zhangguotao05-zgt/iwatch/README.md

# iwatch

基于 SF32LB58、RT-Thread 和 LVGL 9.4 的智能手表项目。当前硬件验证平台为 SF32LB58-DevKit-LCD A128R32N1，显示模组为 390×450 QSPI AMOLED（CO5300 + FT6146）；自研原理图选型为 SF32LB586VDD36。

工程说明统一采用 HTML：

- [文档首页](index.html)
- [架构复审与开发基线 v1.1](docs/ui/架构复审与开发基线_v1.1.html)
- [功能逻辑与页面契约](docs/ui/功能逻辑与页面契约_v1.html)
- [模块接口、开发任务与测试矩阵](docs/ui/模块接口与开发任务_v1.html)
- [系统架构 v1.1](docs/ui/系统架构_v1.1.html)
- [视觉与交互规范 v1](docs/ui/视觉与交互规范_v1.html)
- [Apple Watch 设计指南研究与项目适配](docs/ui/Apple_Watch设计指南研究与项目适配_v1.html)
- [Apple Watch 界面复刻定稿 v2（首批七页施工入口）](docs/ui/Apple_Watch界面复刻定稿_v2.html)
- [Apple Watch 功能差距与复刻验收矩阵（当前差距、视觉问题与 D14–D18 清单）](docs/ui/Apple_Watch功能差距与复刻验收矩阵_v1.html)
- [实施与验收记录](docs/ui/实施与验收_v1.html)
- [D01–D03 板上验收记录](docs/ui/D01-D03_实施记录.html)
- [D04–D05 时间与最小服务实施记录](docs/ui/D04-D05_实施记录.html)
- [D06 显示目标与会话亮度实施记录](docs/ui/D06_显示目标与会话亮度实施记录.html)
- [D07 资源预算与共享组件设计方案 v2](docs/ui/D07_资源预算与共享组件设计方案_v2.html)
- [D07-A0 工具与安全链实施记录](docs/ui/D07-A0_工具与安全链实施记录.html)
- [D07-A1 字体替换与渲染修复记录](docs/ui/D07-A1_字体替换与渲染修复记录.html)
- [D07-B 字体服务与主题实施记录](docs/ui/D07-B_字体服务与主题实施记录.html)
- [D07-C 共享组件与页面回收实施记录](docs/ui/D07-C_共享组件与页面回收实施记录.html)
- [D07-D 组件展示与综合验收记录](docs/ui/D07-D_组件展示与综合验收记录.html)
- [D08 页面作用域与路由实施记录](docs/ui/D08_页面作用域与路由实施记录.html)
- [D09 双键语义与输入仲裁实施记录](docs/ui/D09_双键语义与输入仲裁实施记录.html)
- [D10 首批七页实施记录](docs/ui/D10_首批七页实施记录.html)
- [D11 计时器与秒表实施记录](docs/ui/D11_计时器与秒表实施记录.html)
- [D12 闹钟与全局提醒实施记录](docs/ui/D12_闹钟与全局提醒实施记录.html)
- [D13 系统覆盖层与表盘管理设计 v2](docs/ui/D13_系统覆盖层与表盘管理设计_v2.html) · [390×450 页面视觉目标](docs/ui/D13_系统页面视觉目标_v1.html) · [D13-C 锁与输入仲裁实施记录](docs/ui/D13-C_锁与输入仲裁实施记录.html) · [D13-D 表盘会话与总体收口实施记录](docs/ui/D13-D_表盘会话与总体收口实施记录.html)
- [Series 11 界面覆盖计划](docs/UI复刻计划_watchOS26.html)
- [固件构建与调试](firmware/README.html)
- [硬件原理图 v0.3](hardware/原理图_v0.3_封装与接口完善/阅读说明.html)

开发任务使用 [GitHub Issues](https://github.com/zhangguotao05-zgt/iwatch/issues) 跟踪。任务实际开始时才创建对应的 Dxx Issue；完成后补齐提交、主机测试、双工具链和开发板证据，再以 `completed` 关闭。D01–D05 已按此规则补录为 [#1–#5](https://github.com/zhangguotao05-zgt/iwatch/issues?q=is%3Aissue+is%3Aclosed+label%3Atask)；[D06 · #6](https://github.com/zhangguotao05-zgt/iwatch/issues/6) 已完成；[D07 · #7](https://github.com/zhangguotao05-zgt/iwatch/issues/7) 已通过并关闭。性能遗留项由 [#8](https://github.com/zhangguotao05-zgt/iwatch/issues/8) 独立跟踪，[D08 · #9](https://github.com/zhangguotao05-zgt/iwatch/issues/9) 已按“接受已知风险”批准收口；[显示异常 #10](https://github.com/zhangguotao05-zgt/iwatch/issues/10) 保持打开，允许接续 D09。

D08 按“接受已知风险”收口，验收基线 `5c51f54`、固件源码 `82ab706`：基础实现及已验证功能通过，负责人同意将显示异常独立跟踪并继续 D09。首轮半黑半白转入 [#10](https://github.com/zhangguotao05-zgt/iwatch/issues/10)，仍未定位、后续未复现；性能遗留继续跟踪 [#8](https://github.com/zhangguotao05-zgt/iwatch/issues/8)。首次异常、采集缺口和原始证据保持封存，此决定不代表显示异常已修复或产品发布验收通过。

D01–D03 已完成页面生命周期、BSP/分区/双工具链来源、GUI 等待/唤醒和输入取消实现，并在开发板上完成备份、三件套写入校验、冷启动、输入压力、显示超时恢复和黑屏触摸唤醒验收。D04/D05 已完成时间、启动协调、32 B 命令、48 B 结果、固定账本与快照，并通过主机、双工具链及开发板校时、软件复位和断电冷启动验收；断电后 RTC 正确失效，服务使用 TRNG 生成非零 31 位随机 session，该值只降低碰撞概率，不作为唯一性或安全保证。DEV_A128_NAND 的 main 位于 `0x69000000`，必须与同一归档的 Bootloader、FTab 成套烧录。

D06 已实现 `SET_BRIGHTNESS`、目标/实际/持久状态、最新目标 mailbox 和 GUI owner 驱动确认；只有 LCD 状态、busy、写入后状态及亮度回读全部通过才返回 `OK_APPLIED`。首次显示、触摸 reassert 与故障恢复均读取当前目标，亮度 revision 饱和时失败无副作用。持久值仍明确为会话状态，真实 NAND 保存留 D15。最终 GCC main 为 5,745,568 B，双工具链身份、三件套写后校验、20%/80% 实屏变化、故障结果、软件复位和输入压力均已通过开发板复验。

D07 v2 已以 `967483d` 为批准基线。D07-A1 已获架构审批通过，收口提交为 e064686。D07-B 已获架构阶段验收通过（审批基线 7dfd90d）。D07-C 已获架构阶段验收通过（审批基线 c8392a9）。D07 已获最终审批（基线 9088f52，固件源码 5d66e58），Issue #7 已关闭。触摸溢出取消整改通过；长文延迟与溢出频率转入独立性能待办 #8，历史最大 215 ms 保留，不宣称全面性能达标。D08 已按“接受已知风险”批准收口（验收基线 5c51f54，固件源码 82ab706）；显示异常转入 Issue #10，未定位、后续未复现，性能遗留继续跟踪 Issue #8，允许开始 D09 输入，随后推进 D10 正式界面。 D07 验收时字体为 336 字符、56,804 B；D10 已扩展为 389 字符、65,752 B，并完成首轮上板和首次校时整改复验。A1 最终整改镜像在 20%/80% 下文字与操作正常，8 次进出后的主堆和字形池均回到启动值；这条是 A1 历史证据。详见 [安全整改记录](docs/ui/D07-A1_安全整改与复验记录.html)。`flash1` 的 FAL 持久化、低功耗和长期测试仍未关闭。

D09 已获架构审批通过（审批基线 `042ba6f`、固件源码 `05fb667`），[Issue #11](https://github.com/zhangguotao05-zgt/iwatch/issues/11) 按 completed 收口。已修复 Home 动画停住与水锁触摸穿透，主机、双工具链、当前镜像实体双键及 20%/80% 通知回归通过。详见 [D09 实施记录](docs/ui/D09_双键语义与输入仲裁实施记录.html)。主堆小幅波动、最大 133 ms 队列延迟、六次触摸溢出及 #8/#10 边界保留，允许进入 D10；本次收口不重新烧录。

D10 的七页、校时和亮度服务已接入。源码 `7cc8bcf` 补齐选择器拖动吸附、大字号重排、真实字体换行、绘制批次采样及本轮外观反馈；主机、GCC／Keil 和 COM9/COM10 板测均已完成。已补三轮表盘／应用列表／设置五页往返与 V08 首绘、停顿、诊断开销对照，结果提交架构复核；跨页转场降级、#8 性能、#10 显示异常及 `flash1` 持久化继续保持跟踪；D10 当前范围已获架构审批通过，Issue #12 已收口，详见 [界面完善与复核交接](docs/ui/D10_界面完善与复核交接.html)。

D11 已按审批基线 `d2a0691`、固件源码 `e6fc348` 收口，Issue #13 按 completed 关闭，允许进入 D12。容量释放后按钮恢复、原版与补丁 SDK 隔离、主机回归、双工具链身份及 COM9／COM10 实机复验均通过；精确竞态由主机测试覆盖，实机验证的是满额→取消→再次新增。正式字体仍为 406 字符、69,004 B。#8 性能、#10 显示异常与持久化继续独立跟踪；闹钟及提醒输出归 D12。详见 [D11 实施记录](docs/ui/D11_计时器与秒表实施记录.html)。

D12 已按审批基线 `62f0686`、固件源码 `9fa21c8` 在“会话内闹钟＋全局视觉提醒”范围收口，Issue #14 按 completed 关闭。[实施与验收记录](docs/ui/D12_闹钟与全局提醒实施记录.html)分别归档初版、三项状态整改及独立审批。#8 性能、#10 显示异常和 D15 持久化继续跟踪；声音、振动、断电保存及长期稳定性不属于本次验收。允许进入 D13。

D13-A 以 `c7617c2` 获架构批准，D13-B 增量已完成控制中心、通知、叠放和切换器实现。D13-C 锁与输入仲裁增量以源码 `49d461f` 完成架构复核和开发板验收：实体 KEY2 可打开控制中心，普通锁／水锁均支持 KEY1 长按约 2 秒并真实松手解锁，锁页和控制中心正确销毁并返回根页；水锁下的触摸与 KEY2 屏蔽已通过板上诊断注入验证。实体触摸面板本轮未单独确认，不能把诊断注入写成实体触摸通过。详细边界见 [D13-C 记录](docs/ui/D13-C_锁与输入仲裁实施记录.html)。

D13-D 的代码修正提交为 `a2e61fd`：长按进入选择器，支持 DIGITAL/MODULAR_LOCAL 两个稳定表盘 ID、颜色/中心/左右快捷入口草稿、取消、revision 冲突和能力失败回滚；提交成功后同步根页模型，Home 与 Apply 同周期时撤销 pending，tick 从 0 开始也能触发 3 秒超时回滚。表盘候选只有在根页异步 `ONRESUME` 成功且稳定快照确认后才提交，请求拒绝、异步失败、故障回收和重复返回均回滚。主机产品矩阵、46 项隔离 clean-base Python 门禁已通过；GCC/Keil 已重新构建并生成绑定源码 HEAD、工具链和 SDK 的身份归档，GCC/Keil `main.bin` 分别为 1,952,020 B/1,877,184 B。与 `e324f14` 归档绑定的 GCC 三件套已经由 COM9 写入并校验，COM10 原始日志 `work/d13d-board-e324/serial.raw` 为 28,798 字节，SHA-256 为 `d9d2854aa2c0c0c49d02c86ec2c536194fb0019b8b0038cd65306e40db8303de`；正确的 `iwface/root` 表盘编辑、根页异步提交确认、取消和重复进出均已实机记录。`2892732` 是实机证据基线，`8587d13` 是文档内容基线，`b7d51aa` 是状态提交；D13-D 已获架构复核通过，`main` 已推送；Issue #15 暂不关闭。#8 性能、#10 显示异常和 D15 持久化继续保持打开。详见 [D13-D 记录](docs/ui/D13-D_表盘会话与总体收口实施记录.html)。

Apple Watch 功能范围与复刻差距已单独整理为 [功能差距与复刻验收矩阵](docs/ui/Apple_Watch功能差距与复刻验收矩阵_v1.html)。工程师按矩阵中的 A/B/C/D/E 状态、D14–D18 顺序和“主机／目标构建／实机”三层证据推进；知乎文章仅作功能索引，不把规划清单或示意图当作已实现页面。联网、支付、健康传感器算法、触感／音频和量产硬件能力仍不属于当前离线 UI 交付。
