zhangguotao05-zgt/iwatch/hardware/自研智能手表_离线阶段方案_v0.4.html

iwatch 自研智能手表：离线第一阶段 v0.4

# 自研智能手表：离线第一阶段 v0.4

更新日期：2026-09-22。本阶段以本版为准，v0.3 的联网/官方应用整机路线保留为后续参考。当前 UI 复刻和 D13-D 实机验证基线见功能差距与复刻验收矩阵。

推荐：SF32LB58 + 配套 AMOLED + RT-Thread/LVGL + 真实心率血氧模块。先开发板验证，再做自研主板和新外壳。

阶段边界：表盘、系统壳层和离线工具可先做界面与空态；健康、运动、联网、支付、触感和音频必须等对应硬件/Provider 验证后再写成真实能力。当前实机固件验证使用 A128R32N1，文中 N16 仍是采购规划，不能混写。

## 当前做什么

- Apple Watch 风格的表盘、蜂窝图标、列表、控制中心、设置和动画。
- 表冠旋转/按压、触摸、侧键、振动、抬腕和休眠。
- 本地时间、闹钟、计时器、秒表；手动或有线校时。
- 真实心率、静止血氧、计步与活动记录，保存在本机。
- 后段设计自己的主板、健康传感板和外壳。

Wi-Fi、4G/eSIM、云服务、官方微信/支付宝、通话和在线应用不纳入本阶段。蓝牙硬件随 SF58 保留，第一阶段先不开发同步功能，整机按无线关闭条件验收。ECG、腕温、NFC、GNSS 和复杂健康算法后续再集成。

## 主控与第一批采购

采购规划选择 SF32LB58-DevKit-LCD，N16R32N1，配套 AMOLED 套餐。这块板适合本阶段的显示、触摸和传感器开发；官方提供资料与 USB 转 UART 烧录/调试方式。当前 D13-D 实机证据使用的是 A128R32N1 / A1 变体，构建、分区和资源结论必须绑定实际板卡。SF58 开发板官方指南 (https://wiki.sifli.com/board/sf32lb58x/SF32LB58-DevKit-LCD.html)

N16R32N1 使用 16 MB NOR，A128R32N1 使用 128 MB NAND，PSRAM 配置同为 16+16 MB。本阶段优先 NOR 版本，减少首轮文件系统与存储调试工作。现有 SDK 工程应匹配实际板卡版本和屏幕。SiFli 模组型号指南 (https://wiki.sifli.com/silicon/%E6%A8%A1%E7%BB%84%E5%9E%8B%E5%8F%B7%E6%8C%87%E5%8D%97.html)，SiFli SDK (https://github.com/OpenSiFli/SiFli-SDK)

采购时应选择包含“DevKit+AMOLED屏”的套餐，并确认配套转接板、排线、触摸驱动、可编译示例和烧录文件。页面截图中的价格与选项不能作为该组合的有效报价。首批物料为板屏套件和数据线，先验证原厂触摸/显示例程；健康模块在显示链路稳定后接入。

开发板本身不具备心率/血氧测量能力，需要外接健康硬件。

## 屏幕与流畅度

截图中的小屏为 1.85 英寸、390×450、QSPI 显示、I2C 触摸。开发板支持 MIPI-DSI，但这不代表配套小屏就是 MIPI。先用配套屏把 UI 做起来，目标仍是 60 fps，然后测真实帧率、触摸延迟与功耗。

QSPI 50 MHz、4 bit、SDR 的理论吞吐量为 25 MB/s。390×450 一帧 RGB888 为 526,500 byte，单纯传输约 21.06 ms，已超过 60 fps 的 16.67 ms 周期；RGB565 若能在线上传输 16 bit/pixel，理论传输约 14.04 ms，实际仍需开销与渲染时间。只有屏幕控制器和驱动支持对应总线像素格式，16 位传输预算才成立；内部用 RGB565 渲染不等于线上一定传 16 位。

先测试 DMA、图形加速、局部刷新、帧缓冲布局和动画复杂度。若配套屏无法满足关键全屏动画，再评估 MIPI 面板与驱动。MIPI 升级是换屏/转接/驱动工作，不是把原 QSPI 屏的软件设置改一下。显示接口能力见 SF58 硬件设计指南 (https://wiki.sifli.com/en/hardware/SF32LB58x-HW-Application.html)。

## 健康链路保留

采用上一版已经复核的 MAXM86146 + 外部 LED + LSM6DSO 候选。先评估 MAXM86146EVSYS 的固件/GUI 和实际供货，再连接 SF58。MAXM86146 内含光学 AFE、算法 MCU 和双 PD，仍需要发光器件、运动样本和光学隔离。MAXM86146 产品页 (https://www.analog.com/en/products/maxm86146.html)，MAXM86146EVSYS (https://www.analog.com/en/resources/evaluation-hardware-and-software/evaluation-boards-kits/maxm86146evsys.html)

LSM6DSO 由 SF58 采集，再按算法支持的主机供数协议送入健康模块，必须核对固件版本、采样率、单位、坐标和同步。不要复制已停产的 LIS2DS12；也不要把新 IMU 当成算法内部驱动的直接替代。ADI 加速度兼容性 FAQ (https://ez.analog.com/other-products/a/documents/do21669/what-accelerometers-are-supported-by-the-max32664c-firmware)，ST LSM6DSO (https://www.st.com/en/mems-and-sensors/lsm6dso.html)，ST LIS2DS12 (https://www.st.com/en/mems-and-sensors/lis2ds12.html)

健康输出分清原始波形、算法数值和质量标志。先验证静止测量、佩戴松紧及无效状态，再优化运动心率。参考血氧仪的对照仅作工程一致性检查，不把它当作完整临床精度验证。UI 演示阶段的数据须标为示例，实测界面只显示有效测量。

## 自研板怎么落地

第一块自研板建议采用 SF32LB58-MOD-N16R32N1 模组 + 自研载板，模组为 24×24 mm；载板连接屏幕、健康板、表冠、马达、电池与充电电路。待接口、功耗和体积明确后，再决定紧凑版是否使用 SF32LB586VDD36 裸芯片。模组已经包含的内存和晶体不应重复装配。SiFli 模组型号指南 (https://wiki.sifli.com/silicon/%E6%A8%A1%E7%BB%84%E5%9E%8B%E5%8F%B7%E6%8C%87%E5%8D%97.html)

主系统先按最高 240 MHz 运行验证，后续按负载降频。外部时钟为 48 MHz 与 32.768 kHz；供电按 SF58/模组参考设计处理。SF30147C 为可穿戴电源候选，充电器/电芯参数另外匹配，不直接把电池接到任意 1.8 V/3.3 V 电源脚。SF32LB58X 产品页 (https://www.sifli.com/zh-hans/node/29)，SF58 硬件设计指南 (https://wiki.sifli.com/en/hardware/SF32LB58x-HW-Application.html)

资源初值：两块 RGB565 全屏缓冲约 0.67 MiB；暂为图形资源/缓存留 8 MiB、应用堆 2 MiB，实际按分散的 PSRAM 区域与 SDK map 文件分配。内部 SRAM 保留给栈、DMA/实时工作区，不能把总 PSRAM 当成一块可随意分配的连续堆。16 MB 外部 NOR 暂按固件 6 MiB、界面资源 6 MiB、摘要/配置 2 MiB、余量 2 MiB 规划，最终以链接与文件系统结果调整；原始 PPG 调试数据优先导出 PC，不长期堆积在 NOR。

续航以实测为准。400 mAh、3.85 V、85% 可用系数仅作为预算假设；24 h 目标对应约 54.5 mW 平均电池侧功耗。没有联网仍需优化显示、PPG、唤醒和漏电；开发板电流不能直接当作最终手表电流。

## 顺序与完成标准

阶段 | 工作 | 完成标准
1 | 板屏例程、烧录与日志 | 可从源码编译，屏幕/触摸稳定，有恢复下载路径
2 | 自研 UI、表冠、LRA | 蜂窝/列表/表盘可操作，记录帧时延，验证休眠唤醒
3 | IMU 与健康评估板 | 有真实数据及质量标志，供数同步稳定，保存本地摘要
4 | 载板、健康板、外壳样件 | 完成电压域检查、3D 堆叠、封壳功耗和佩戴测试

调试时用 UART 日志、逻辑分析仪检查 I2C/QSPI/中断，结合 DMA/FIFO 计数检查丢样和撕裂。中断只通知任务；UI、传感器采集和存储分任务处理。测试栈/堆高水位、掉电记录恢复、闹钟与看门狗，保留 BOOT/RESET/UART/SWD 调试点。

后续如只增加天气/健康同步，可继续评估 SF58 的通信扩展；如重新要求官方微信和支付宝应用，需再次核实系统与平台接入，不能承诺只加网络硬件就能实现。

本版完成范围与选型更新，尚未采购或进行硬件测试。未核实的价格保持空缺；配套 Excel 为选型 BOM，原理图完成后再展开生产位号和无源器件。

iwatch 工程文档 · SF32LB58 / RT-Thread / LVGL
