zhangguotao05-zgt/iwatch/hardware/4mm磁吸母头封装/使用说明.html

iwatch 4mm 磁吸母头 PCB 封装草稿 R01

# 4mm 磁吸母头 PCB 封装草稿 R01

已按项目存档的机械 PDF 制作嘉立创 EDA 专业版封装草稿。所有表格和设计参数的单位为 mm。 本文为可编辑的工程草稿：侧脚厚度和底座外径包含按图形比例得到的估算值，槽孔中心距属于初始设计取值，投板前必须按实物复核。

## 导入与使用

1. 在嘉立创 EDA 专业版选择 文件 → 导入 → 嘉立创EDA（专业版）。
2. 首选导入 4mm磁吸母头_嘉立创专业版_封装草稿.epro。它含一个放置了该封装的 PCB 预览页，未画生产板框。
3. 导入时可提取封装库；也可打开工程后，在工程库中找到 CON-MAGNETIC-F-4MM-TH_DRAFT_R01 并另存到自己的封装库。
4. 同目录的 .efoo 是独立封装源码；支持独立封装文件的导入界面可直接选择它。
5. 后续在器件编辑器绑定封装，按实际电气连接映射焊盘编号。

导入流程依据：嘉立创 EDA 专业版官方导入说明 (https://prodocs.lceda.cn/cn/import-export/import-easyeda-pro/)。 本次完成了本地文件结构与几何校核，未声称已在 EDA 编辑器里导入成功或通过原生 DRC。

## 焊盘定义

PCB 顶视图，原点为中心针，X 向右，Y 向上。尺寸均为旋转后的实际 X/Y 尺寸。

编号 | 位置 | 中心 X | 中心 Y | 铜尺寸 X × Y | 孔尺寸 X × Y | 孔型
1 | 中心针 | 0 | 0 | Ø1.40 | Ø0.80 | 镀铜圆孔
2 | 左侧脚 | -1.70 | 0 | 1.50 × 2.50 | 0.90 × 1.90 | 镀铜长圆槽孔
3 | 右侧脚 | +1.70 | 0 | 1.50 × 2.50 | 0.90 × 1.90 | 镀铜长圆槽孔

槽孔尺寸为两端外缘之间的完整尺寸，不是铣刀移动行程。原生源码用 SLOT + OVAL 并旋转 90° 表示竖向槽；三个焊盘均为 Multi-Layer，孔壁镀铜。 所列孔径是封装中的设计孔径，实际成品孔及公差需和板厂确认。 本图没有电气定义：1/2/3 是本草稿的物理编号，未指定正负极，也未把两侧脚强制设成同一个编号或网络。确认两侧共通后，可在原理图接至同一网络并核对符号映射。

## 图纸标注与推算依据

图纸直接标注：上台阶 Ø4.00、接触端孔 Ø1.10、本体高 3.50、台阶高 1.30、出脚长 2.00、中心针 Ø0.50、侧脚宽 1.25、侧脚外圆弧 R2。

图形比例推算：以已标注的 Ø4.00、Ø0.50 及 1.25 为比例交叉参照，底座直径约 Ø5.00，侧脚内圆弧半径约 1.50，径向壁厚约 0.50。R2 标注的箭头尖落在侧脚外弧，不是最外侧底座圆。

侧脚是圆弧截面，不能简单把 0.50 × 1.25 矩形当作完整脚形。按推算的内 R1.50 / 外 R2.00、Y=±0.625 截取，右侧脚 X 包络约为 1.364～2.000。因此槽孔中心暂取 X=±1.70，孔宽/长取 0.90 × 1.90，给圆弧脚形留出插入空间。 3.40 mm 是所设计两槽孔的中心距，不是厂家图纸直接标注的侧脚中心距。

按这一推算截面采样，脚形到槽孔边界的名义最小余量约 0.091 mm；该结果不含器件、孔径、位置或装配公差，不能替代实物试装。

## 图层与校核

- 多层：三个镀铜通孔焊盘。顶/底阻焊各外扩 0.05；未添加自定义钢网图形。专业版中通孔焊盘的助焊扩展设置不生效，见官方 API 说明 (https://prodocs.lceda.cn/cn/api/reference/pro-api.ipcb_primitivesoldermaskandpastemaskexpansion.html)。
- 顶层丝印：Ø5.60，线宽 0.15，位号 J?。
- 顶层装配层：本体约 Ø5.00 / 上台阶 Ø4.00 的参考轮廓。
- 文档层：中心针、推算侧脚截面、脚号及 DRAFT - VERIFY FIT 标记。
- 自定义 Courtyard_REF 层：6.20 × 6.20 参考占位框。它是参考线框，不是电气禁布区，也不保证自动参加 DRC。

计算检查：最小焊环 0.30，异焊盘铜间距 0.25，阻焊桥 0.15，丝印到阻焊开窗最小间距约 0.153。 已核对三焊盘唯一编号、镀铜属性、槽孔旋转、mil/mm 换算、压缩工程完整性及工程内封装一致性。未完成 EDA 原生导入/DRC 或实物试装。

## 下一步复核

制作正式 PCB 前，测量底座外径、两侧脚截面/位置，试装孔位，并测通确认中心针和两侧脚之间的电气关系。 如参数改变，可编辑 封装参数.json；生成脚本使用工作目录 tools/magnetic-4mm-footprint/config.json，同步相应值后运行 build_footprint.py、render_review.py 重新生成。 详细数值见 焊盘尺寸_mm.csv 与 校核记录.json。预览 PDF/PNG 由同一个原生封装文件独立渲染，不是 EDA 截图。

iwatch 工程文档 · SF32LB58 / RT-Thread / LVGL
