zhangguotao05-zgt/iwatch/hardware/CWS05屏幕与佩戴版修订评估/评估与修订方向.html

iwatch 评估与修订方向

CWS05 屏幕与佩戴版修订评估 · 2026-09-11

这份文件记录新的设计输入与选型方向，不是已修改完成的 EDA 原理图。当前在线电路仍是 v0.3，原有屏幕接口不能直接用于 CWS05。

屏幕：适合作为接下来的选型候选，不能按现有接线直接替换。

依据项目采用的 CWS05 v1.0、2024-06-13 规格书，已核查 P4~P12 及 P15 的相关尺寸、供电、针表、时序、光学参数和寿命说明；P5 的原始机械图也单独提取放大核查。

项目 | 文件内容 | 对设计的影响
面板 | 1.85英寸、390×450、QSPI | 保留 SF32LB58；RGB565 单帧351000字节，双帧702000字节，不含UI资源及其它内存
外形 | 含盖板总体约35.22×42.50×2.46mm，P5 CG标注与P4表对应 | FPC弯折、接头与其上器件仍需额外空间；不能把屏幕外形当可用板框
显示/触摸 | CO5300AF + CST820 | 触摸不能沿用 FT6146 选项
接口 | 24针，P5有QSPI四根数据线 | 取消表内2×20调试排针；须锁定实际配对连接器，不能只按针数选FPC座
IO | P5注明1.8V；P6数字电源正常1.7~1.9V | v0.3 LCD/TP所在PA电源域为3.3V，必须验证1.8V引脚映射方案或加入合适的电平转换
PMIC | P5标BV6802；P8的11/12脚VBAT典型3.7V | 要核实外部供电范围；不能把原转接板+5V接到VBAT

官方 SiFli SDK 中已有 CO5300 显示驱动 (https://github.com/OpenSiFli/SiFli-SDK/tree/main/customer/peripherals/display/co5300) 与 CST820 触摸驱动 (https://github.com/OpenSiFli/SiFli-SDK/tree/main/customer/peripherals/touch_panel/cst820)。这是移植起点，不等同于已验证 CWS05 实物。图纸中的60Hz是面板测试帧率，不是我们的UI全屏刷新率保证。

需要补齐的直接设计输入：

- 配对连接器完整料号、朝向、高度及可读机械图。当前图中的局部连接器型号不足以可靠选型。
- VBAT允许范围、15脚VDD与16脚TP_VDD的外部供电要求、24脚VCI_EN究竟是使能还是电源输入。
- P8漏列18脚；P5明确列TP_RST。8脚ID、9/10脚接口模式/NC的处理按最终确认针表执行。
- CWS05专用的初始化序列及QSPI上/下电时序。P9/P10的显示时序图带MIPI标注，不能把它当作完整的该模组QSPI时序资料。

P6的ELVDD/ELVSS、VDD/VEE等包含面板内部工作电源，不能直接推导为主板要各产生一条电源。P12在600nit全白条件下列了200h寿命项；P15以亮度下降到某比例（举例95%）定义寿命，不能解释为200小时后损坏。具体衰减阈值、长期常亮指标和整模组VBAT输入电流仍需供应商确认。

四个直插按键：佩戴版不应保留四个原型号。

位号 | 现有网络/用途 | 佩戴版处理
SW101 | RESET_N，复位主控 | 保留探针可达的复位接点，调试夹具操作
SW102 | BOOT_MODE，配合复位进入下载模式 | 保留启动模式接点和正确上下拉，调试夹具操作
SW401 | SIDE_SW_N / PB52，侧键 | 按表壳选小型侧按器件或侧键软板
SW402 | HOME_N / PB54，Home/唤醒输入 | 计划并入J402的表冠按压；需核对PB51的低功耗唤醒能力或调整GPIO，然后改固件与电路

J402已单独预留CROWN_A、CROWN_B和CROWN_SW_N（PB51）。因此表冠按压加一个侧键可以作为外部交互方案，SW402无需再做一个独立实体键。复位/下载功能保留，但不占四个直插按键的体积。

封装：改为0201优先评估，按电气需求允许较大封装。

本文0402/0201均为英制：0402本体约1.0×0.5mm，0201约0.6×0.3mm。仅比较本体面积为0.50和0.18mm²，后者小64%；焊盘、间距、过孔和走线占用不会按同一比例下降。

- 低功耗上拉/下拉、分压、信号电阻：0201优先，核对功率、电压、精度与可采购料号。
- 100nF等小电容：0201优先，核对实际偏压下有效容量、介质与芯片去耦要求。
- 1µF：在0201与0402之间逐项核算；不能只按标称容量和耐压判断。
- 4.7~22µF储能、电源环路电容：按有效容量、稳定性和纹波选0402/0603/0805。
- 电源0Ω跳线、LED脉冲电流路径、串联电阻：按额定电流、I²R及温升评估，不能自动缩小。

村田说明高介电常数MLCC在直流偏压下有效容量可能下降，应用必须按实际条件验证：官方说明 (https://www.murata.com/en-us/support/faqs/capacitor/ceramiccapacitor/char/0005)。0201的焊盘、钢网、贴装和返修也必须与工厂匹配；本设计已有0.4mm球距BGA，不能再以便于普通手焊作为全板选型的主要标准。

已将现有101个阻容位号按上述规则整理成候选清单，尚未赋予未经验证的新料号。0402并非必然放不下，但最终板框、双面高度、FPC弯折和BGA扇出没有验证，不能承诺仅换0201就能装入表壳。

实施顺序：确认屏幕电源与接头资料 → 更新1.8V显示/触摸接口 → 清理调试实体按键 → 锁定0201及例外料号 → 在真实板框和高度限制下试摆、扇出和验证。

iwatch 工程文档 · SF32LB58 / RT-Thread / LVGL
