zhangguotao05-zgt/iwatch/hardware/SJ056_N极母座封装/使用说明.html

iwatch SJ-056 N极母座2.0 — 嘉立创 EDA 专业版封装草稿

# SJ-056 N极母座2.0 — 嘉立创 EDA 专业版封装草稿

依据项目存档的《N极母座2.0.PDF》制作。型号 SJ-056，本体直径 4.00 mm、高度 2.00 mm；这是同心圆表面贴装母座。所有尺寸单位为 mm。

## 导入

在嘉立创 EDA 专业版选择 文件 → 导入 → 嘉立创EDA（专业版），导入 SJ056_N极母座_嘉立创专业版_封装草稿.epro。 工程中含一个放置了该封装的 PCB 预览页。导入时可提取封装库，也可在工程库找到 CON-MAGNETIC-SJ056-N-D4-H2-SMD_DRAFT_R01，另存至自己的封装库后绑定器件。 同目录 .efoo 为独立封装源码，支持独立封装导入的界面可直接选择它。

流程依据：专业版官方导入说明 (https://prodocs.lceda.cn/cn/import-export/import-easyeda-pro/)。本次未实际启动 EDA 完成导入和原生 DRC，不能把本地几何检查视为导入成功记录。

## 电气与焊盘

图纸的“贴片焊盘正极”箭头指向中心接触面，“贴片焊盘负极”箭头指向外侧圆环。封装原点是同心圆中心。

焊盘号 | 电气定义 | PCB 铜形状 | 铜外径 | 铜内径 | PCB 孔
1 | 正极 | 中心实心圆盘 | 1.40 | 0 | 无
2 | 负极 | 连续同心圆环 | 3.90 | 2.10 | 无

均在顶层。负极圆环用两个微量重叠的半圆环异形焊盘组成，两个图元都编号 2，铜形状合并后为连续圆环；不能把这两个半环独立重编号。两个半环的连接锚点位于各自铜区，避免将负极连接锚点放进中心正极。 “N极”是磁极标识，不是电气负极的依据；电气极性按本图的明确标注映射。

图纸上的 Ø0.50 是器件自身孔，不是 PCB 安装孔。 本封装未放置任何钻孔或过孔；中心 PCB 铜为实心圆盘，Ø0.50 只作为文档层参考轮廓。

## 图纸尺寸与设计取值

项目 | 图纸直接标注 | 本次 PCB 设计
中心正极接触面 | 外 Ø1.30，孔 Ø0.50 | 铜 Ø1.40，无 PCB 孔
外环负极接触面 | 外 Ø3.70，内 Ø2.30 | 铜外 Ø3.90，内 Ø2.10
本体 | 外 Ø4.00，高 2.00 | 装配层 Ø4.00 参考轮廓
正面配合结构 | Ø2.20 / Ø1.00 | 非 PCB 焊盘尺寸

原图 R1.85 / R1.15 分别与 Ø3.70 / Ø2.30 一致。本次没有使用上一款插件母头的脚距、长圆孔或未知极性设置。 铜盘相对中心接触面径向加宽 0.05；负极环内外边缘各向接触面外扩 0.10。它们是为编辑和装配评审提出的设计值，并不是供应商给出的推荐 PCB land pattern。

## 阻焊与钢网

- 顶层阻焊各边外扩 0.05：中心开窗 Ø1.50，负极环开窗约外 Ø4.00 / 内 Ø2.00。
- 正负铜间距 0.35；最小阻焊桥 0.25。
- 取消焊盘自动助焊开窗，使用顶层助焊层的独立填充图形。
- 中心正极分 4 个环形扇区开窗，外 Ø1.30 / 内 Ø0.60，每窗 70°，最窄连接桥约 0.104。
- 外环负极分 4 个环形扇区开窗，外 Ø3.60 / 内 Ø2.40，每窗 82°，最窄连接桥约 0.167。

分段让钢网中央区域保留连接桥，中心开窗避开器件 Ø0.50 孔；钢网孔不是 PCB 钻孔。 钢网厚度和回流工艺未设定，开窗是初始草案，需结合试焊和供应商工艺调整。图纸仅提到 PA46 胶料可过回炉，未提供整件（含磁铁）的回流温度曲线。 异形焊盘、圆环及自定义锡膏层设置参考专业版官方 PCB 说明 (https://prodocs.lceda.cn/cn/faq/pcb/)。

## 布局注意与验证

完整负极环包围中心正极，中心线不能在顶层跨过负极铜环。在 PCB 布局阶段为 1 脚安排换层引出；本封装不预设板层和过孔。若采用盘中孔，需配合填孔/盖帽等具体板厂工艺，避免把普通敞口过孔直接当作稳定的贴片焊接面。 专业版的盘中孔工艺说明见官方扇出布线文档 (https://prodocs.lceda.cn/cn/pcb/route-fanout-routing/index.html)。

顶层丝印 Ø4.50，线宽 0.12，位号 J?；丝印与阻焊开窗的最小间距为 0.19。 Courtyard_REF 自定义层有 5.00 × 5.00 参考占位框，这是图形参考框，不是自动电气禁布区。 文档层保留图纸接触面、器件小孔轮廓、极性和草稿标记，装配层保留本体外形。

已从保存后的原生封装重新解析圆弧和焊盘，完成 5040 个点位检查，覆盖 720 个角度，确认负极连续成环且不占据中心区；另校核钢网位于对应铜面内并避开器件中心孔、两个逻辑引脚、零 PCB 钻孔、文件结构及压缩工程完整性。 未执行 EDA 原生导入/DRC、PCB 完整布线检查、实物尺寸公差确认或回流试焊。 预览 PDF/PNG 由实际 .efoo 图元独立渲染，是审阅图，不是 EDA 截图。

文件中的 封装参数.json 为参数快照。工作脚本位于 tools/magnetic-n-pole-2mm-footprint/，修改该目录 config.json 后，顺序运行 build_footprint.py、render_review.py 可重新生成。详见 焊盘尺寸_mm.csv 和 校核记录.json。

iwatch 工程文档 · SF32LB58 / RT-Thread / LVGL
