zhangguotao05-zgt/iwatch/hardware/佩戴版封装尺寸审查/封装尺寸审查.html

iwatch 封装尺寸审查

佩戴版封装尺寸审查 · 2026-09-11

结论：不能确认 v0.3 能放进目标手表。现有版本完成的是原理图与封装绑定，未完成按表壳约束的布局、布线与高度验证。尺寸审查已覆盖保存版本的 153 个位号；本次没有修改在线 EDA 或现有生产文件。

下表为保存工程中“本体外形图与铜焊盘”的联合外接矩形，单位 mm，不含走线、插拔空间、元件高度和装配间距。本体外形图也可能含按键执行部位。不能把这些矩形简单相加或除以两面，作为可制造 PCB 的面积。

器件 | 当前尺寸/数量 | 处理方向
J401 屏幕排针 | 50.8×5 | 必须移出表内；最终按实物裸屏资料选 FPC 接口
J201 USB-C | 9.64×7.93 | 优先移至充电座，表内充电触点与输入保护另做设计
SW101/102/401/402 | 各 4.5×4.5，4 个直插件 | 调试键改夹具；侧键、表冠按结构重选
U104 外部 NOR Flash | 5×6.5；本体 6×5 | 优先评估同系列 3×3 mm USON，供电、供货和固件兼容性一并核对
U502 触觉驱动 | 5.85×3 | 评估同系列 DSBGA，重新映射管脚和审核焊盘
电容 | 41 个英制 0603，其中 18 个 1 µF | 1 µF 优先评估 0402；其余按实际有效容量决定
电阻/小电容 | 37 个 0402 电阻、21 个 0402 电容 | 已是小封装；局部按需求评估 0201
C702/C703 | 2 个 0805、22 µF/10 V | 先验证 LED 脉冲负载与偏压容量，不能统一缩小
U1 主控 | 8.5×6.5，0.4 mm 球距 | 保留，先做局部去耦与 BGA 扇出验证
L301/L302/L303 | 各 3.03×3 | 缩小前审查饱和电流、DCR、温升和纹波

全部位置的上述矩形简单相加为 830.4 mm²；仅 J401、USB-C 和四个直插按键就占其中 411.4 mm²。这个数只用于指出优化优先级，不是单面/双面板的最小面积结论；穿孔器件还会占用另一侧的空间。DNP 位置保留焊盘时仍占布局空间。

替换依据：TI 官方资料列有 DRV2605L 的 YZF 9 球 DSBGA 与 DGS 10 引脚 VSSOP 两种封装；因此缩小方向可行，但并非原封装直接替换。TI 产品资料 (https://www.ti.com/product/DRV2605L)。普冉官方 PY25Q128HA 产品页列有 USON8 3×3×0.55 mm，可作为 Flash 的优先缩小方向；仍需锁定可采购订货码并重新核对焊盘和供电。普冉产品资料 (https://www.puyasemi.com/en/h_series653/3187.html)。本次没有把候选写成已完成采购验证的替代料。

下一轮落地顺序：

1. 用屏幕总成、FPC 弯折区、电池、表冠、LRA、PPG 后盖组件建立壳内空间与禁布区；46 mm 是整表外形目标，不是 PCB 可用边长。
2. 拿掉表内的大排针和调试按键，确定充电接口，再形成小型化 BOM。电源芯片本身多数已为约 1.5×2 至 3×3 mm 封装，不是所有器件都要换。
3. 在实际可用板框内试摆双面器件，分别核对每一面的可用高度。PPG 必须满足光路和遮光结构，不能只紧密堆放。
4. 局部验证 BGA256 的 0.4 mm 扇出、电源热回路、QSPI 和回流路径，据此与板厂确定层叠、孔型和工艺。不能用“默认两层”或“上六层就一定能放下”作为结论。
5. 完成器件外形/高度模型、结构干涉检查和关键布线可行性后，才确认板尺寸并进入正式布板。

目前可明确排除的是“把现有验证板按原封装直接作为佩戴版”；还不能给出已验证的最小 PCB 长宽。缺少的是空间输入和实际布局验证，不能用面积估算替代。

逐位号细节见同目录 CSV；审查来源与工程 SHA256 见 JSON。当前电路不因本次审查而更改。

iwatch 工程文档 · SF32LB58 / RT-Thread / LVGL
