zhangguotao05-zgt/iwatch/hardware/原理图_v0.2_裸芯片/阅读说明.html

iwatch 自研手表原理图 v0.2：SF32LB58 裸芯片版

# 自研手表原理图 v0.2：SF32LB58 裸芯片版

日期：2026-09-11。状态：可编辑原理图初稿，尚未完成 PCB 和硬件实测。

本版取消 SF32LB58 成品核心模块，主控改为 SF32LB586VDD36 封装芯片直接焊在自研主板上。开发板仅用于 UI 开发，最终产品不依赖核心模块。

立创 EDA 私有工程：在线私人工程未随仓库公开；请导入随附的 .epro 文件。

## 主控方案

项目 | 本版设计
主控 | U1：SF32LB586VDD36，BGA256、0.4 mm 间距、8.5 × 6.5 mm 封装
封装内存储 | 两组 16 MB PSRAM，共 32 MB；另含 1 MB NOR Flash
外部资源存储 | U104：PY25Q128HA-WXH-IR，16 MB QSPI NOR，3.3 V
时钟 | 48 MHz 主晶振、32.768 kHz RTC 晶振；主核最高 240 MHz，首板从保守配置调试
内核供电 | 展开内部两路 BUCK 的外置电感、电容，以及三路 LDO 旁路电容
电压域 | PA12–93 固定 3.3 V；PB/PBR、PA0–11 为 1.8 V；SiP 存储供电为 1.8 V
调试 | 1.8 V SWD 与 UART4；RESET_N 上拉到 1.8 V，BOOT_MODE 属于 3.3 V VIOA 域
当前外设 | QSPI AMOLED 适配接口、触摸 I²C、表冠与按键、IMU、LRA 驱动、心率/血氧光学电路
当前软件范围 | 离线 UI 和本地传感器；未启用网络或蓝牙射频功能

## 图页导航

页码 | 图页 | 内容
1 | BARE CHIP PMU | 裸芯片内部电源的外置电感和去耦
2 | CHIP POWER DOMAINS | I/O、模拟、SiP 电压域及对应 BGA 焊球旁路电容
3 | CLOCK RESET AND DEBUG | 两颗晶振、复位、启动模式、SWD、UART
4 | SIP AND RESOURCE FLASH | 封装内 PSRAM 电源开关、外部 16 MB NOR 与电源开关
5 | BATTERY AND CHARGER | 电池、USB-C 充电输入、BQ24074
6 | POWER RAILS | 1.8 V、3.3 V、可控 5 V 电源
7 | DISPLAY AND CONTROLS | 当前开发套件屏幕转接接口、触摸、表冠、按键
8 | IMU AND HAPTICS | LSM6DSO、DRV2605L、LRA 接口、电池采样
9 | PPG MODULE | MAXM86146 封装传感器 IC 及外围；这里并非购买一块 PPG 成品 PCB
10 | OPTICAL EMITTERS | 红光、红外、绿光 LED 及 MAX14689 切换网络
11 | SPARE GPIO BALLS | 未使用 GPIO 焊球
12 | GROUND AND UNUSED ANALOG | 全部地/参考返回焊球、未使用模拟与总线接口

所有图页中的 U1 是同一颗芯片的不同符号单元，BOM 只计一颗。模块的 138 个焊盘编号已改为实际 BGA 的 256 个焊球编号。

## 电路依据与本版处理

- 引脚清单提取自思澈官方 PADS 原理图，焊球集合另与官方 PCB 封装的 256 个焊盘核对；关键供电与接口对照 DS5801 V1.8.3。
- 两个 BUCK 各有 4.7 µH 电感，旁路及反馈节点分别展开；三个 LDO 输出只接电容，不并接外部电源轨。
- B4/B5（VDD_EXT）按官方内部 PMU 参考电路留空，采用外部内核供电模式时必须重新核对。A3/A4 按数据手册 VSS 定义接地。合计 44 个地与参考返回焊球已表示。
- SiP PSRAM 电源由 PBR0 控制，封装内 NOR 的 VDDIOSC 保持 1.8 V 供电。外部资源 NOR 由 PA74 控制电源，MPI4 使用 PA30/36/37/38/39/40，延用官方 N16R32N1 参考连接。
- PY25Q128HA 是 3.3 V 器件。本版去掉原来 VIOA 任意切换到 1.8 V 的选项。后续若换成仅支持 1.8 V 信号的裸屏，需要增加电平转换，或重新选 Flash 并分配电压域。
- 晶振负载电容位暂不装配，不能按习惯直接装 12 pF 或 22 pF；按所选 CL、芯片设置和板上寄生参数测量校准。
- 旧版显示、充电、传感器等 305 个外围物理引脚的网络对应保持一致。光学网络保留已核对的 LED1_DRV → GREEN1_K 连接。

## 验证状态

本地模型检查已通过：12 页、137 个唯一器件、697 个物理引脚、100 个命名网络。每个引脚均明确接线或留空，没有重复物理引脚，没有单端命名网络。

独立参考核对已通过：BGA 焊球集合、BUCK/LDO 拓扑、复位和启动电压域、Flash 六根信号、存储电源开关、外围连接继承，以及原生 EPRO 内的符号/器件/封装引用完整性。记录见 validation-reference.json。这些是电路模型和文件检查，不等于 DRC 通过，也不等于已验证硬件能够运行。

立创 EDA 已成功导入本版 12 页，2026-09-11 16:11:32 的 DRC 结果为：44 条缺少封装的致命项、1 条主控引脚/焊盘未对应错误、6 组悬空警告（合计 171 个已标明留空的引脚）、2 条信息。44 个未绑定封装的符号实例对应 35 个物理器件，包含 U1 的多单元符号；主控引脚/焊盘对应同样尚待 BGA 封装绑定完成。因此本版 DRC 未通过。结果记录见 validation-eda.json。

PDF 由与 EPRO 相同的本地电路模型渲染，12 页已检查排版；它不是宣称由立创 EDA 导出的 PDF。

## 仍需完成

1. BGA 与其他 IC、晶振、MOS、连接器封装核对及绑定，PCB 叠层与 BGA 扇出。没有生成可生产 PCB/Gerber。
2. 屏幕 FPC 的确切型号、针脚、接口电压和上电顺序；当前仍是开发套件屏幕适配接口，不是已定型的整机屏幕排线。
3. 电池、NTC、LRA 和光学结构的具体料号及尺寸；核心芯片与 Flash 的小批量供货也未作采购承诺。
4. 对未使用引脚添加 EDA 非连接标识并完成 DRC；本版 NC 文字本身不会抑制悬空引脚告警。
5. 按新板配置 BSP：pinmux、SiP/Flash 电源控制、存储映射、启动时序和时钟。开发板 UI 可以继续开发，移到自研板时需要这些底层调整。

首板调试按顺序完成电源和晶振测量、复位/下载、片上与 PSRAM 存储测试、外部 Flash 读写、屏幕触摸、传感器与振动，再测活动及休眠电流。以上硬件测试尚未执行。

UI 内存预算参考：390 × 450、RGB565 的单帧缓冲为 351,000 字节，双缓冲为 702,000 字节，约 686 KiB；这只是帧缓冲，不包含纹理、字体、LVGL 对象、RTOS 栈及算法工作区。两组 PSRAM 不能在未检查 BSP 和 DMA 可访问性前视为任意连续内存。

## 主要原厂资料

- SF32LB58x 硬件设计指南 (https://wiki.sifli.com/en/hardware/SF32LB58x-HW-Application.html)
- 思澈芯片与模块资料入口 (https://wiki.sifli.com/en/silicon/index.html)，DS5801-SF32LB58x V1.8.3；关键引脚表 5-4、订购信息表 5-8。
- 官方模块内部原理图、BOM 与 PCB 源文件 V1.0.1 (https://downloads.sifli.com/hardware/files/documentation/SF32LB58-MOD-V1.0.1.zip)。本版借用其芯片外围电路作为参考，不购买或保留该核心模块。
- SF32LB58-DevKit-LCD 开发板指南 (https://wiki.sifli.com/board/sf32lb58x/SF32LB58-DevKit-LCD.html)
- 普冉 PY25Q128HA 产品资料 (https://www.puyasemi.com/en/h_series653/3187.html)

其余原厂链接保留于 BOM 与各器件 Datasheet 属性。旧版工程保留以供对照；后续裸芯片修改以本 v0.2 工程为基础。

iwatch 工程文档 · SF32LB58 / RT-Thread / LVGL
