zhangguotao05-zgt/iwatch/hardware/原理图_v0.3_封装与接口完善/PCB实施约束.html

iwatch v0.3 PCB 实施约束

# v0.3 PCB 实施约束

当前先准备可以调试的自制主板。最终佩戴版还需裸屏 FPC、表壳、电池、表冠和光学组件的机械数据。不要用 2×20 转接板排针的外形去冻结 46 mm 整表结构。

## PCB 开始前要冻结的输入

输入 | 已知内容 | 尚需锁定
主控 | SF32LB586VDD36，256 球，0.4 mm pitch，8.5×6.5 mm | 板厂可接受的层叠、BGA 扇出、孔型与阻焊能力
显示 | 1.85 英寸 390×450 QSPI 套装；首板使用随附转接板 | 实物转接板版本/朝向；最终裸屏 FPC 图纸、时序和尺寸
电池 | 受保护单节锂电包，4.2 V 充电，真实 10 kΩ NTC | 容量/体积/充放电限值/NTC B 值及接线
触觉 | DRV2605L + 两线 LRA 接口 | LRA 额定电压、频率、尺寸、安装方式
表冠 | A/B 编码 + 按压，1.8 V GPIO | 具体器件、手感、轴向尺寸、防水结构
光学 | MAXM86146、SFH7015、两颗 CT DBLP31.12 | LED/PD 间距、遮光墙、后盖窗口、皮肤接触面

## 放置顺序和回流

1. 先放 U1 和局部电源/时钟，按官方参考原理图与硬件指南安排芯片每个电源球的去耦。原理图上的同名网络允许跨页连接，PCB 上不能把所有电容随意堆在一处。
2. L101/L102、PMU 输入电容和反馈输出电容围绕对应 BGA 球安排。SW 区域短小，反馈从输出电容端取样，不穿过开关热回路。
3. U301/U302/U303 与各电感、输入/输出电容组成局部紧凑回路。5 V LED 脉冲地回流避开 PPG、ADC 和晶体附近。
4. 48 MHz、32.768 kHz 晶体靠近引脚；不要跨地分割，不在晶体下/旁穿高速或开关节点。外部负载电容是否装配以指定晶体和芯片负载设置为准。
5. U104 靠近主控资源 Flash 引脚。QSPI 时钟/数据返回路径连续，依据板层和实际频率决定阻抗/串阻需求；本版没有预设不存在的串阻。
6. PPG 与 LED 的顶/底视方向不能混淆。图库采用顶视坐标，器件翻到底层由 EDA 完成；不要在原始封装中再次镜像。绿光 LED 的 2、3 脚均是阴极。
7. J101、16 个测试点安排在可接近的位置。电池、表冠和 LRA 当前是板上焊线/探针焊盘，不是已选定的插接件。
8. USB-C、按键金属外壳和可触及部分的放电回路结合机壳设计，必要的 TVS/ESD 和限流元件须选型后补入原理图再同步 PCB。

## 封装与工艺注意项

- 主控 BGA 焊盘直径 0.25 mm、相邻球位间距 0.4 mm，局部铜间隙 0.15 mm。此数值只是焊盘之间的距离，不等于已证明能从所有内排扇出。
- 主控、PPG OLGA/WLP 焊盘的坐标已对照官方设计文件；小间隙的阻焊桥、钢网厚度、开口缩减及空洞率尚需制造审查。
- TI 电源/触觉封装按器件手册推荐 land pattern 建立。U104 普冉 WSON 和 U501 ST LGA 为依据官方机械尺寸延伸的工程焊盘，应在下单前复核贴装厂的 land pattern 建议。
- 目前 EP 焊盘没有完成生产钢网分窗/热过孔方案；不能直接把整块 paste 开口视为最终工艺。
- 自建封装中的 assembly 辅助框用于识别外形，并非已经完成的装配间距规则。3D 模型尚未建立；实体碰撞和高度不会由这次原理图 DRC 自动发现。
- C702/C703 已采用 0805，但 22 µF/10 V 的字样不能代替厂家偏压曲线。整板各输出电容均要按实际电压、温度、容差审查有效容量。
- 铜皮、过孔、板框、孔位、回流路径、约束驱动布线和 PCB DRC 仍属下一阶段；没有可下单 Gerber。

## 阶段验收

原理图已通过当前 EDA DRC。本地还检查了 256 个主控球位、所有位号的引脚/焊盘集合和新封装内部铜焊盘重叠。在线工程已新增 PCB1，并从 EDA 的完整 PCB 源码窗口核对：U1 只有一颗，153 个位置、726 个焊盘网络、100 个命名网络、179 个有意悬空焊盘；完整引脚网络指纹与本地原理图模型一致。PCB1 为未布线准备稿，默认双层文档/规则只是编辑器初始设置，并不是已选好的制造层叠。接下来仍需机械约束、布局、扇出、布线、覆铜和 PCB DRC。首板回板后按上电文档逐个功能启用。

iwatch 工程文档 · SF32LB58 / RT-Thread / LVGL
