zhangguotao05-zgt/iwatch/hardware/SJ056_N极母座封装/SJ056_N极母座_封装尺寸预览.pdf

# SJ-056 · N极母座 2.0

嘉立创 EDA 专业版 | R01 | Ø4.00 × H2.00 mm | 同心圆贴片封装

草稿 · 待装配验证

PCB 顶视图 · 顶层铜 | 单位：mm
J?

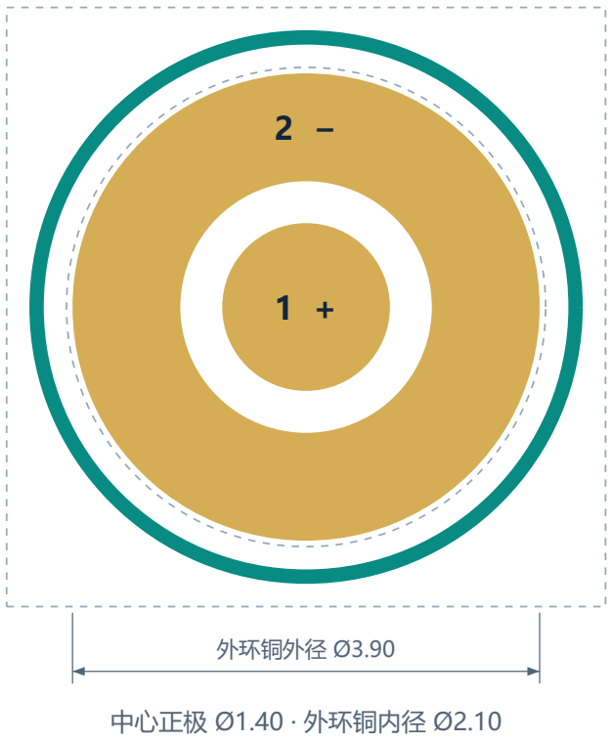
[picture p1: figure]
外环铜外径 Ø3.90; 中心正极 Ø1.40 · 外环铜内径 Ø2.10

铜焊盘 | 丝印 Ø4.50 | 本体 / 占位
| 原点 = 同心圆中心；参考占位框 5.00 × 5.00

## 图纸与 PCB 设计尺寸

项目 | 图纸接触面 | PCB 铜尺寸
中心正极外径 | Ø1.30 | Ø1.40
负极环外径 | Ø3.70 | Ø3.90
负极环内径 | Ø2.30 | Ø2.10

PCB 为表面贴装，无钻孔、无预放过孔。

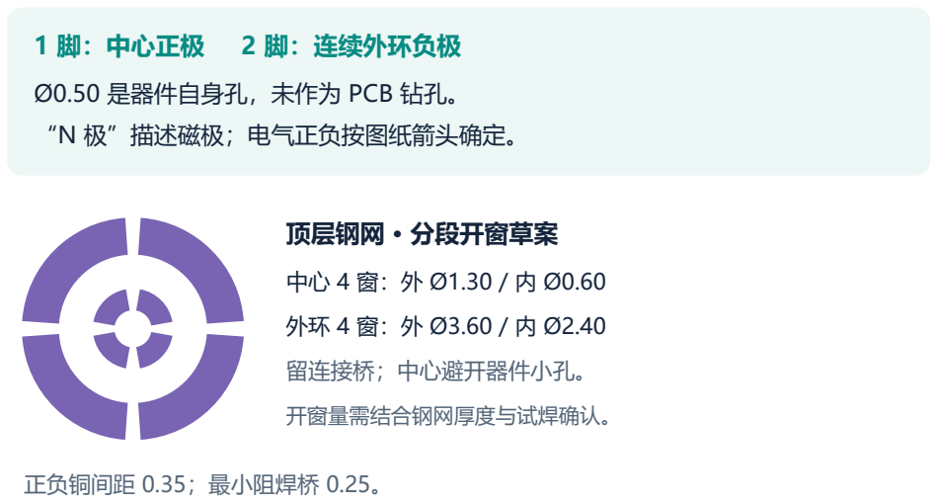
[picture p2: figure]
1 脚：中心正极; 2 脚：连续外环负极; Ø0.50 是器件自身孔，未作为 PCB 钻孔。; “N 极”描述磁极；电气正负按图纸箭头确定。; 顶层钢网 · 分段开窗草案; 留连接桥；中心避开器件小孔。; 开窗量需结合钢网厚度与试焊确认。; 正负铜间距 0.35；最小阻焊桥 0.25。

中心正极需换层引出，布局时安排相应过孔工艺。

已校核圆环连续性、中心隔离、钢网开窗及文件结构。尚未在 EDA 内验证导入或进行实物试焊。

来源：用户提供的《N极母座2.0.PDF》，SJ-056。PCB 铜、阻焊及钢网尺寸为本次设计取值。

2026-09-11 / 1
