zhangguotao05-zgt/iwatch/hardware/原理图_v0.3_封装与接口完善/HealthWatch-SF58-v0.3-裸芯片原理图审阅.pdf

# HealthWatch-SF58-BareChip-v0.3 | 01 BARE CHIP PMU

U1 = SF32LB586VDD36 BGA256 | internal buck/LDO support | never apply battery voltage to the 1.8 V rails
REV 0.3 | 2026-09-11 | SCHEMATIC DRAFT / NOT FOR FABRICATION | Named nets connect across sheets. Cross = EDA no-connect flag.

U1
SF32LB586VDD36

PVDD_PMU1

B2

PVDD_PMU2

B3

PMU_BUCK1_VSW

C1

PMU_BUCK1_VOUT

D1

PMU_BUCK2_VSW

A2

PMU_BUCK2_VOUT

B1

HPSYS_LDO_VOUT

D2

LPMU_VDD07_RET

C4

LPMU_VDD11_RTC

C5

VDD_EXT1

B4

VDD_EXT2

B5

+1V8

+1V8

CORE_BUCK1_SW

CORE_BUCK1_FB

CORE_BUCK2_SW

CORE_BUCK2_FB

CORE_LDO_HP

CORE_LDO_RET

CORE_LDO_RTC

L101
4.7uH DCR<=0.4R Isat>=0.5A
CORE_BUCK1_SW | CORE_BUCK1_FB

C101
4.7uF/10V
CORE_BUCK1_FB | GND

C102
100nF/10V
CORE_BUCK1_FB | GND

L102
4.7uH DCR<=0.4R Isat>=0.5A
CORE_BUCK2_SW | CORE_BUCK2_FB

C103
4.7uF/10V
CORE_BUCK2_FB | GND

C104
100nF/10V
CORE_BUCK2_FB | GND

C105
4.7uF/10V
CORE_LDO_HP | GND

C106
470nF/10V
CORE_LDO_RET | GND

C107
100nF/10V
CORE_LDO_RTC | GND

C108
10uF/10V
+1V8 | GND

C109
100nF/10V
+1V8 | GND

C110
10uF/10V
+1V8 | GND

C111
100nF/10V
+1V8 | GND

L101/C101/C102: BUCK1 VSW -> inductor -> FB. L102/C103/C104: BUCK2 VSW -> inductor -> FB.

The internal LDO nodes only take bypass capacitors. Do not connect them to +1V8 or +3V3.

B4/B5 VDD_EXT remain open as in the official internal-PMU reference. Recheck for any external-core-supply mode.

All 44 ground/reference-return balls are listed on the final sheet; connect to the common ground plane.

Input power comes from the POWER RAILS sheet. Clock/reset and SiP power switching are shown on subsequent sheets.

BGA footprint is bound; stackup, fanout, crystal layout and assembly process still require PCB review.

U1 is a purchased packaged IC soldered directly onto the custom mainboard; there is no core module in this BOM.

# HealthWatch-SF58-BareChip-v0.3 | 02 CHIP POWER DOMAINS

PA12-93 bank fixed at 3.3 V for the selected NOR + kit display adapter | PB / PA0-11 = 1.8 V

U1

C120
1uF/10V
+1V8 | GND

C121
1uF/10V
+3V3 | GND

SF32LB586VDD36; AVDD_BRF; AVDD33_ANA; AVDD33_AUD; AVDD33_USB; AVDD18_DSI; VDDIOA; VDDIOA2; VDDIOB; VDDIOSA; VDDIOSB; VDDIOSC; MIC_BIAS; AUD_VREF; GPADC_VREFP; SDMADC_VREF; VIOA; VDD_SIP; CORE_MIC_BIAS; CORE_AUD_VREF; CORE_ADC_VREF; CORE_SDM_VREF

C122
4.7uF/10V
+3V3 | GND

C123
1uF/10V
+3V3 | GND

C124
4.7uF/10V
+1V8 | GND

C125
1uF/10V
VIOA | GND

C126
1uF/10V
+1V8 | GND

C127
1uF/10V
+1V8 | GND

C128
1uF/10V
VDD_SIP | GND

C129
1uF/10V
VDD_SIP | GND

C130
1uF/10V
+1V8 | GND

C131
1uF/10V
CORE_MIC_BIAS | GND

C132
1uF/10V
CORE_AUD_VREF | GND

C133
4.7uF/10V
CORE_ADC_VREF | GND

C134
4.7uF/10V
CORE_SDM_VREF | GND

R103
0R VIOA=3V3
+3V3 | VIOA

VDDIOSA/B = switched 1.8 V for the two SiP PSRAMs; VDDIOSC = always-on 1.8 V for SiP NOR.

VIOA feeds both the external NOR bus and display/control PA12-93 signals. Do not change to 1.8 V with PY25Q128HA.

A future 1.8 V-only panel requires level translation or a compatible Flash/bank remap; its exact FPC is still pending.

USB/audio/DSI power bypass follows the reference, although those functions are disabled in this offline revision.

Each capacitor has an associated BGA ball in its engineering note; place locally, not as one remote bulk capacitor bank.

GPADC/AUD/SDM reference nodes are capacitor-only; they are not external power inputs.

# HealthWatch-SF58-BareChip-v0.3 | 03 CLOCK RESET AND DEBUG

### 48 MHz + 32.768 kHz crystals | 1.8 V SWD/UART | BOOT_MODE at VIOA = 3.3 V

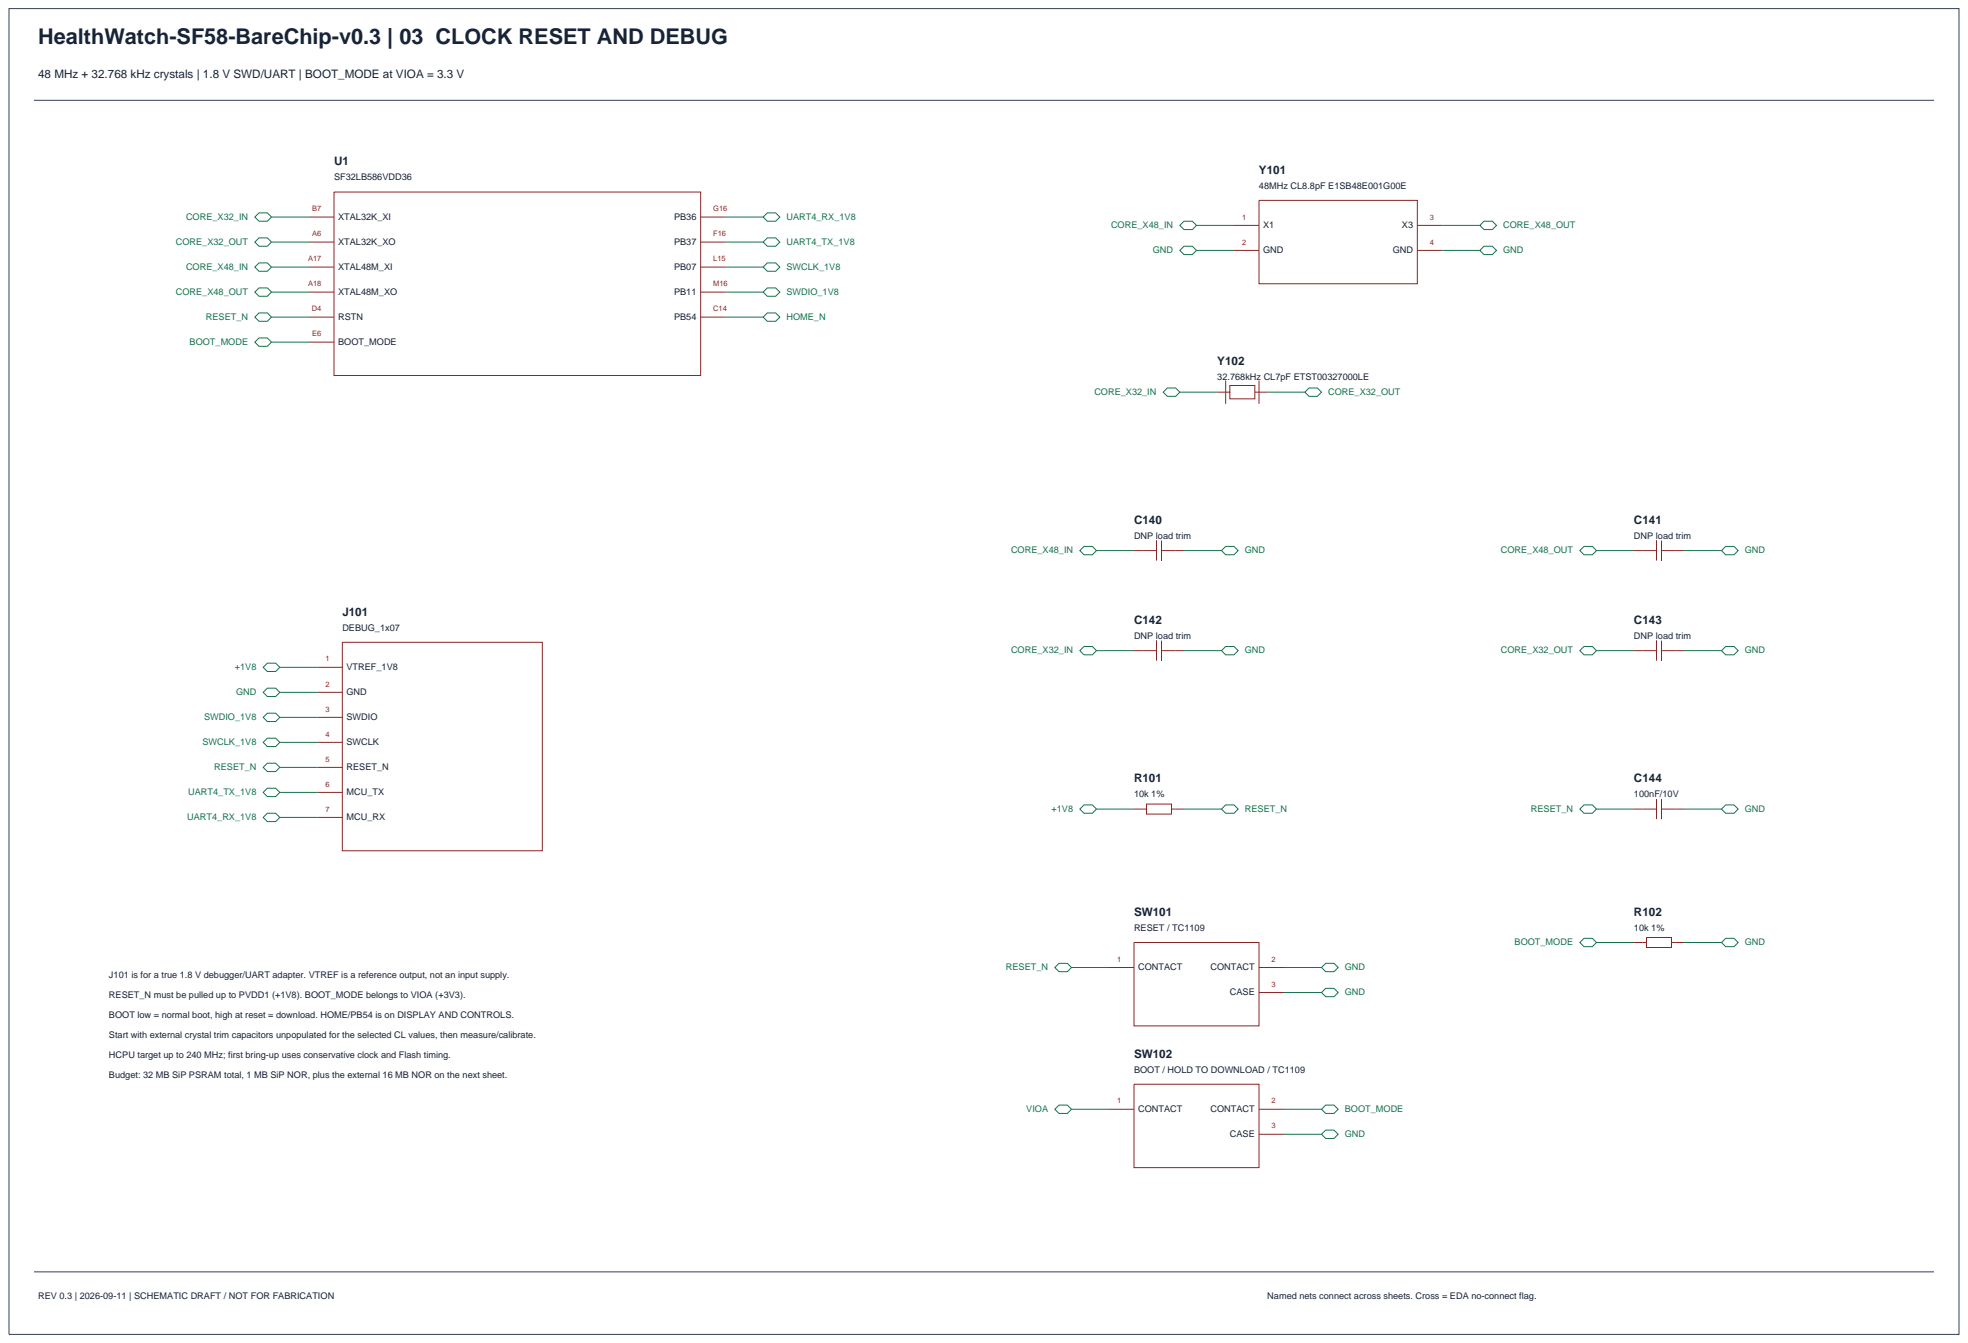
[picture p11: page 3]

J101 is for a true 1.8 V debugger/UART adapter. VTREF is a reference output, not an input supply.
RESET_N must be pulled up to PVDD1 (+1V8). BOOT_MODE belongs to VIOA (+3V3).
BOOT low = normal boot, high at reset = download. HOME/PB54 is on DISPLAY AND CONTROLS.
Start with external crystal trim capacitors unpopulated for the selected CL values, then measure/calibrate.
HCPU target up to 240 MHz; first bring-up uses conservative clock and Flash timing.
Budget: 32 MB SiP PSRAM total, 1 MB SiP NOR, plus the external 16 MB NOR on the next sheet.

BOOT / HOLD TO DOWNLOAD / TC1109

# HealthWatch-SF58-BareChip-v0.3 | 04 SIP AND RESOURCE FLASH

### SF32LB586VDD36 contains 16+16 MB PSRAM + 1 MB NOR | U104 adds 16 MB 3.3 V QSPI NOR

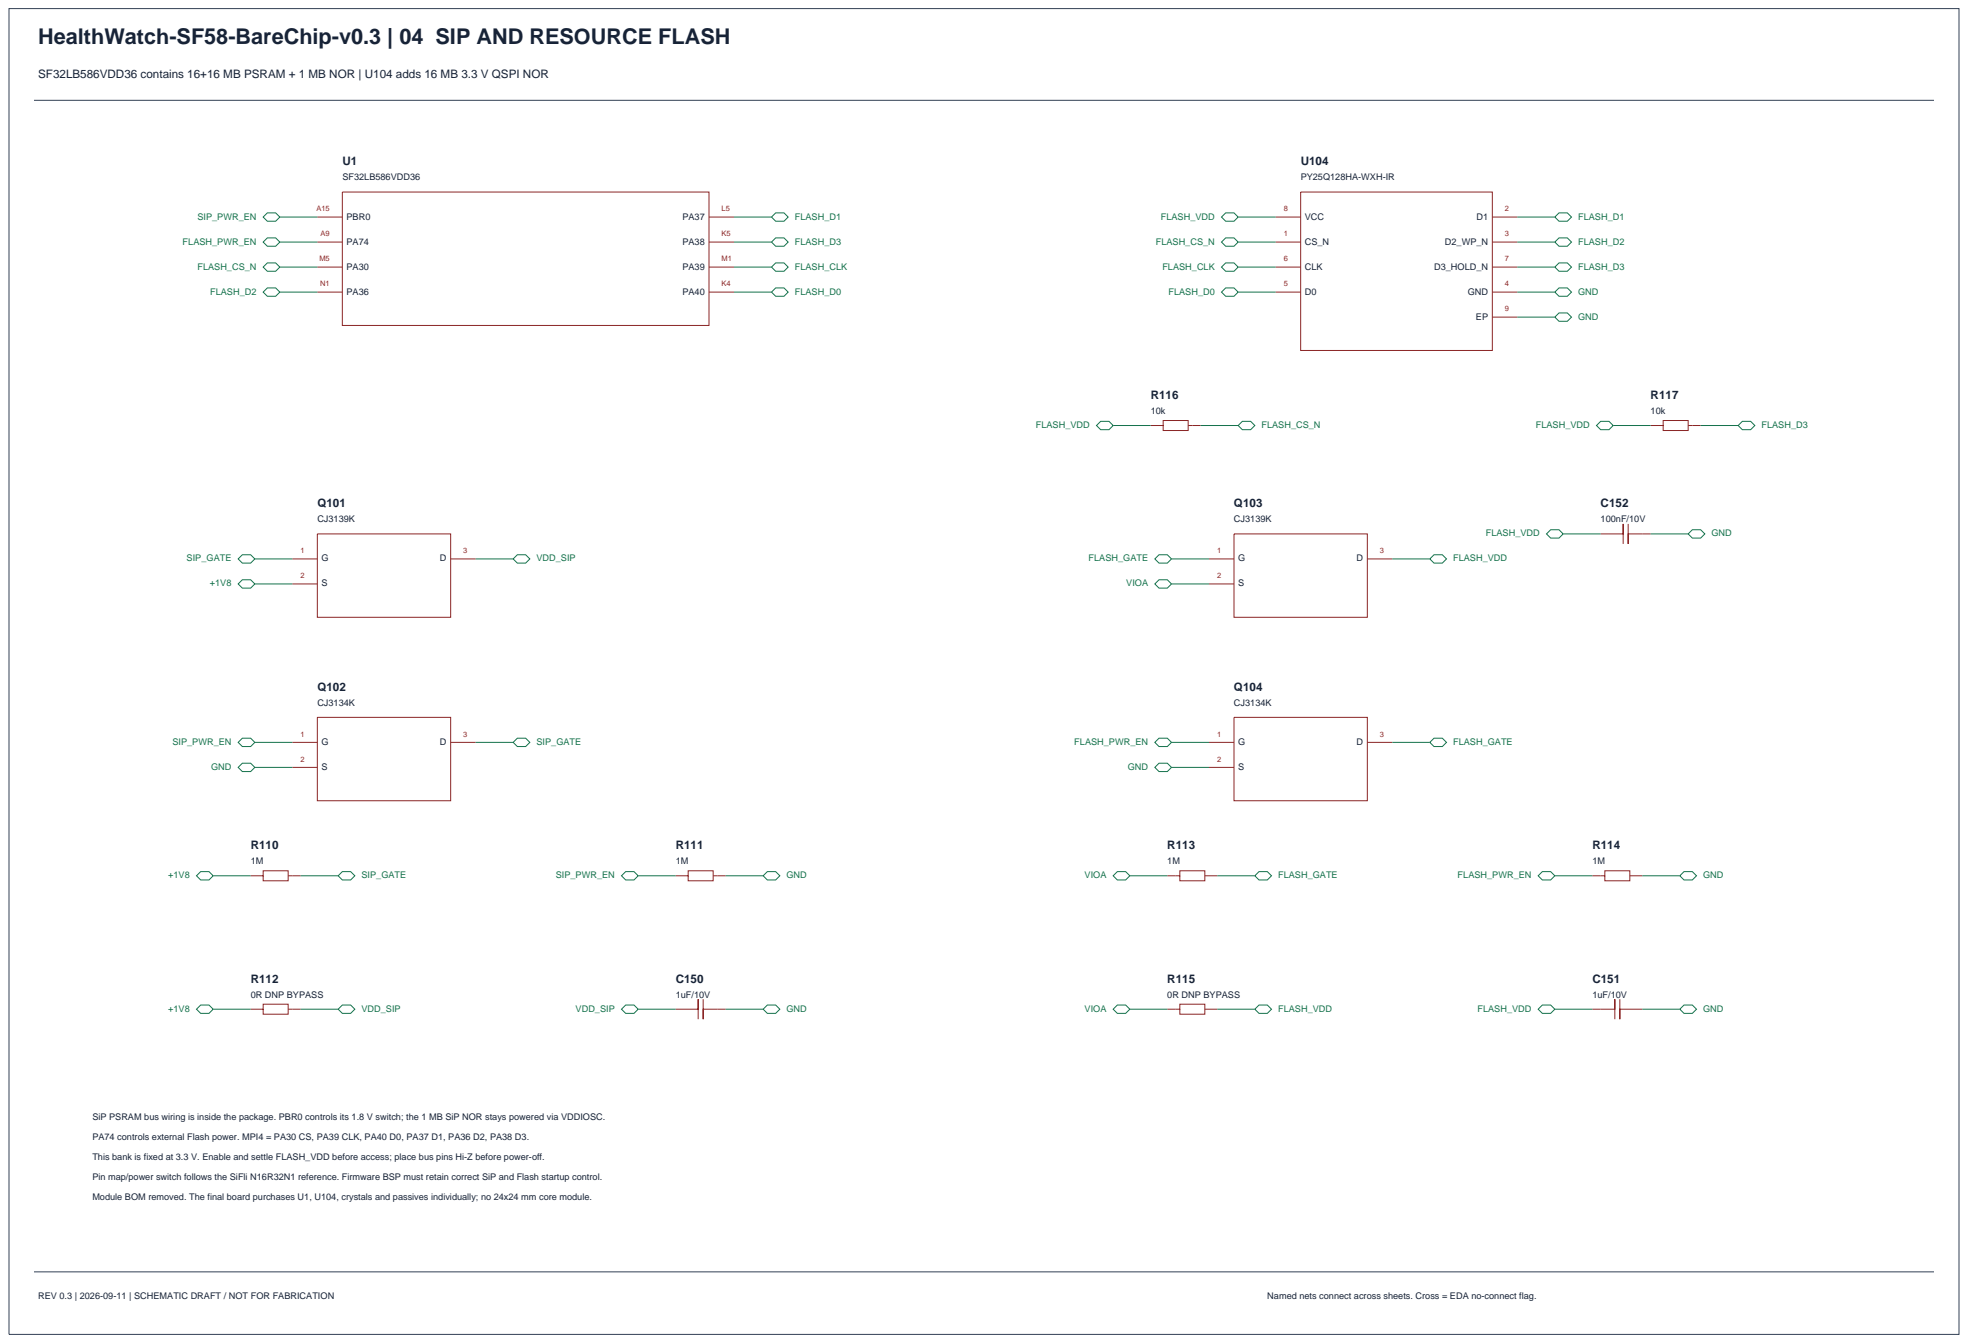
[picture p12: page 4]

SiP PSRAM bus wiring is inside the package. PBR0 controls its 1.8 V switch; the 1 MB SiP NOR stays powered via VDDIOSC.
PA74 controls external Flash power. MPI4 = PA30 CS, PA39 CLK, PA40 D0, PA37 D1, PA36 D2, PA38 D3.
This bank is fixed at 3.3 V. Enable and settle FLASH_VDD before access; place bus pins Hi-Z before power-off.
Pin map/power switch follows the SiFli N16R32N1 reference. Firmware BSP must retain correct SiP and Flash startup control.
Module BOM removed. The final board purchases U1, U104, crystals and passives individually; no 24x24 mm core module.

# HealthWatch-SF58-BareChip-v0.3 | 05 BATTERY AND CHARGER

BQ24074 power path | single-cell 4.2 V charge termination | nominal 128 mA initial charge current

J201

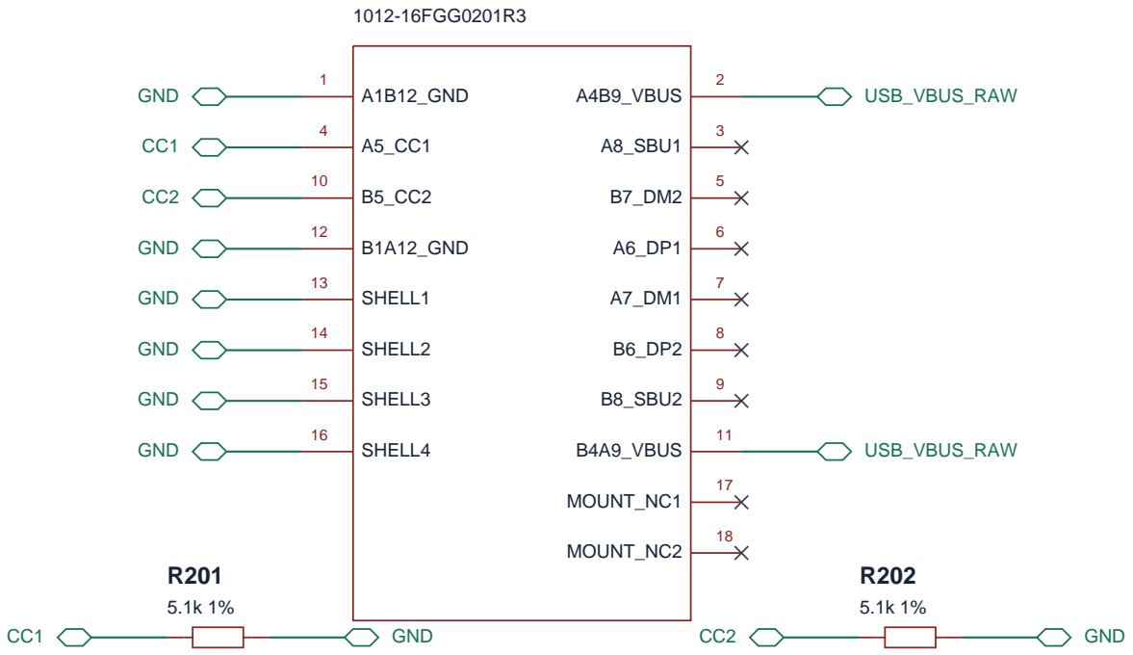
[picture p13: figure]
1012-16FGG0201R3; A1B12_GND; A4B9_VBUS; A8_SBU1; B8_SBU2; B4A9_VBUS; B1A12_GND; SHELL1; SHELL2; SHELL3; SHELL4; MOUNT_NC1; MOUNT_NC2; GND; USB_VBUS_RAW

F201
1206L050/15YR 0.5A 15V
USB_VBUS_RAW | USB_5V

U201
BQ24074RGTR

IN

13

CE_N

4

EN2

5

EN1

6

ILIM

12

ISET

16

TS

1

TMR

14

ITERM

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
PGOOD_N

7

CHG_N

9

VSS

8

EP

17

USB_5V

GND

GND

USB_5V

CHG_ILIM

CHG_ISET

BAT_NTC

VBAT

VBAT

VSYS

VSYS

PGOOD_N

CHG_N

GND

GND

R203
6.98k 1%
CHG_ISET | GND

R204
3.09k 1%
CHG_ILIM | GND

R205
47k 1%
+1V8 | PGOOD_N

R206
47k 1%
+1V8 | CHG_N

C201
4.7uF/16V
USB_5V | GND

C202
10uF/10V
VSYS | GND

C203
4.7uF/10V
VBAT | GND

J202
BATTERY_1x03

PACK+

1

PACK-

2

NTC10k

3

VBAT

GND

BAT_NTC

Battery: protected 1S Li-ion/LiPo, 4.2 V charge rating; nominal 3.7 V.

400 mAh is a planning assumption. Verify max charge current and cell dimensions.

Use a real 10k NTC in thermal contact with the cell; TS is not tied to GND.

Connector polarity and NTC B value must be checked against the selected pack.

USB-C is charge-only. USB data / SBU contacts are not routed in this revision.

I_CHG typ = 890 / 6980 = 127.5 mA (charger / resistor tolerance applies).

EN2=0, EN1=1: fixed 500 mA input mode; use a suitable USB 5 V supply.

ILIM resistor fitted as required even when fixed input mode is selected.

TMR and ITERM open: internal default timer / termination behavior.

VSYS ~ battery voltage on battery; up to 4.4 V with external input.

Protection IC is required in the purchased battery pack; not duplicated here.

# HealthWatch-SF58-BareChip-v0.3 | 06 POWER RAILS

VSYS -> 1.8 V buck, 3.3 V buck-boost, switchable 5 V boost | validate startup and peak current

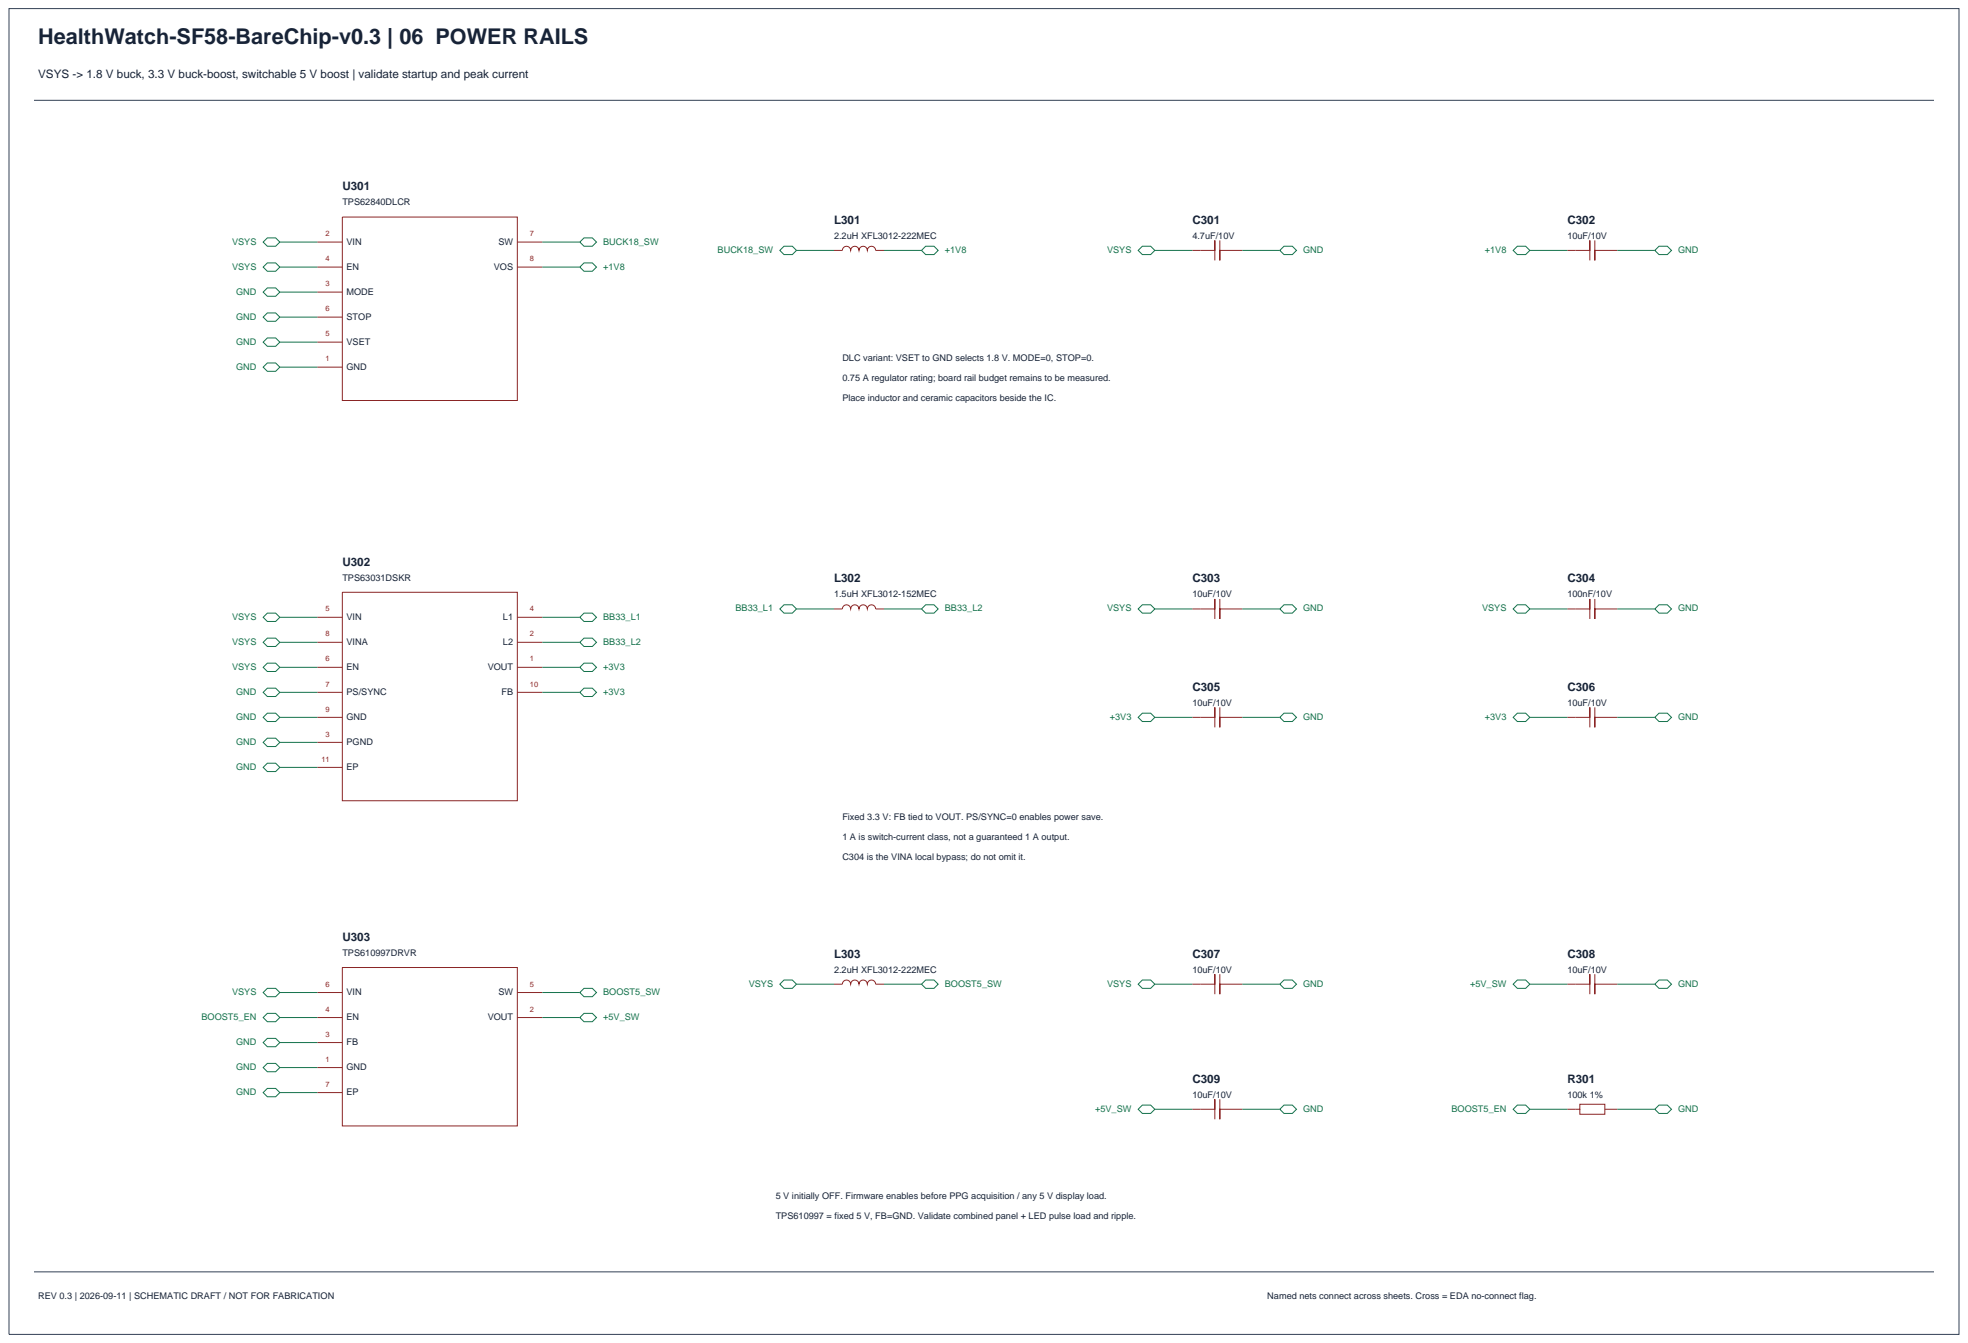
[picture p14: page 6]

DLC variant: VSET to GND selects 1.8 V. MODE=0, STOP=0.
0.75 A regulator rating; board rail budget remains to be measured.
Place inductor and ceramic capacitors beside the IC.

Fixed 3.3 V: FB tied to VOUT. PS/SYNC=0 enables power save.
1 A is switch-current class, not a guaranteed 1 A output.
C304 is the VINA local bypass; do not omit it.

5 V initially OFF. Firmware enables before PPG acquisition / any 5 V display load.
TPS610997 = fixed 5 V, FB=GND. Validate combined panel + LED pulse load and ripple.

# HealthWatch-SF58-BareChip-v0.3 | 07 DISPLAY AND CONTROLS

390x450 QSPI AMOLED + I2C touch | connector matches required SiFli CONN2 signals; panel FPC is not guessed

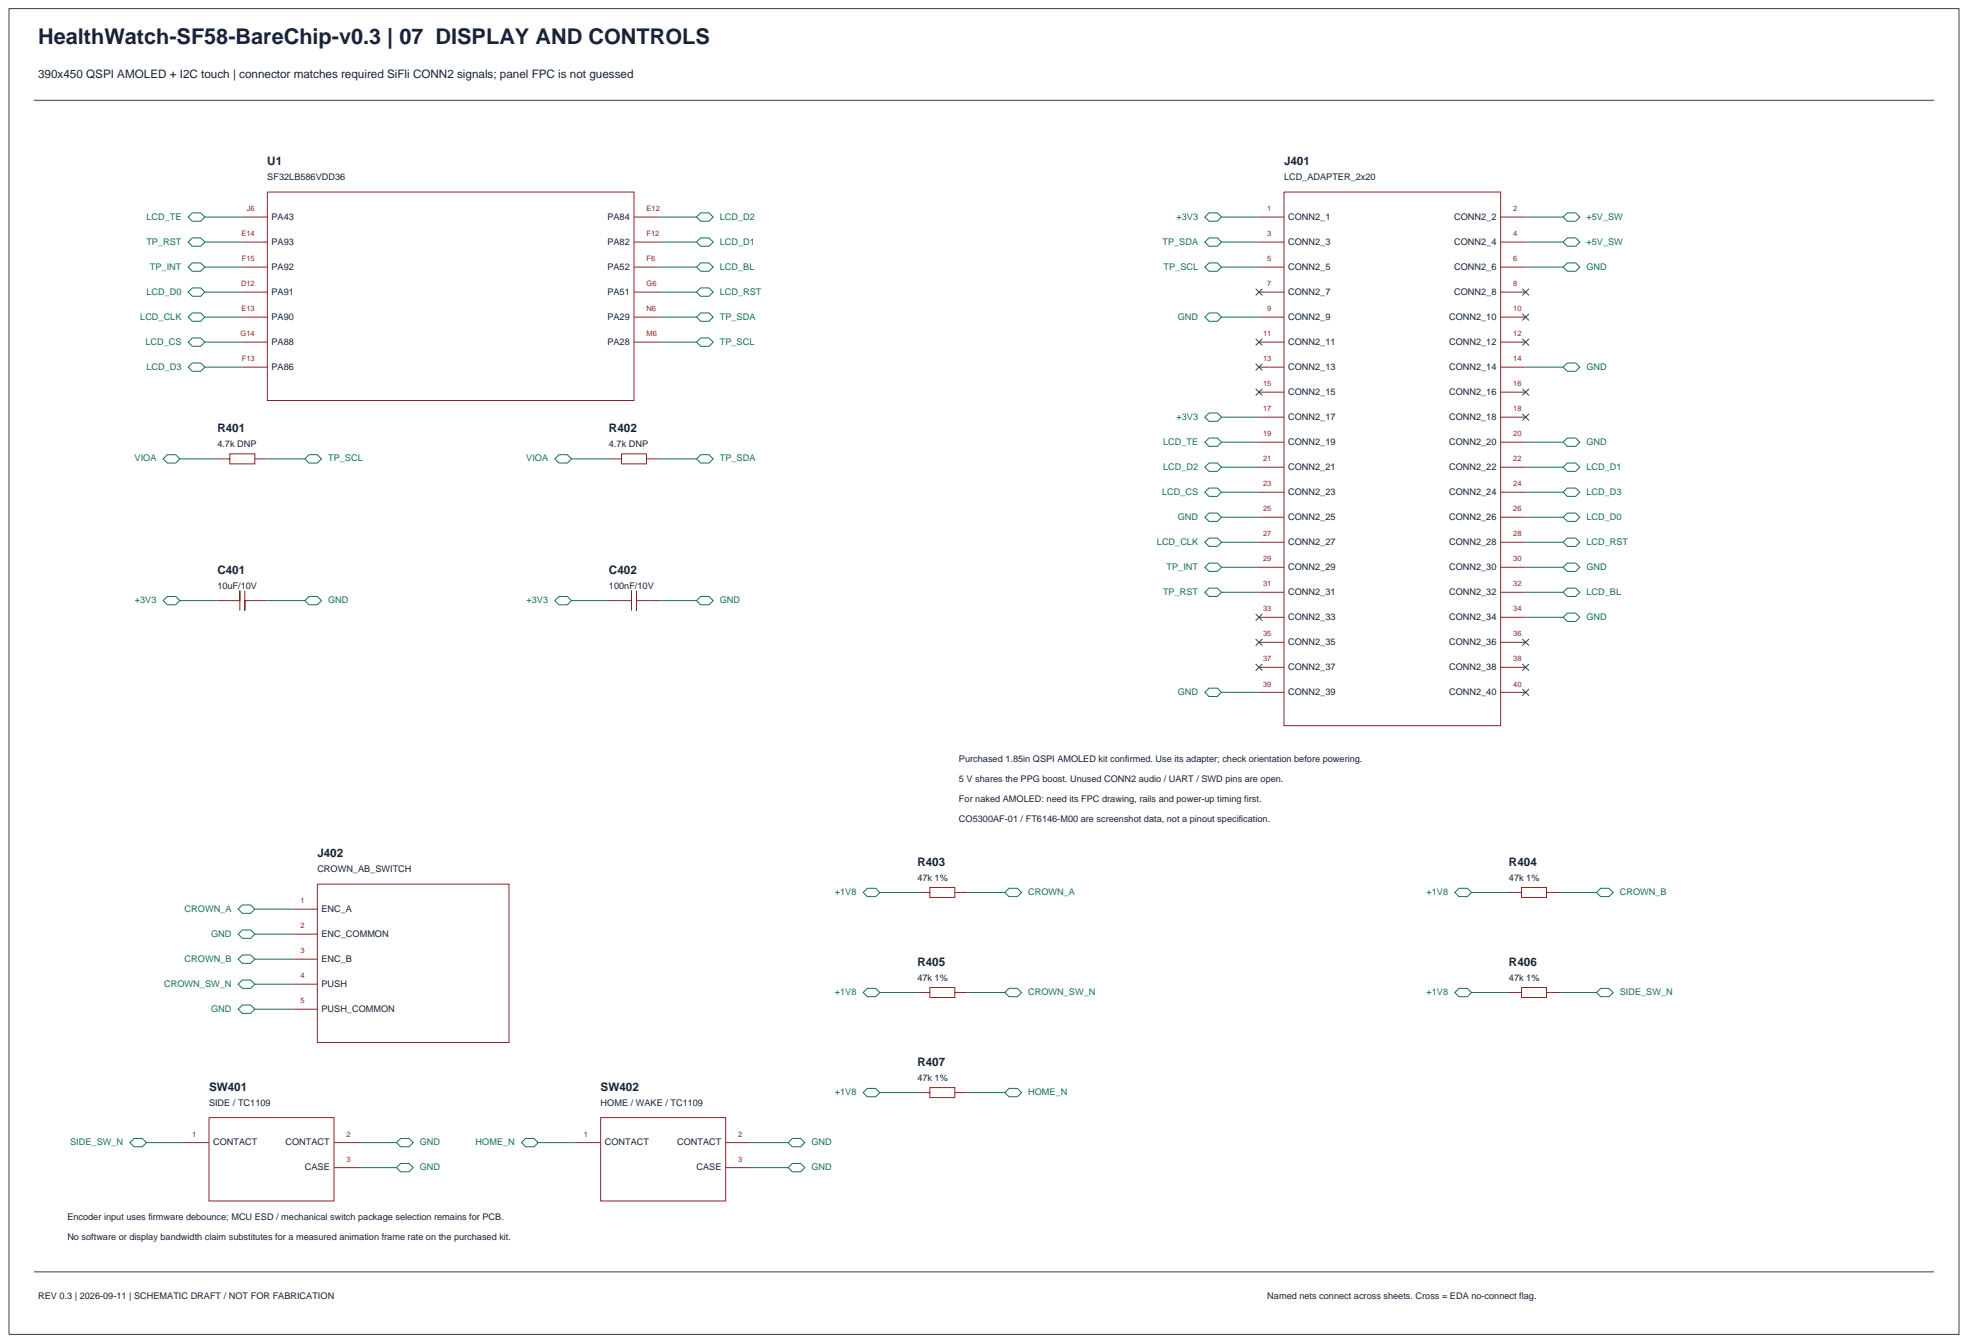
[picture p15: page 7]

Purchased 1.85in QSPI AMOLED kit confirmed. Use its adapter; check orientation before powering.
5 V shares the PPG boost. Unused CONN2 audio / UART / SWD pins are open.
For naked AMOLED: need its FPC drawing, rails and power-up timing first.
CO5300AF-01 / FT6146-M00 are screenshot data, not a pinout specification.

Encoder input uses firmware debounce; MCU ESD / mechanical switch package selection remains for PCB.
No software or display bandwidth claim substitutes for a measured animation frame rate on the purchased kit.

# HealthWatch-SF58-BareChip-v0.3 | 08 IMU AND HAPTICS

LSM6DSO -> SF58 host -> MAXM86146 algorithm | 1.8 V sensor I2C bus | LRA with closed-loop driver

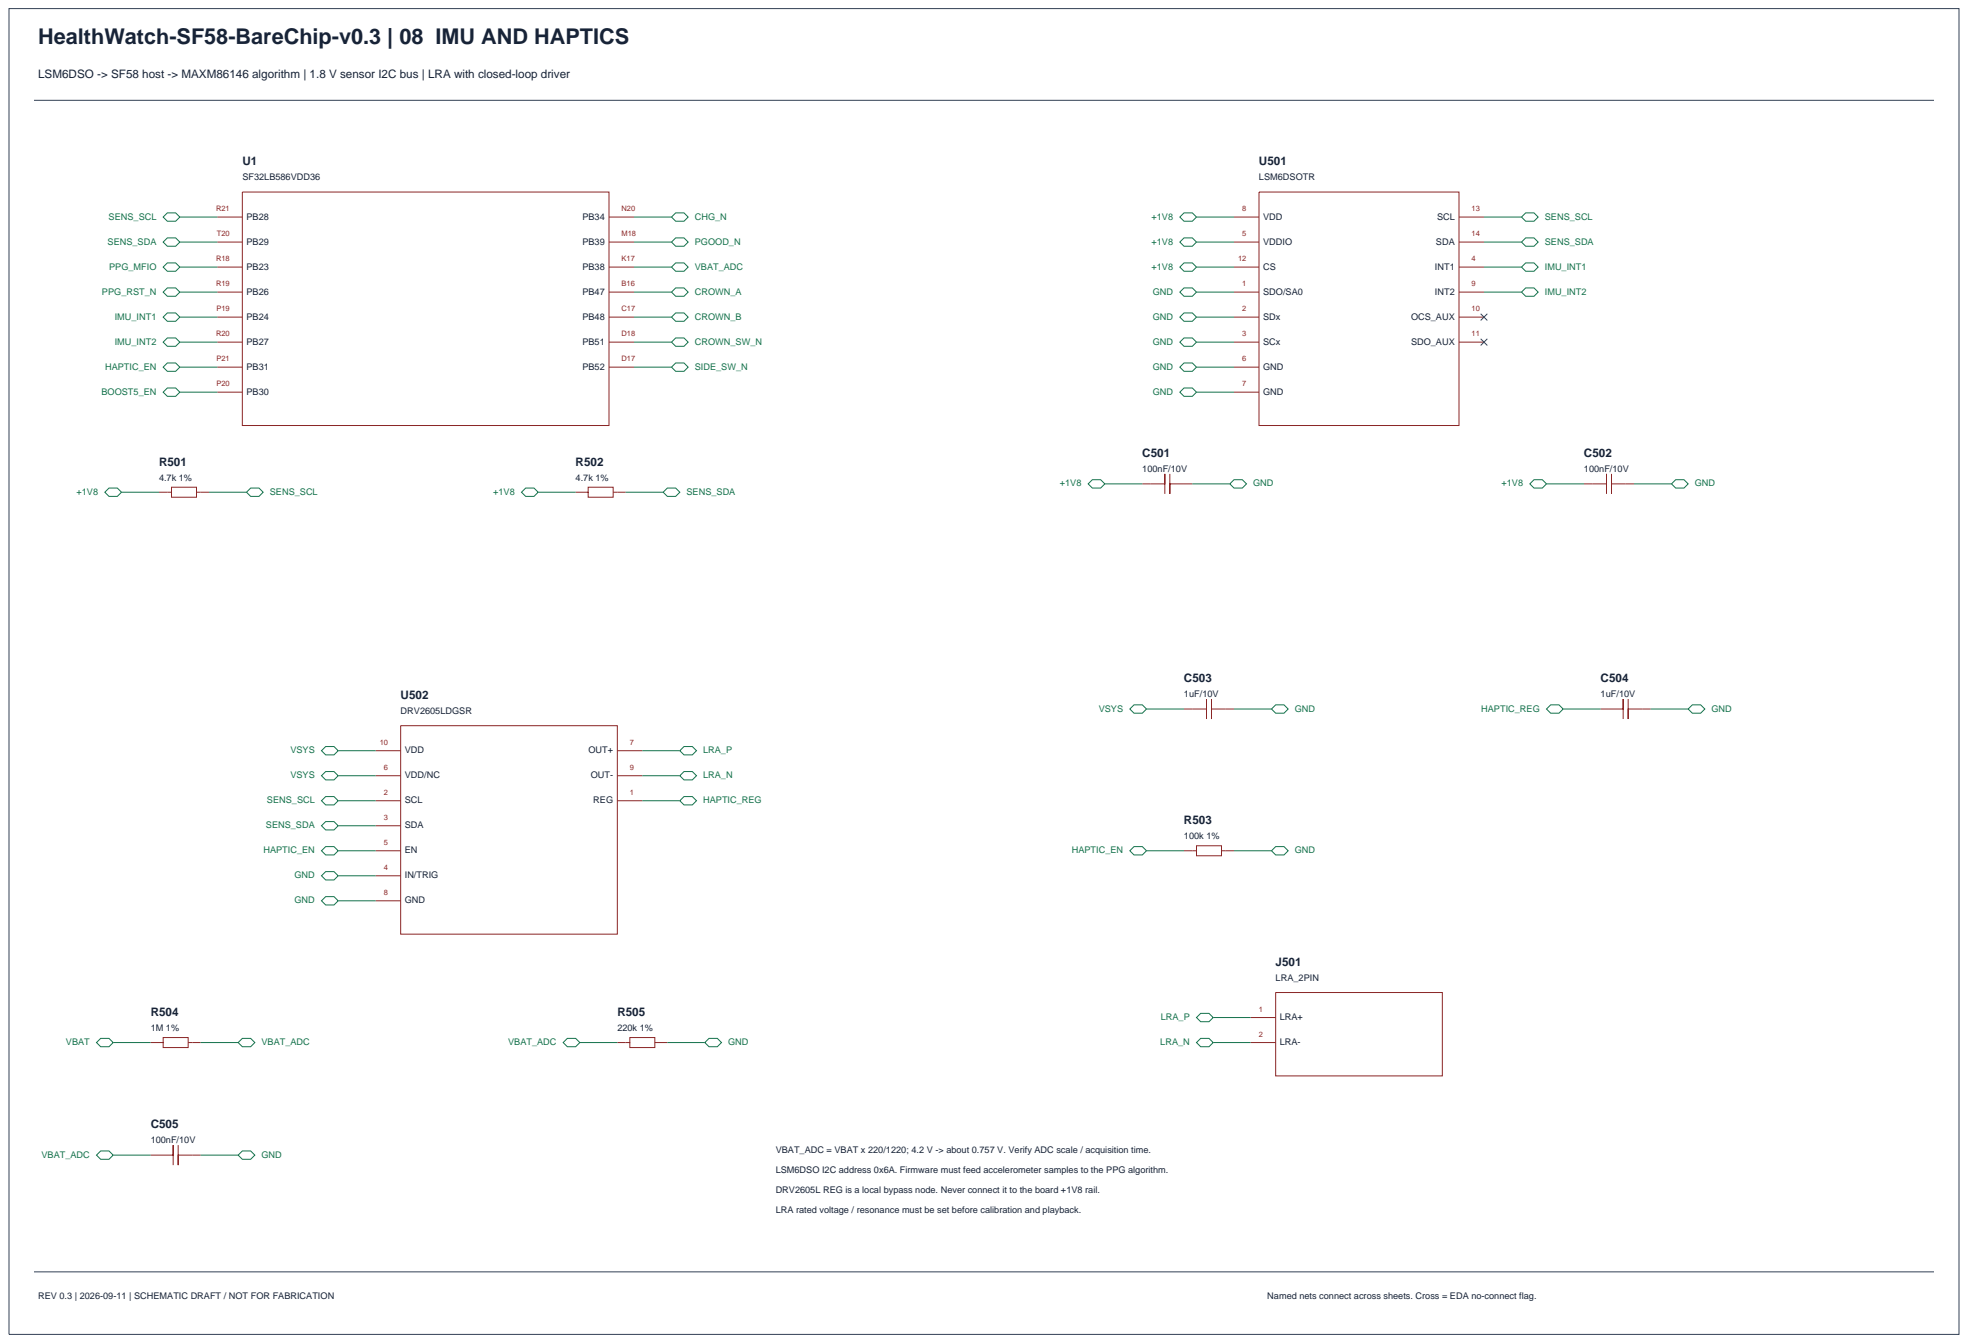
[picture p16: page 8]

LSM6DSO I2C address 0x6A. Firmware must feed accelerometer samples to the PPG algorithm.
DRV2605L REG is a local bypass node. Never connect it to the board +1V8 rail.
LRA rated voltage / resonance must be set before calibration and playback.

# HealthWatch-SF58-BareChip-v0.3 | 09 PPG MODULE

MAXM86146CFU+ heart-rate / SpO2 front end | wrist optics and firmware algorithm still require validation

U601

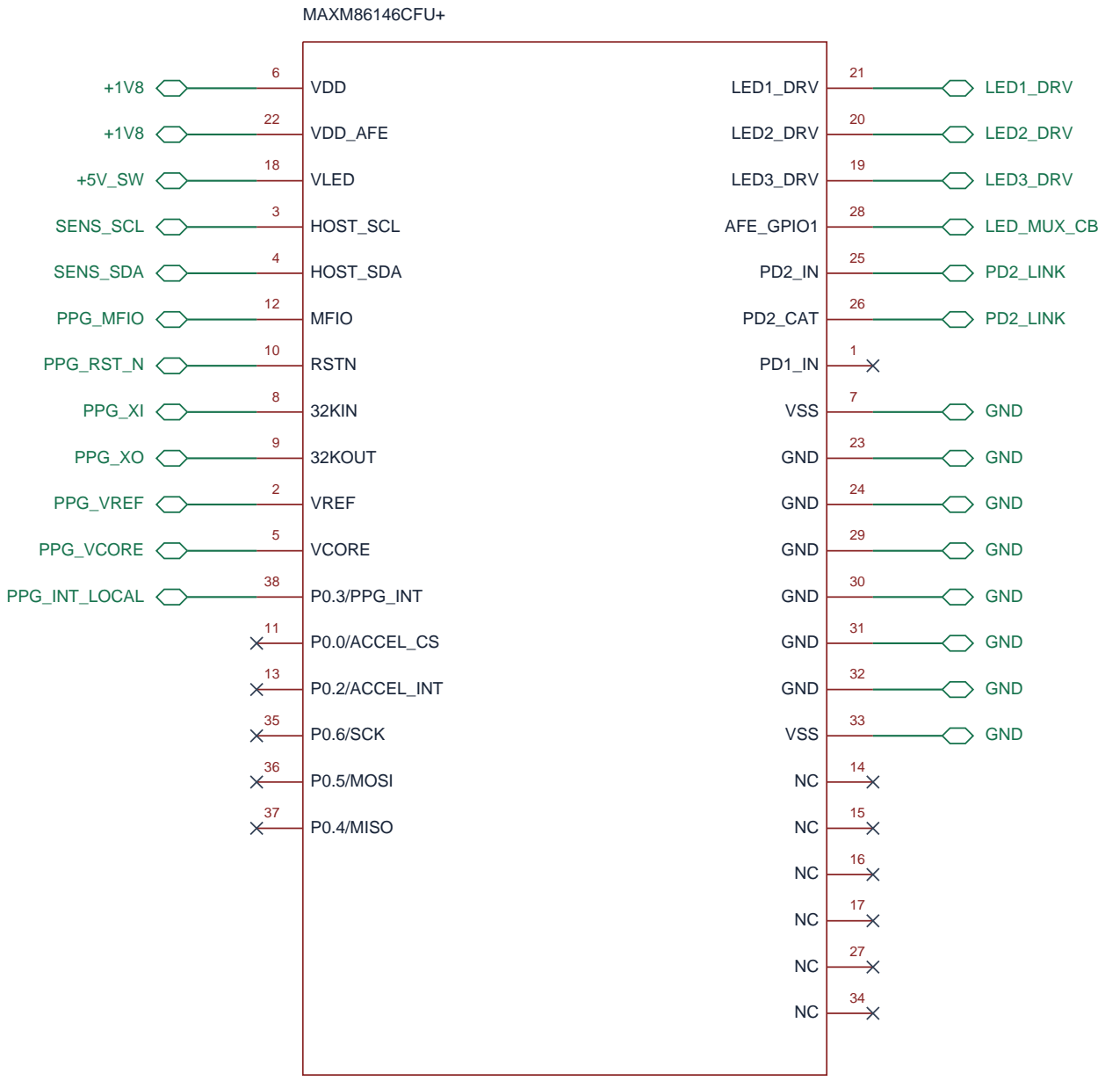
[picture p17: figure]
MAXM86146CFU+; VDD; VDD_AFE; VLED; HOST_SCL; HOST_SDA; MFIO; RSTN; 32KIN; 32KOUT; VREF; VCORE; P0.3/PPG_INT; P0.0/ACCEL_CS; P0.2/ACCEL_INT; P0.6/SCK; P0.5/MOSI; P0.4/MISO; LED1_DRV; LED2_DRV; LED3_DRV; AFE_GPIO1; PD2_CAT; VSS; GND; SENS_SCL; SENS_SDA; PPG_MFIO; PPG_RST_N; PPG_XI; PPG_XO; PPG_VREF; PPG_VCORE; PPG_INT_LOCAL; LED_MUX_CB; PD2_LINK

C601
1uF/10V
+1V8 | GND

C602
10uF/10V
+1V8 | GND

C603
100nF/10V
+1V8 | GND

C604
1uF/10V
PPG_VREF | GND

C605
1uF/10V
PPG_VCORE | GND

C606
10uF/10V
+5V_SW | GND

C607
100nF/10V
+5V_SW | GND

R601
4.7k 1%
+1V8 | PPG_MFIO

R602
4.7k 1%
+1V8 | PPG_INT_LOCAL

R603
10R 1%
PPG_RST_SNUB | GND

C608
100nF/10V
PPG_RST_N | PPG_RST_SNUB

Y601
32.768kHz CL6pF CM1610H32768DZB
PPG_XI | PPG_XO

PD1 is integrated: pin 1 remains open. PD2 pin 25 must be joined to pin 26.

VCORE and VREF are capacitor-only nodes; do not drive with +1V8.

The unused accelerometer SPI pins stay unloaded in host-feed architecture.

PPG_INT_LOCAL is the local AFE interrupt; host communication uses MFIO.

Crystal load network follows the ADI reference; no guessed external load capacitors.

Host I2C / MFIO / reset all 1.8 V. I2C pull-ups are on sheet 08.

Hold PPG reset while required rails / clock stabilize, then follow ADI boot protocol.

C601 at VDD; C602+C603 at VDD_AFE; C606+C607 at VLED.

Common ground electrically; keep LED pulse returns away from optical/analog nodes.

This is a real sensing circuit; accuracy is not established by the schematic.

# HealthWatch-SF58-BareChip-v0.3 | 10 OPTICAL EMITTERS

Two green LEDs + red / IR | MAX14689 switching network | LED polarity / optical footprint review required

U701
MAX14689EWL+T

VCC

C2

GND

B2

CB

A2

COM1

B1

COM2

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
+1V8

GND

LED_MUX_CB

LED2_DRV

LED3_DRV

RED_K

GREEN1_K

IR_K

GREEN2_K

D701
SFH7015

A_RED+IR

3
K_RED_655nm

2

K_IR_940nm

4
NC

1

+5V_SW | RED_K
| IR_K

R701
0R
LED1_DRV | GREEN1_K

D702
CT DBLP31.12-6C5D-56-J6U6

ANODE

1
CATHODE

2

CATHODE_THERMAL

3

+5V_SW | GREEN1_K
| GREEN1_K

D703
CT DBLP31.12-6C5D-56-J6U6

ANODE

1
CATHODE

2

CATHODE_THERMAL

3

+5V_SW | GREEN2_K
| GREEN2_K

R702
100k 1%
LED_MUX_CB | GND

C701
100nF/10V
+1V8 | GND

C702
22uF/10V
+5V_SW | GND

C703
22uF/10V
+5V_SW | GND

Current is regulated by MAXM86146 LED drivers. Set pulse current / timing before acquisition.

CB=0: LED2 -> RED, LED3 -> IR. CB=1: LED2 -> GREEN1, LED3 -> GREEN2.

GREEN1 cathode is also connected to LED1_DRV, following the ADI typical application.

Keep the GREEN1 shared path: three independent LEDs would change the reference design.

MAX14689 VCC=1.8 V; analog terminals support beyond-rail signals within its ratings.

Green LED: physical pad 1 = anode; pads 2 and 3 = cathode. Both cathode pads are wired.

Before PCB: audit emitter land patterns, optical separation, black barriers and skin contact geometry.

Heart rate / SpO2 algorithms, calibration, motion rejection and human testing remain required.

# HealthWatch-SF58-BareChip-v0.3 | 11 SPARE GPIO BALLS

### Complete SF32LB586VDD36 pin inventory | spare pins not routed in this offline revision

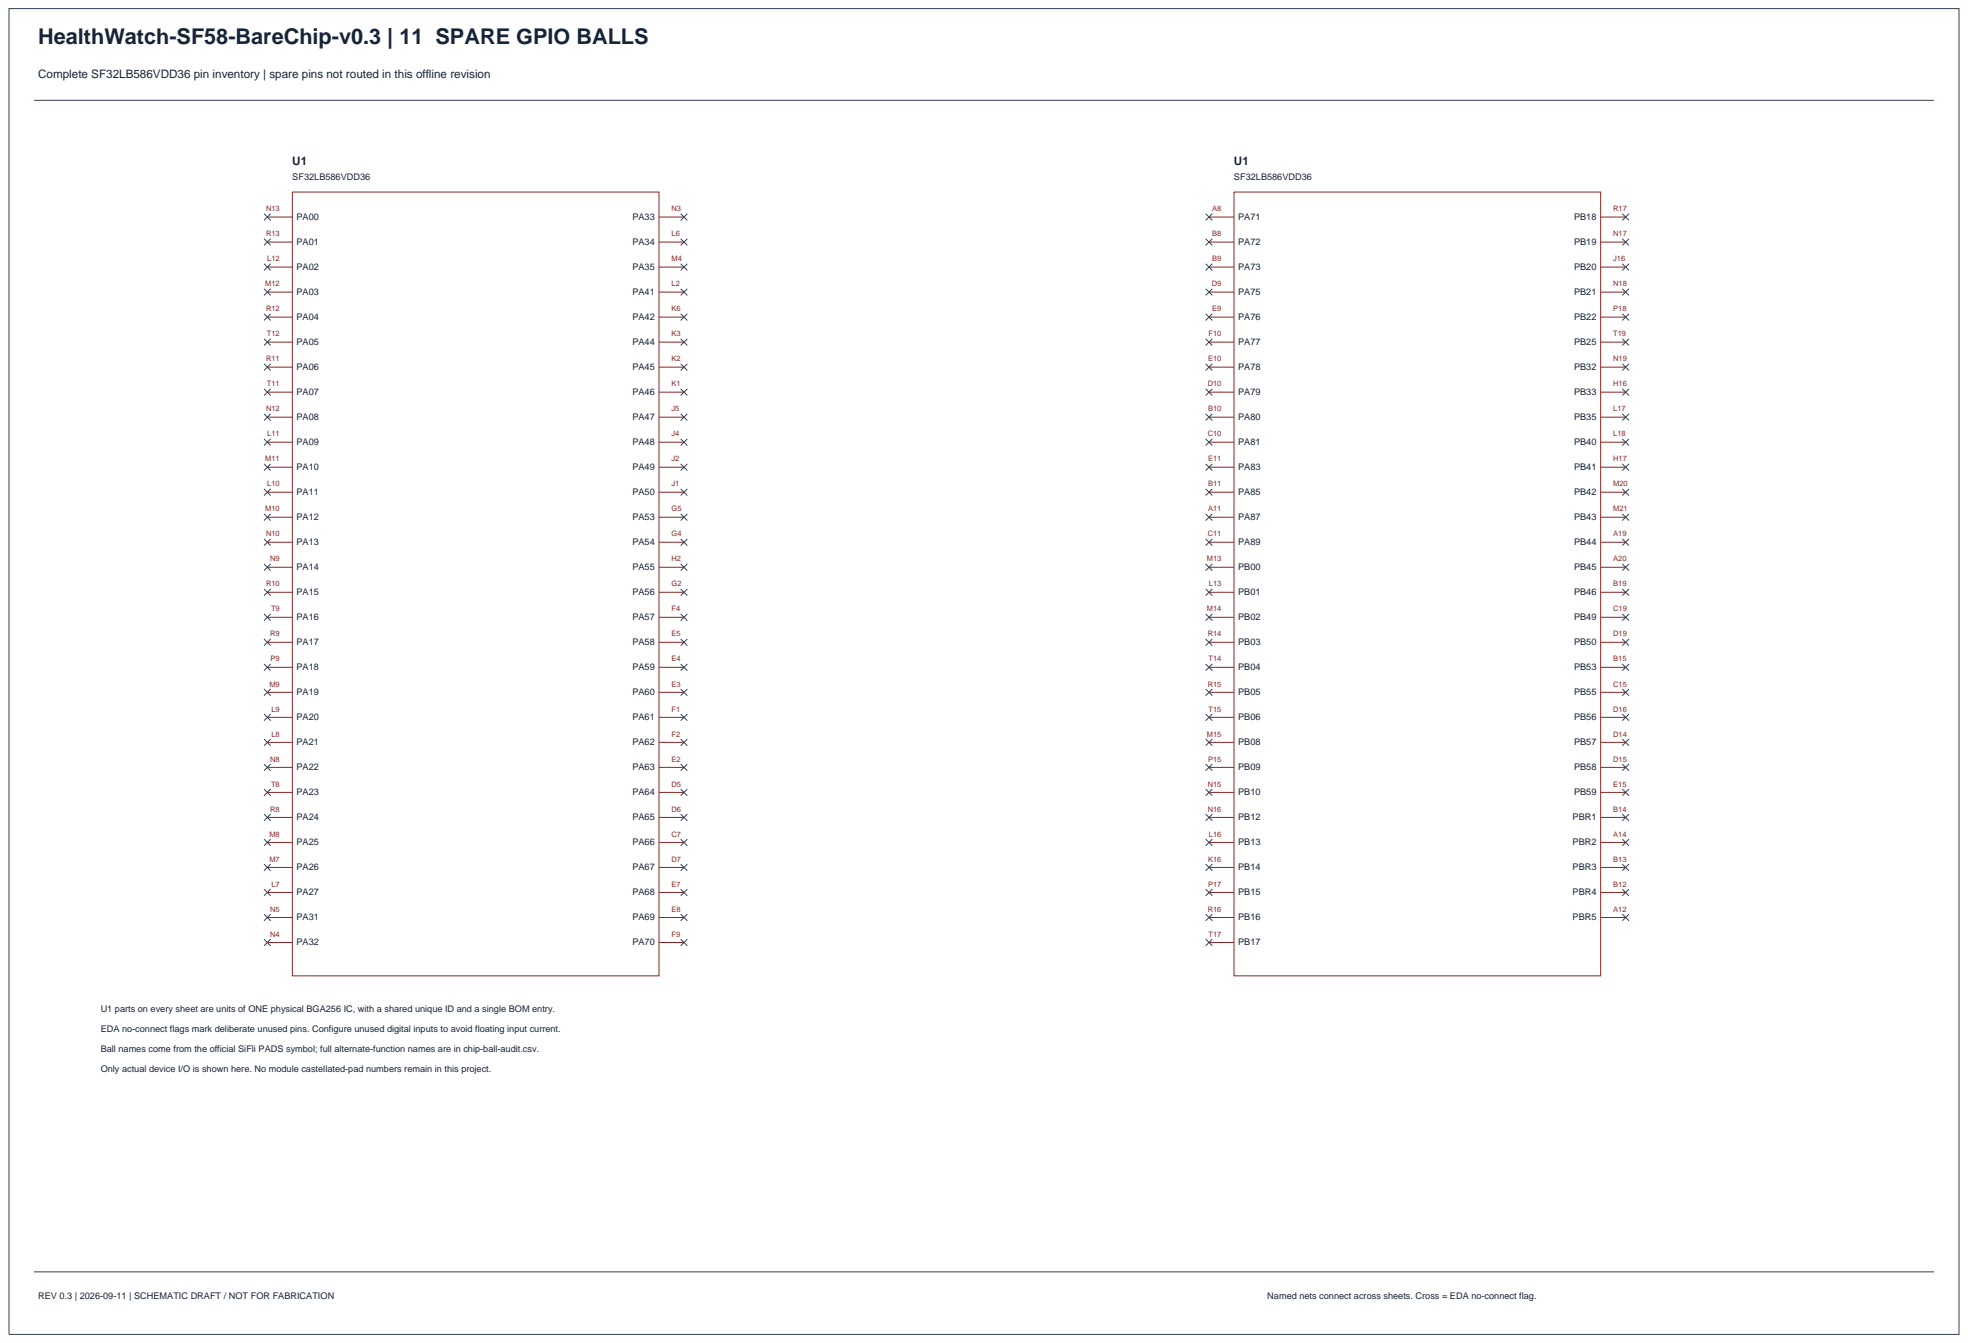
[picture p18: page 11]

U1 parts on every sheet are units of ONE physical BGA256 IC, with a shared unique ID and a single BOM entry.
EDA no-connect flags mark deliberate unused pins. Configure unused digital inputs to avoid floating input current.
Ball names come from the official SiFli PADS symbol; full alternate-function names are in chip-ball-audit.csv.
Only actual device I/O is shown here. No module castellated-pad numbers remain in this project.

# HealthWatch-SF58-BareChip-v0.3 | 12 GROUND AND UNUSED ANALOG

### All BGA ground/reference-return balls | disabled RF, USB, audio and MIPI functions

U1

U1

SF32LB586VDD36; PVSS_PMU1; PVSS_PMU2; VSS; AVSS_RRF; AVSS_TRF; AVSS_VCO; AVSS_TRF2; GPADC_VREFN; SDMADC_VSS_VREF; AVSS_BB; AVSS_CAU; AVSS_DSI; AVSS33_ANA; AVSS33_AUD; AUD_VREF_GND; GND
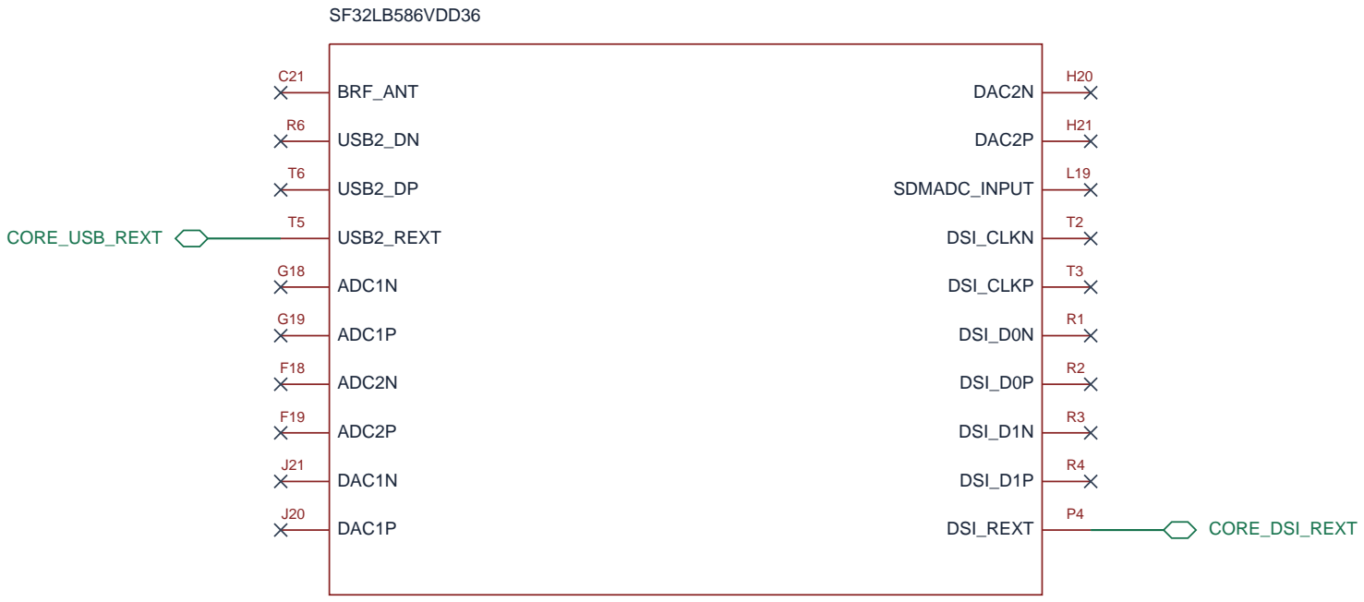
[picture p19: figure]
SF32LB586VDD36; BRF_ANT; USB2_DN; USB2_DP; USB2_REXT; ADC1N; ADC1P; ADC2N; ADC2P; DAC1N; DAC1P; DAC2N; DAC2P; SDMADC_INPUT; DSI_CLKN; DSI_CLKP; DSI_D0N; DSI_D0P; DSI_D1N; DSI_D1P; DSI_REXT; CORE_USB_REXT; CORE_DSI_REXT

R118
10k 1%
CORE_DSI_REXT | GND

R119
200R 1%
CORE_USB_REXT | GND

All VSS/AVSS/PVSS balls are explicitly grounded, including A3/A4 listed as VSS in DS5801.

GPADC_VREFN, AUD_VREF_GND and SDMADC_VSS_VREF also return to ground; keep analog return paths quiet.

DSI_REXT 10k and USB2_REXT 200R follow the official circuit. Their buses are not connected in this offline revision.

BRF_ANT is deliberately open. Firmware must leave Bluetooth/RF disabled until an antenna network is designed.

B4/B5 external-core supply pins are open on BARE CHIP PMU, following the selected internal-PMU topology.

BGA pad geometry is taken from the official chip footprint. PCB placement/routing and fabrication release remain pending.

# HealthWatch-SF58-BareChip-v0.3 | 13 TEST POINTS AND BRINGUP

1.0 mm probe pads | begin with a current-limited bench supply | no probes on crystal nodes

TP001
GND

TEST

1
GND

TP002
VSYS

TEST

1
VSYS

TP003
+1V8

TEST

1
+1V8

TP004
+3V3

TEST

1
+3V3

TP005
+5V_SW

TEST

1
+5V_SW

TP006
VDD_SIP

TEST

1
VDD_SIP

TP007
FLASH_VDD

TEST

1
FLASH_VDD

TP008
RESET_N

TEST

1
RESET_N

TP009
BOOT_MODE

TEST

1
BOOT_MODE

TP010
SENS_SCL

TEST

1
SENS_SCL

TP011
SENS_SDA

TEST

1
SENS_SDA

TP012
PPG_MFIO

TEST

1
PPG_MFIO

TP013
PPG_RST_N

TEST

1
PPG_RST_N

TP014
HAPTIC_EN

TEST

1
HAPTIC_EN

TP015
BOOST5_EN

TEST

1
BOOST5_EN

TP016
VBAT_ADC

TEST

1
VBAT_ADC

Power-up order: isolate external loads -> confirm VSYS / 1.8 V / 3.3 V -> reset and debug -> SiP / external Flash.

Then enable display and touch, IMU, LRA and PPG individually. Start PPG LED currents low and measure 5 V droop.

J101 is a 1.8 V debug interface. J202 / J402 / J501 are defined solder-wire pad banks, not purchased plug connectors.

Full system supply current includes charging and transient loads. The regulator current rating is not a rail budget.

A BOM/model pass or schematic DRC pass does not validate startup, sleep current, optics or PCB manufacturing.

Read the revision notes and bring-up checklist before ordering boards. No routed PCB or Gerber is included.
