zhangguotao05-zgt/iwatch/hardware/SJ056_N极母座封装/焊盘尺寸_mm.csv

焊盘号 | 极性 | 结构 | 铜外径_mm | 铜内径_mm | PCB孔径_mm | 图层 | 说明
1 | 正极 | 中心实心圆盘 | 1.4 | 0 | 0 | Top | 需要在PCB布局阶段安排换层出线
2 | 负极 | 连续同心圆环 | 3.9 | 2.1 | 0 | Top | 由两个重叠半环焊盘组成，均为2号；不可分别重编号
