zhangguotao05-zgt/iwatch/hardware/4mm磁吸母头封装/焊盘尺寸_mm.csv

焊盘号 | 物理位置 | X_mm | Y_mm | 铜宽X_mm | 铜长Y_mm | 孔宽X_mm | 孔长Y_mm | 孔类型 | 注意
1 | 中心针 | 0 | 0 | 1.4 | 1.4 | 0.8 | 0.8 | 镀铜圆孔 | 未指定正负极
2 | 左侧脚 | -1.7 | 0 | 1.5 | 2.5 | 0.9 | 1.9 | 镀铜长圆槽孔 | 孔距与尺寸须实物试装；两侧未预设共网
3 | 右侧脚 | 1.7 | 0 | 1.5 | 2.5 | 0.9 | 1.9 | 镀铜长圆槽孔 | 孔距与尺寸须实物试装；两侧未预设共网
