zhangguotao05-zgt/iwatch/hardware/4mm磁吸母头封装/4mm磁吸母头_封装预览.png

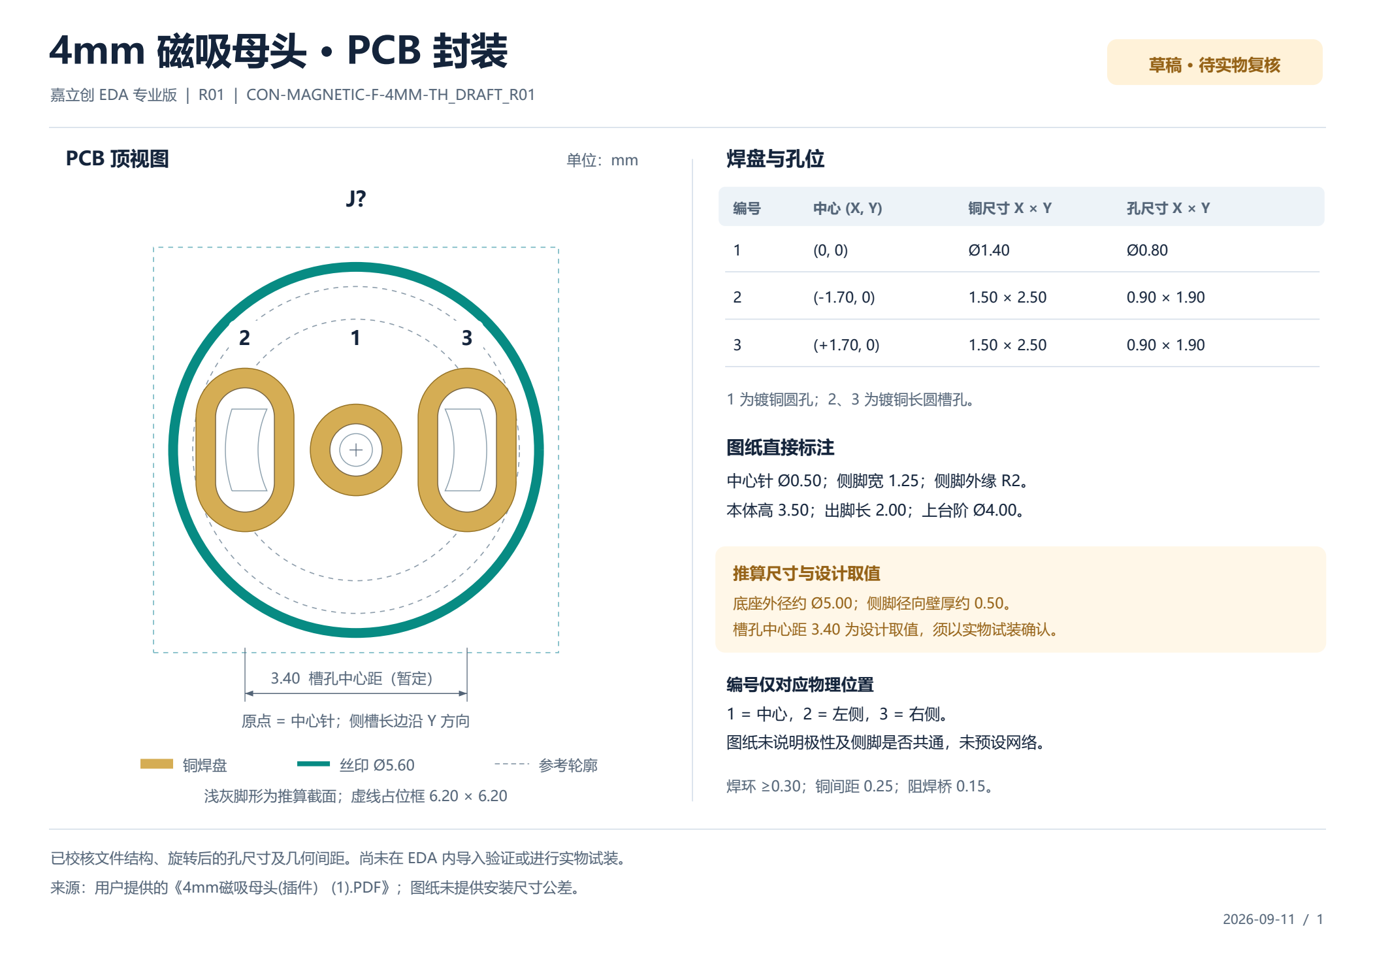
hardware/4mm磁吸母头封装/4mm磁吸母头_封装预览.png
