zhangguotao05-zgt/iwatch/hardware/SJ056_N极母座封装/SJ056_N极母座_封装预览.png

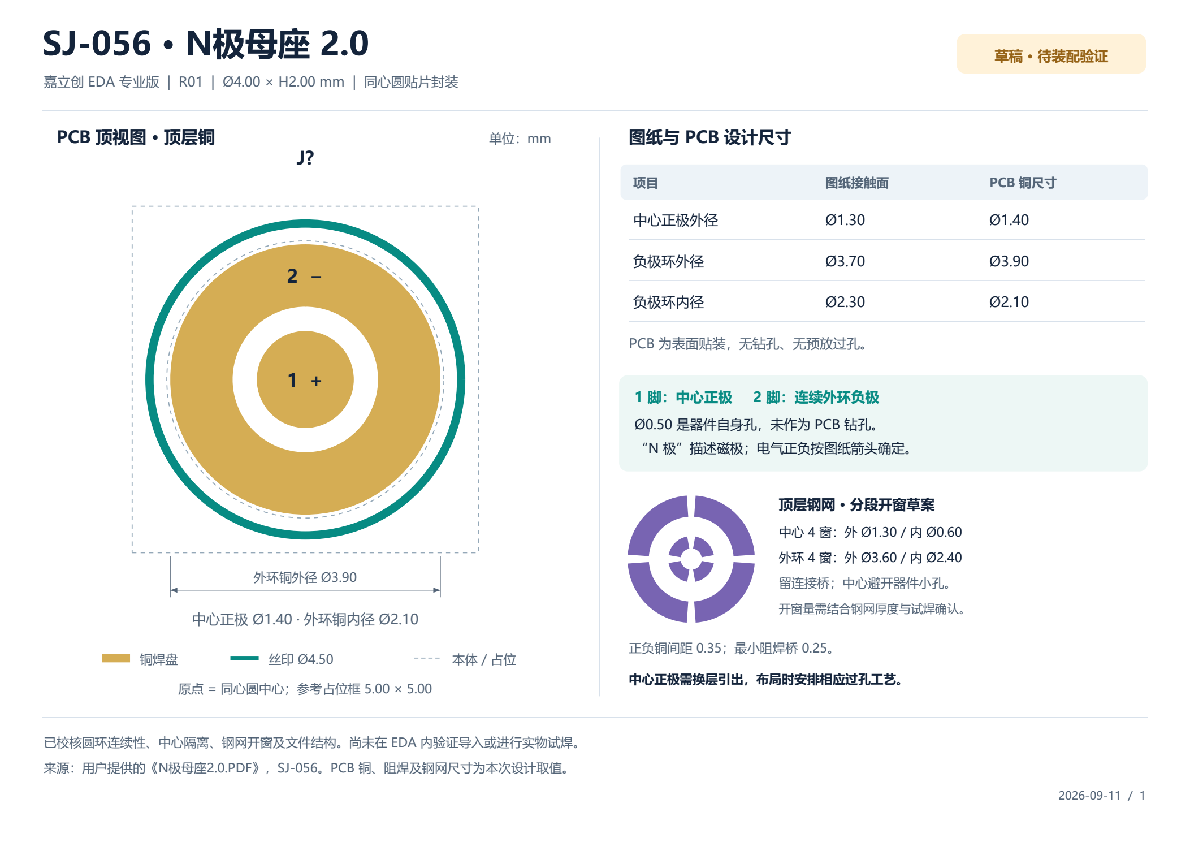
hardware/SJ056_N极母座封装/SJ056_N极母座_封装预览.png
