zhangguotao05-zgt/iwatch/hardware/华强北S11_46mm_自研替板_BOM初选_v0.1.xlsx

Sheet: BOM初选
华强北 S11 46 mm 替板 BOM 初选
v0.1｜2026-09-11｜实物内部尚未核实；首版重点为界面、触摸、表冠、BLE、抬腕与振动。
价格空白表示待询价；这是选型清单，尚未展开成可投产的逐位号 BOM。
编号 | 模块 | 候选型号 / 规格 | 单机用量 | 接口 / 电源 | 封装 / 外形 | 用途与选型依据 | 采用前必须确认 | 采购安排 | 含税单价 元 | 小计 元 | 官方来源 / 依据
B01 | 主控 / PSRAM | SF32LB52JUD6 | 1 | 3.3 V；LCD / I²C / SPI / BLE | QFN68L；7 × 7 × 0.85 mm；0.35 mm 间距 | SiFli；240 MHz 应用核、2D/2.5D 图形加速，合封 16 MB PSRAM。固件建议采用 SiFli SDK + LVGL。 | 先确认现有屏幕接口、分辨率、时序及 7 mm 芯片区域可放入；不直接支持所有屏。 | 核对屏幕后再采购 |  |  | https://downloads.sifli.com/user%20manual/DS5202-SF32LB52X-%E8%8A%AF%E7%89%87%E6%8A%80%E6%9C%AF%E8%A7%84%E6%A0%BC%E4%B9%A6%20V0p2p5.pdf
B02 | 程序 / 图形存储 | W25Q128JVPIQ | 1 | 2.7–3.6 V；SPI / Dual / Quad | WSON-8；6 × 5 mm | Winbond；128 Mbit = 16 MB，用于程序、字体、图标与升级分区。 | 核对 MPI 电平、启动方式、SDK Flash 支持及 6 × 5 mm 占位；若面积不足再选小封装等效料。 | 主控与布局确定后采购 |  |  | https://www.winbond.com/export/sites/winbond/product-selection-guide/file/2025-Product-Selection-Guide-Winbond-Code-Storage-Flash-Memory.pdf
B03 | 主晶体 | E1SB48E001G00E | 1 | 48 MHz；CL 8.8 pF | 2016 公制；2.0 × 1.6 mm | Hosonic；取自 SiFli 硬件指南推荐清单。 | 负载电容及布局采用所选芯片版本的推荐设计；具体尾码与供货核对。 | 可随主控少量备料 |  |  | https://wiki.sifli.com/hardware/SF32LB52B-E-G-J-HW-Application.html
B04 | RTC 晶体 | ETST00327000LE | 1 | 32.768 kHz；CL 7 pF | 3215 公制；3.2 × 1.5 mm | Hosonic；低速计时与休眠时钟候选，来自 SiFli 推荐清单。 | 核对高度、ESR、负载与实际板上校准；缺料时按原规格替代。 | 可随主控少量备料 |  |  | https://wiki.sifli.com/hardware/SF32LB52B-E-G-J-HW-Application.html
B05 | 充电 / Power Path | BQ25180YBGR | 1 | 1 节锂电；I²C；首轮使用受控 5 V 输入 | DSBGA-8；1.783 × 0.983 mm | TI；充电终止电压可配置，带电源路径、温度管理和关机模式。 | 必须匹配实物电池终止电压、充电电流、NTC 与保护板；不得按芯片 1 A 上限直接给小电池充电。 | 电池参数确定后采购 |  |  | https://www.ti.com/product/BQ25180
B06 | 主 3.3 V 电源 | TPS63031DSKR | 1 | 输入 1.8–5.5 V；固定输出 3.3 V | WSON-10；DSK 封装图为准 | TI；升降压，用于 B05 SYS 到主控和 3.3 V 外设供电。 | 按最低电池电压下的实际负载选电感和电容；1 A 是开关电流等级，不是保证的输出电流。 | 电源预算确定后采购 |  |  | https://www.ti.com/product/TPS63031/part-details/TPS63031DSKR
B07 | 可选 1.8 V 电源 | TPS62840DLCR |  | 降压；拟输出 1.8 V | VSON-HR-8；1.5 × 2.0 mm | TI；仅在实物屏幕 / 触摸需要独立 1.8 V 电源时装配。 | 先核对器件电压域；评估主控已有电源输出是否满足负载，避免重复增加电源。 | 选配，暂不采购 |  |  | https://www.ti.com/product/TPS62840/part-details/TPS62840DLCR
B08 | 抬腕 / 运动检测 | LIS2DW12TR | 1 | I²C 或 SPI；建议接 INT 唤醒 | LGA-12；2.0 × 2.0 × 0.7 mm | ST；低功耗三轴加速度计，支持抬腕检测、运动唤醒和计步算法输入。 | 固定器件坐标方向、确认 I²C 地址和中断脚；抬腕和计步仍需软件算法调试。 | 可先买评估模块验证 |  |  | https://www.st.com/resource/en/datasheet/lis2dw12.pdf
B09 | 振动驱动 | DRV2605LYZFR | 1 | 2–5.2 V；I²C；LRA / ERM | DSBGA-9；YZF 封装图为准 | TI；闭环振动驱动候选，支持启动和制动控制。 | 先辨认现有马达类型、阻抗、额定电压和谐振参数；使用现有 ERM 时无法保证 LRA 式清脆触感。 | 马达参数确定后采购 |  |  | https://www.ti.com/product/DRV2605L/part-details/DRV2605LYZFR
B10 | 电量计 | MAX17055ETB+T |  | 单节电池；I²C；配电流采样电阻 | TDFN；以 ETB 封装图为准 | ADI；首版可预留，后续改善电量百分比显示；不作为 UI 点亮的必要物料。 | 需核对电池电压范围、容量、终止电流和模型参数；省略时仅做 ADC 电压估计。 | 选配，暂不采购 |  |  | https://www.analog.com/en/products/max17055.html
B11 | 电量计采样电阻 | 10 mΩ；1%；额定功率按峰值电流确定 |  | 与 B10 配套；Kelvin 取样 | 封装待电流 / 高度预算 | 低阻采样电阻，仅装配 B10 时需要。 | 阻值与量程按 MAX17055 配置匹配；考虑走线电阻和充放电峰值。 | 随电量计定型 |  |  | https://www.analog.com/en/products/max17055.html
B12 | 接口 ESD | TPD4E05U06DQAR |  | 4 通道；低电容保护 | USON-10；DQA 封装图为准 | TI；用于选定的外露信号接口，最终颗数按信号数量确定。 | 核对工作电压、钳位与被保护 IC 耐压；不将信号 ESD 管当成电池过压保护。 | 接口数量确定后采购 |  |  | https://www.ti.com/product/TPD4E05U06/part-details/TPD4E05U06DQAR
B13 | 屏幕与触摸总成 | 优先复用现有整套总成 | 1 | 显示总线、触摸总线及电源均待识别 | 保留当前安装边框和排线位置 | 先保留现有屏幕、盖板和触摸的装配关系，以减少结构修改。 | 必须拿到驱动 IC、实际分辨率、FPC 定义、电压和初始化序列；不能由“S11 46 mm”推断。 | 优先复用，暂不买新屏
B14 | 屏幕电源 / 背光 | 由 B13 确认后选型 |  | OLED 偏压或 TFT 背光方案待定 | 待屏幕需求与布局 | 依据现有屏幕实际类型选择供电；不预设它是 AMOLED 或原装 Apple 屏。 | 区分总成内已有电源与原主板上的电源；补齐上电时序、复位及调光要求。 | 识别屏幕后定型
B15 | 触摸电平适配 | 仅必要时增加电平转换 |  | 可能是 I²C + INT + RESET，待实测 | 按接口电平和空间选择 | 优先直接使用总成内触摸控制器，避免另做触摸板。 | 核对逻辑电压、上拉电源及断电反灌；不能向未知接口直接施加 3.3 V。 | 识别接口后定型
B16 | 电池 | 优先复用现有带保护电池 | 1 | 额定容量、标称电压和终止电压待核实 | 尺寸、厚度和插头按实物 | 保留既有电池仓及安装位置；电池健康状态合格后使用。 | 记录标签与引线定义，核查保护电路及 NTC；不根据商品名推断容量和充电电压。 | 参数 / 状态合格后复用
B17 | 电池温度检测 | 匹配现有 NTC 或新增贴近电池的 NTC |  | 与 B05 TS 网络匹配 | 阻值 / B 值 / 封装待核实 | 为充电温度检测提供实物温度反馈。 | 已有温度线优先核对复用；新增 NTC 需匹配 BQ25180 设置与充电电路参考设计。 | 随电池和充电设计定型 |  |  | https://www.ti.com/product/BQ25180
B18 | 表冠与侧键 | 优先复用机构及可独立复用的电气件 | 1 | 旋转传感器 / 按键接口待识别 | 轴心、按压行程、固定位置按实物 | 机械表冠和侧键位置固定，主板应适配它们的位置。 | 若编码器焊在旧主板，需转接或同尺寸替代；不能假定一定输出 A/B 两相。 | 拆机确认后复用 / 替代
B19 | 振动器 | 优先复用现有马达 | 1 | ERM / LRA 待识别 | 保留现有固定槽及接触方式 | 先保留可装入现有马达仓的器件，配 B09 调试。 | 若仅有 ERM，接受首版触感限制；需要换 LRA 时重新核对空间和固定刚度。 | 测量后决定复用 |  |  | https://www.ti.com/product/DRV2605L/part-details/DRV2605LYZFR
B20 | 充电接入组件 | 优先复用现有触点或独立接收组件 | 1 | 输入方式与输出电压待测 | 保持现有底盖和充电位置 | 先辨认磁吸触点还是无线接收。台架阶段可从外部受控 5 V 给 B05 供电。 | 若无线接收控制在旧主板内，只保留线圈不能完成充电；需另选完整接收电路。 | 确认独立供电能力后复用
B21 | BLE 天线 | 现有可分离天线或新 FPC 天线 | 1 | 2.4 GHz；匹配网络待实测 | 与外壳金属和电池共同评估 | 在保留整机空间的前提下匹配射频通路。 | 旧 PCB 天线会随旧主板一起移除；完整封壳后重新测匹配和实际连接距离。 | 拆机 / 射频布局后定型 |  |  | https://wiki.sifli.com/hardware/SF32LB52B-E-G-J-HW-Application.html
B22 | 显示 / 按键连接器 | 与实物排线匹配的连接器 |  | 针数、间距、触点朝向待测 | 高度、锁扣与插入方向待测 | 保留原排线折弯和装配路径；能够减少外壳修改。 | 不能按“常见 0.5 mm FPC 座”直接买；确认每个针脚后再绘制原理图符号。 | 暂不采购
B23 | 转接 FPC / 小板 | 按原排线位置定制 |  | 短距离信号与供电转接 | 厚度 / 弯曲半径 / 局部高度待测 | 用于旧器件位置与新主板布局不一致的地方。 | 总线速度、电源压降、装配高度决定能否转接；不预先承诺只需一块平板。 | 需要时打样
B24 | 主板 PCB | 按现有主板包络定制 | 1 | 层数由布线、阻抗和装配确定 | 轮廓 / 板厚 / 禁布区均待实测 | 先做 1:1 轮廓和厚度样件试装，再制作电路板。 | 初步评估 4–6 层；这不是已定制板参数，不能默认采用通用 1.6 mm 厚度。 | 试装通过后打样
B25 | 电源电感 / 功率电容 | 跟随 B05 / B06 / B07 的参考电路 |  | 容量、感量、纹波和饱和电流待计算 | 按高度预算选择 | 覆盖电源环路和各电源输入 / 输出旁路。 | 需按真实负载展开到独立位号、MPN 和数量；当前条目不是可投产的阻容清单。 | 原理图完成后展开 |  |  | https://www.ti.com/product/TPS63031/part-details/TPS63031DSKR
B26 | 去耦 / 上拉 / 串联电阻 | 按 MCU / Flash / 接口参考设计展开 |  | 工作电压和总线速度决定数值 | 优先可装配的小封装 | 按各电源域和引脚要求放置；包含晶体预留电容位置。 | 不要将一组“通用阻容包”视为最终 BOM；需核对启动脚、I²C 上拉及屏幕信号完整性。 | 原理图完成后展开 |  |  | https://wiki.sifli.com/hardware/SF32LB52B-E-G-J-HW-Application.html
B27 | Flash / 屏幕电源开关 | 按低功耗与启动要求预留 |  | 负载电流、漏电和使能电平待定 | 按电源树和空间选择 | 控制可关闭外设，降低关机漏电；避免外设反灌。 | Flash 断电控制需符合 SiFli Boot ROM 要求；料号和装配数量随电源树冻结。 | 电源树完成后定型 |  |  | https://wiki.sifli.com/hardware/SF32LB52B-E-G-J-HW-Application.html
B28 | 射频匹配无源器件 | 按参考设计预留可调 π 网络 |  | 2.4 GHz；50 Ω 通路设计 | 以射频参考布局为准 | 匹配天线、馈线和外壳环境。 | 元件值必须在完整外壳和电池状态下测定；不能由开发板元件值直接保证性能。 | 射频验证后定值 |  |  | https://wiki.sifli.com/hardware/SF32LB52B-E-G-J-HW-Application.html
B29 | 下载 / 调试触点 | 板上测试点，配外部治具 | 1 | GND / 参考电压 / SWD 或 UART / RESET | 测试点位置、间距随板确定 | 首版保留可恢复下载路径和关键电源测试点。 | 避免仅依赖蓝牙升级；触点可达性需在装配前确认。 | 随 PCB 实现 |  |  | https://wiki.sifli.com/hardware/SF32LB52B-E-G-J-HW-Application.html
B30 | 绝缘 / 固定 / 密封 | 匹配现有机壳的胶、垫片和螺钉 | 1 | 机械与绝缘附件，一套 | 厚度和压缩量按实物 | 保持电池绝缘、板子固定和屏幕装配。 | 复装后的防水性需要另行测试，不能沿用商品宣传；可能需要薄支架或垫片。 | 试装后确定用量
 |  |  |  |  |  | 已填单价项目小计 | 未报价、选配和待定项目未计入；不是整机总价。
库存和价格未确认；候选料号需经过屏幕兼容、供电和装配验证后才能冻结。

Sheet: 原件复用
现有零件复用与装配
优先保留机壳、屏幕触摸总成和按键机构；其余按接口与性能验证结果决定。
46 mm 为商品标称；工作尺寸统一使用实测 mm。不得直接套用 Apple 原装结构数据。
项目 | 建议 | 需要核对的实物信息 | 对方案的影响 | 依据
目标实物 | 华强北“Apple Watch Series 11 GPS 46mm Smartwatch” | 名称按现有商品记录。其内部规格没有经拆机核实。 | 使用实物主板和总成作为定位基准，不套用 Apple 原装主板尺寸或接线。 | 用户提供；2026-09-11
外壳 / 表带 | 优先全部保留 | 需要旧板轮廓、孔位、屏幕窗口和主板可用高度。 | 可省外观设计；内部布置、板厚和避让仍要核对。 | 实物测量待补
显示 + 触摸 + 盖板 | 优先保留整套 | 记录排线正反面丝印、触摸 IC、针脚、工作电压、初始化和像素尺寸。 | 这是主控冻结前置条件。驱动不可得时，才评估相同总成的可驱动替代。 | 实物测量待补
屏幕性能 | 先测现有屏幕上限 | 测刷新率、总线时钟、触摸采样和黑色显示效果。 | 现有屏若是低刷新 TFT，保壳方案可能限制界面观感；GPU 无法改变面板本身的上限。 | 工程判断，待实测
表冠 / 按键 | 保留外部机构，电气件按条件复用 | 确认是旋转编码器、光学 / 磁传感器或仅按键；量轴高与按压行程。 | 只要旋转检测可用，就可映射滚动；旧板焊接器件需考虑转接与机械固定。 | 实物测量待补
电池 | 参数与状态合格后复用 | 标签、尺寸、实际电压、保护板、NTC 和引脚定义。 | 据此设定充电终止电压和电流；换充电 IC 不代表电池参数已知。 | https://www.ti.com/product/BQ25180
振动器 | 先识别再决定 | 型号、引线、DC 电阻、工作电压；若为 LRA，需谐振参数。 | 尽量复用其固定槽；高质量触感取决于驱动、马达和机械耦合。 | https://www.ti.com/product/DRV2605L/part-details/DRV2605LYZFR
充电底座 / 接收件 | 能独立提供合适直流输出时复用 | 辨认有触点的磁吸充电与无线感应；检查接收电路位于何处。 | 接收控制若在旧板上，换板必须补上；线圈不等于完整充电模块。 | 实物测量待补
天线 | 可分离时优先复用 | 辨认 FPC / 弹片 / PCB 天线，记录馈点与接地位置。 | 外壳、主板地和电池变化会影响匹配，需要重新测量。 | https://wiki.sifli.com/hardware/SF32LB52B-E-G-J-HW-Application.html
心率 / 血氧 | 首版 UI 阶段暂不新增 | 保留后盖窗口；原器件需确认真实芯片、光学结构和可用驱动。 | 后续做真实测量时独立选型验证，不能直接沿用原表显示的数字作为准确性证据。 | 工程范围；未做传感器验证
麦克风 / 扬声器 | 首版可保留位置并不装新音频电路 | 尺寸、阻抗、偏置、声孔结构及接口。 | 界面验证先完成触摸 / 表冠 / 显示；通话会增加固件、电源和声学工作量。 | 工程范围；后续选配
“GPS” 标称 | 暂不据此选 GNSS 芯片 | 该商品名不能证明实物有独立 GNSS 芯片或天线。 | 首版可经手机同步位置；若要求独立定位，再做天线和 GNSS 专项选型。 | 用户提供的商品名；能力未核实
第一轮装配样件 | 先做无电路的 1:1 轮廓 / 厚度模型 | 测原板厚度、最高器件、连接器高度、线缆折弯和电池净空。 | 合盖不压屏、不压电池、不顶按键后，再确定正式 PCB 厚度和布局。 | 工程建议
备选主控条件 | 屏幕接口不匹配时改选 | 若为 MIPI-DSI 或超出选定 SF32LB52 型号显示能力，重新评估 SF32LB58x。 | 这是一条替代分支；当前不同时采购两种主控。 | https://www.sifli.com/en/xinpian

Sheet: 先行验证
先行验证清单
先用开发板建立 UI 性能基线，再转接现有屏幕，最后制作能装入机壳的自研板。
这页是研发验证物料，不是单机装配 BOM；目前没有下单或购买任何物料。
编号 | 用途 | 型号 / 项目 | 数量 | 安排 | 选择理由 | 核对事项 | 来源
P01 | 独立 UI 验证 | SF32LB52-DevKit-LCD，N16R8 配置 | 1 | 先买 1 套 | 官方 SDK 已有对应 BSP；16 MB Flash / 8 MB PSRAM 配置适合开始 UI 工作。 | 采购时核对套装确含匹配显示屏及转接件；开发板仅在台架使用，不装进表壳。 | https://docs.sifli.com/projects/sdk/latest/sf32lb52x/supported_boards/boards/sf32lb52-lcd_n16r8/doc/index.html
P02 | 开发板配套屏 | LCD_1P85_390*450_DevKit_Adapter_V1.0.0 |  | 随 P01 核对，不重复买 | 官方 P01 文档默认的 1.85 英寸 390 × 450 QSPI 显示组合。 | 这是已知驱动的开发屏，不保证能装入现有手表；P01 已含则不另买。 | https://docs.sifli.com/projects/sdk/latest/sf32lb52x/supported_boards/boards/sf32lb52-lcd_n16r8/doc/index.html
P03 | 现有手表 | 用户已有华强北 S11 46 mm 手表 | 1 | 已有，先保留完整记录 | 作为外壳、屏幕、排线、电池、按键和马达的实物来源。 | 拆开前记录现有工作状态；拆后以照片、标尺和实测建立连接表。 | 用户已购实物
P04 | 接口识别 / 转接 | 与实物排线匹配的转接板 |  | 暂不采购 | 识别屏幕后用于从开发板驱动现有屏幕。 | 针数、间距、接触面和电源未确认前，不购买通用 FPC 座。 | 实物信息待补
P05 | 焊接板上核心 IC | B01–B12 的适用项 |  | 屏幕和电源确认后少量采购 | 将已验证的芯片与实际屏幕、马达、电池组合到自研板。 | 不应把本页开发板与装机 BOM 加总成一块手表成本。 | 对应 BOM 官方来源
P06 | 机械适配样件 | 1:1 主板轮廓 / 厚度模型 | 1 | 量出尺寸后制作 | 先验证螺钉、连接器、电池净空与合盖干涉。 | 可采用纸板 / 薄板或打印样件；材料厚度须匹配测量目标。 | 工程建议
P07 | 测量与调试工具 | 优先复用现有仪器 |  | 先检查已有工具 | 万用表、显微观察、受控电源、卡尺；低速总线可用逻辑分析仪。 | 高速度差分总线不能默认由普通逻辑分析仪解析；按实际总线选择测量方法。 | 工程建议

Sheet: 资源预算
图形与电源资源预算
黄色格为示例输入或待测输入；蓝灰色格为公式结果。所有示例参数均可修改。
显示总线仅用于算术预算；真实帧率还受面板刷新、绘制、缓存与传输并发影响。
参数 / 结果 | 值 | 单位 | 说明
显示宽度 | 400 | px | 计算示例，必须替换为实物像素宽度。
显示高度 | 480 | px | 计算示例，不能由商品名 46 mm 推出。
每像素字节数 | 2 | B/px | 示例 RGB565；ARGB8888 使用 4。
帧缓冲数量 | 2 | 个 | 用于双缓冲容量预算，具体渲染模式由驱动决定。
目标刷新率 | 60 | fps | 设计目标，尚未在实物验证。
显示总线时钟 | 80 | MHz | 示例参数；按面板时序与布线能力确认。
每拍数据位数 | 4 | bit/clock | 示例为四数据线、单沿传输；不是现有屏幕的已知接口。
总线有效利用系数 | 70.0% | 比例 | 工程计算假设，包含命令与传输间隙；不是实测值。
单帧数据量 | 384000 | B | 宽 × 高 × 每像素字节数。
帧缓冲总容量 | 750.00 | KiB | 1 KiB = 1024 B。
全屏刷新的数据量 | 23.04 | MB/s | 十进制 MB/s；不包含额外渲染读写。
总线理论吞吐 | 40.00 | MB/s | 时钟 × 数据线位数 / 8。
估算有效吞吐 | 28.00 | MB/s | 只用于前期预算，不能据此保证 60 fps。
刷新占估算吞吐 | 82.3% | 比例 | 低于 100% 也仍需检查 GPU、内存争用与面板扫描时序。
单帧时间预算 | 16.67 | ms | 1 秒 / 目标帧率。
实际触摸采样率 |  | Hz | 待实测；不能用渲染帧率代替触摸输入速率。
实测触摸到显示延迟 |  | ms | 用同步触发或高速视频评估，记录典型值与较差情况。
设计用 PSRAM | 16 | MiB | B01 合封容量。P01 为 8 MB，试验时需改成 8 并相应缩减下方缓存预算。
双缓冲占用 | 0.73 | MiB | 由本页帧缓冲公式计算。
图像资源缓存预算 | 4.00 | MiB | 工程初始预算，可调整。
字体缓存预算 | 1.00 | MiB | 工程初始预算，可调整。
临时合成 / 解码预算 | 2.00 | MiB | 工程初始预算，可调整。
其他 PSRAM 预算 | 1.00 | MiB | 不代表所有 DMA 或任务栈都可放在 PSRAM。
已分配 PSRAM 预算 | 8.73 | MiB | 各项预算合计。
PSRAM 剩余预算 | 7.27 | MiB | 不足时应调整图形资源或架构。
PSRAM 剩余比例 | 45.4% | 比例 | 预留余量供缓存峰值和后续功能。
片内 SRAM | 576 | KiB | 芯片资料值；RTOS、协议栈、DMA 与双核分配须看 BSP 链接布局。
电池示例容量 | 300 | mAh | 纯计算示例，不是对现有电池容量的判断。
电池可用容量系数 | 80.0% | 比例 | 工程估算；受温度、老化与关机阈值影响。
目标运行时间 | 24.00 | h | 用于倒推平均电流上限。
电池侧平均电流上限 | 10.00 | mA | 要求在电池侧测量，以纳入各电源转换损耗。
实测电池侧平均电流 |  | mA | 留空直到完成指定亮屏、蓝牙与振动占空比测试。
按实测电流估算续航 |  | h | 估算值，仍需完整放电验证。
软件与测试依据
LVGL 缓冲模式 |  |  | https://lvgl.io/docs/open/9.0/porting/display.html
SiFli 电路和时钟 |  |  | https://wiki.sifli.com/hardware/SF32LB52B-E-G-J-HW-Application.html
单机软件架构 |  |  | SiFli SDK 对应 BSP + RTOS + LVGL。界面线程不阻塞采样；表冠 / 触摸事件排队处理，短中断，保留看门狗与恢复下载。
实机验证项目 |  |  | 测全屏滑动、图标缩放、卡片转场的帧时间；同时测 BLE 重连、任务栈余量、关屏电流、充电温升及完整外壳下的射频表现。
