zhangguotao05-zgt/iwatch/hardware/自研智能手表_整机选型评估与BOM_v0.2.xlsx

Sheet: BOM初选
自研智能手表整机 BOM 初选
v0.2，2026-09-11。屏幕、电子器件和外壳全部重新选型；先完成界面核心整机。
价格空白表示未询价；组合件、无源器件与机构尚需展开，不能直接用于贴片采购。
编号 | 模块 | 候选型号 / 规格 | 单机用量 | 接口 / 电源 | 封装 / 外形 | 用途与选型依据 | 采用前必须确认 | 采购安排 | 含税单价 元 | 小计 元 | 官方来源 / 依据
B01 | 主控 / PSRAM | SF32LB52JUD6 | 1 | 3.3 V；QSPI / I²C / SPI / 双模蓝牙 | QFN68L；7 × 7 × 0.85 mm；0.35 mm 间距 | SiFli；240 MHz 应用核、2D/2.5D 图形加速，合封 16 MB PSRAM。固件建议采用 SiFli SDK + LVGL。 | 先与 B13 测真实 UI。复杂全屏动画未达标时，整组升级 SF32LB58x + MIPI-DSI 屏；两种主控不是原位替换。 | 先买开发套装验证 |  |  | https://downloads.sifli.com/user%20manual/DS5202-SF32LB52X-%E8%8A%AF%E7%89%87%E6%8A%80%E6%9C%AF%E8%A7%84%E6%A0%BC%E4%B9%A6%20V0p2p5.pdf
B02 | 程序 / 图形存储 | W25Q128JVPIQ | 1 | 2.7–3.6 V；SPI / Dual / Quad | WSON-8；6 × 5 mm | Winbond；128 Mbit = 16 MB，用于程序、字体、图标与升级分区。 | 核对 MPI 电平、启动方式、SDK Flash 支持及 6 × 5 mm 占位；若面积不足再选小封装等效料。 | 主控与布局确定后采购 |  |  | https://www.winbond.com/export/sites/winbond/product-selection-guide/file/2025-Product-Selection-Guide-Winbond-Code-Storage-Flash-Memory.pdf
B03 | 主晶体 | E1SB48E001G00E | 1 | 48 MHz；CL 8.8 pF | 2016 公制；2.0 × 1.6 mm | Hosonic；取自 SiFli 硬件指南推荐清单。 | 负载电容及布局采用所选芯片版本的推荐设计；具体尾码与供货核对。 | 可随主控少量备料 |  |  | https://wiki.sifli.com/hardware/SF32LB52B-E-G-J-HW-Application.html
B04 | RTC 晶体 | ETST00327000LE | 1 | 32.768 kHz；CL 7 pF | 3215 公制；3.2 × 1.5 mm | Hosonic；低速计时与休眠时钟候选，来自 SiFli 推荐清单。 | 核对高度、ESR、负载与实际板上校准；缺料时按原规格替代。 | 可随主控少量备料 |  |  | https://wiki.sifli.com/hardware/SF32LB52B-E-G-J-HW-Application.html
B05 | 充电 / Power Path | BQ25180YBGR | 1 | 1 节锂电；I²C；首轮使用受控 5 V 输入 | DSBGA-8；1.783 × 0.983 mm | TI；充电终止电压可配置，带电源路径、温度管理和关机模式。 | 按 B16 成品电池包正式规格配置终止电压、电流、NTC 和保护。芯片的 1 A 上限不是小电池的允许充电电流。 | 电池参数确定后采购 |  |  | https://www.ti.com/product/BQ25180
B06 | 主 3.3 V 电源 | TPS63031DSKR | 1 | 输入 1.8–5.5 V；固定输出 3.3 V | WSON-10；DSK 封装图为准 | TI；升降压，用于 B05 SYS 到主控和 3.3 V 外设供电。 | 按最低电池电压下的实际负载选电感和电容；1 A 是开关电流等级，不是保证的输出电流。 | 电源预算确定后采购 |  |  | https://www.ti.com/product/TPS63031/part-details/TPS63031DSKR
B07 | 可选 1.8 V 电源 | TPS62840DLCR |  | 降压；拟输出 1.8 V，选配 | VSON-HR-8；1.5 × 2.0 mm | 仅当新屏总成或扩展外设确需独立 1.8 V 电源时装配；先核对总成供电，避免重复稳压。 | 与主控电压域和供电能力一起确认；PPG 扩展也可使用其配套 PMIC 的 1.8 V 输出。 | 选配，暂不采购 |  |  | https://www.ti.com/product/TPS62840/part-details/TPS62840DLCR
B08 | 抬腕 / 运动检测 | LIS2DW12TR | 1 | I²C 或 SPI；建议接 INT 唤醒 | LGA-12；2.0 × 2.0 × 0.7 mm | ST；低功耗三轴加速度计，支持抬腕检测、运动唤醒和计步算法输入。 | 固定器件坐标方向、确认 I²C 地址和中断脚；抬腕和计步仍需软件算法调试。 | 可先买评估模块验证 |  |  | https://www.st.com/resource/en/datasheet/lis2dw12.pdf
B09 | 振动驱动 | DRV2605LYZFR | 1 | 2–5.2 V；I²C；LRA / ERM | DSBGA-9；YZF 封装图为准 | TI；闭环振动驱动候选，支持启动和制动控制。 | 与 B19 LRA 配套，按额定 RMS、过驱动和制动参数配置，在实际壳体中校准。 | 与 LRA 一起备样 |  |  | https://www.ti.com/product/DRV2605L/part-details/DRV2605LYZFR
B10 | 电量计 | MAX17055ETB+T | 1 | 单节电池；I²C；配电流采样电阻 | TDFN；以 ETB 封装图为准 | 可佩戴版建议装配，用完整充放电校验电量显示。 | 需核对电池电压范围、容量、终止电流和模型参数；省略时仅做 ADC 电压估计。 | 随电池包备样 |  |  | https://www.analog.com/en/products/max17055.html
B11 | 电量计采样电阻 | 10 mΩ；1%；额定功率按峰值电流确定 | 1 | 与 B10 配套；Kelvin 取样 | 封装待电流 / 高度预算 | 低阻采样电阻，仅装配 B10 时需要。 | 阻值与量程按 MAX17055 配置匹配；考虑走线电阻和充放电峰值。 | 随电量计定型 |  |  | https://www.analog.com/en/products/max17055.html
B12 | 接口 ESD | TPD4E05U06DQAR |  | 4 通道；低电容保护 | USON-10；DQA 封装图为准 | TI；用于选定的外露信号接口，最终颗数按信号数量确定。 | 核对工作电压、钳位与被保护 IC 耐压；不将信号 ESD 管当成电池过压保护。 | 接口数量确定后采购 |  |  | https://www.ti.com/product/TPD4E05U06/part-details/TPD4E05U06DQAR
B13 | 显示 / 触摸总成 | ZC-A1D85W-010 | 1 | 1.85 英寸 AMOLED；390 × 450；QSPI + I²C | 圆角矩形；盖板、FPC 与厚度按正式图纸 | SiFli 官方配套屏；CO5300AF-01 显示、FT6146-M00 触摸、BV6802W 电源。 | 先核对交付版本、初始化、最大时钟、扫描频率、TE 和电源。获取完整外形图再设计壳体，不套用其他 1.85 英寸屏尺寸。 | 先买配套屏样品 |  |  | https://wiki.sifli.com/en/board/sf32lb52x/SF-DevKit-LCM-Adapter.html
B14 | 屏幕电源 / 触摸配套 | BV6802W / FT6146-M00 等随 B13 核对 |  | 按总成的 VCI / IOVCC / TP 供电要求 | 优先由屏幕总成包含 | 核对总成内已集成器件、外部去耦和上电控制。AMOLED 没有 TFT 背光，但仍需偏压。 | 不重复购买已包含的芯片；根据实物交付电路补齐电源和接口适配。 | 总成包含项不单独下单 |  |  | https://wiki.sifli.com/en/board/sf32lb52x/SF-DevKit-LCM-Adapter.html
B15 | 表冠角度传感器 | TMAG5273A1QDBVR | 1 | 1.7–3.6 V；I²C + INT | SOT-23-6；含引脚约 2.9 × 2.8 mm | 3D Hall 与角度计算，配径向磁化磁铁实现连续旋转检测。 | 磁铁、间距、旋转平面和按压位移需标定。检查 LRA、充电磁铁干扰；低功耗电流随采样方式变化。 | 先做表冠样件 |  |  | https://www.ti.com/lit/ds/symlink/tmag5273.pdf
B16 | 保护电池包 | 以 EEMB LP372435TB 为电芯的成品包 | 1 | 3.7 V 标称；300 mAh；要求 PCM + NTC | 裸电芯约 24.5 × 36 × 4.0 mm；成品包更大 | 由供应商组包，包含保护电路、绝缘、引线和温度检测。 | 官网型号是裸电芯。成品包订单号、充电参数、峰值电流及最终尺寸须确认；不要按裸电芯尺寸封死电池仓。 | 询带保护电池包样品 |  |  | https://www.eemb.com/product-166
B17 | 电池温度检测 | 随 B16 的 NTC 与 B05 TS 网络 |  | 阻值与 B 值按电池包规格 | 贴近电芯；引线绝缘 | 成品包已包含 NTC 时不重复采购，主板补齐匹配网络。 | 按电池允许充电温度设置并测试，不能用 MCU 芯片温度替代电芯温度。 | 随电池包定型 |  |  | https://www.ti.com/product/BQ25180
B18 | 表冠按压 / 侧键 | SKSCLDE010 | 2 | GPIO 按键；侧向触发 | 3.5 × 3.55 × 1.25 mm；行程 0.2 mm | ALPS Alpine 1.6 N 侧按开关，分别用于表冠按压与侧键。 | 设计轴向导向、机械限位和防尘密封，避免开关承担过载；固件需消抖。 | 结合机构样件备样 |  |  | https://tech.alpsalpine.com/e/products/category/tact-switch/sub/02/series/sksc/
B19 | 线性振动器 | Precision Microdrives C10-100 | 1 | LRA；约 175 Hz；配 B09 | 直径 10 mm；厚度约 3.7 mm | 有正式规格的 LRA，评估点击、表冠滚动与通知振动。 | 按批次规格限制 RMS 和过驱动，在实际壳体质量与固定方式下校准；不能仅凭器件保证 Taptic Engine 触感。 | 与驱动一起备样 |  |  | https://www.precisionmicrodrives.com/datasheets/C10-100%20-%20datasheet-006.pdf
B20 | 充电接入 / 底座 | 新设计 5 V 两触点磁吸底座 | 1 | 表体触点 + 底座 Pogo Pin；限流 5 V | 触点行程、磁铁与排水按结构设计 | 首版选接触充电，减少接收线圈、控制芯片和隔磁片占用。 | 不是 Apple 磁充协议。检查短路、反接、腐蚀及磁铁对 B15 的干扰；Pogo Pin 料号随行程确定。 | 结构后制作
B21 | 2.4 GHz 天线 | Johanson 2450AT18A0100001E | 1 | 2.4–2.5 GHz；匹配到 RF 口 | 1206；地与净空按厂商布局 | 用于双模蓝牙，作为独立器件选型基线。 | 芯片本体小不代表净空小；保留非金属射频区域，完整封壳和佩戴后重新匹配与测连接。 | RF 布局后备样 |  |  | https://www.johansontechnology.com/products/antennas/rf-antennas/2450at18a0100001e/
B22 | 显示 / 小板连接器 | 按新屏总成和新小板接口选座 |  | 针数、间距、接触面由图纸决定 | 高度与 FPC 弯折共同核算 | 显示使用总成适配的连接器，小板按新设计选连接方式。 | 开发板 22p 接口不是裸屏排线定义，不能直接照抄作为装机屏座。 | 总成图纸后定 MPN |  |  | https://wiki.sifli.com/en/board/sf32lb52x/SF-DevKit-LCM-Adapter.html
B23 | 内部 FPC / 表冠小板 | 按新壳结构定制 |  | I²C / GPIO / 供电；显示链路另核对 | 厚度、弯曲半径、插拔方向待 CAD | 连接表冠、主板和屏幕，保持组件可装配。 | 先短线与机构样件验证，再做薄 FPC；投产前展开独立图号和用量。 | 机构验证后打样
B24 | 主板 PCB | 自研 4–6 层；板厚初估 0.8 mm | 1 | 最终层叠 / 阻抗由布线和加工确定 | 轮廓随屏、电池和机构布局设计 | 首轮保留物理下载、电源测试点和分路电流测量位置。 | 0.8 mm 是预算而非冻结参数；QFN 0.35 mm 与 DSBGA 需核实贴片厂工艺和过孔方案。 | UI 与结构验证后投板
B25 | 电源电感 / 功率电容 | 跟随 B05 / B06 / B07 的参考电路 |  | 容量、感量、纹波和饱和电流待计算 | 按高度预算选择 | 覆盖电源环路和各电源输入 / 输出旁路。 | 需按真实负载展开到独立位号、MPN 和数量；当前条目不是可投产的阻容清单。 | 原理图完成后展开 |  |  | https://www.ti.com/product/TPS63031/part-details/TPS63031DSKR
B26 | 去耦 / 上拉 / 串联电阻 | 按 MCU / Flash / 接口参考设计展开 |  | 工作电压和总线速度决定数值 | 优先可装配的小封装 | 按各电源域和引脚要求放置；包含晶体预留电容位置。 | 不要将一组“通用阻容包”视为最终 BOM；需核对启动脚、I²C 上拉及屏幕信号完整性。 | 原理图完成后展开 |  |  | https://wiki.sifli.com/hardware/SF32LB52B-E-G-J-HW-Application.html
B27 | Flash / 屏幕电源开关 | 按低功耗与启动要求预留 |  | 负载电流、漏电和使能电平待定 | 按电源树和空间选择 | 控制可关闭外设，降低关机漏电；避免外设反灌。 | Flash 断电控制需符合 SiFli Boot ROM 要求；料号和装配数量随电源树冻结。 | 电源树完成后定型 |  |  | https://wiki.sifli.com/hardware/SF32LB52B-E-G-J-HW-Application.html
B28 | 射频匹配无源器件 | 按参考设计预留可调 π 网络 |  | 2.4 GHz；50 Ω 通路设计 | 以射频参考布局为准 | 匹配天线、馈线和外壳环境。 | 元件值必须在完整外壳和电池状态下测定；不能由开发板元件值直接保证性能。 | 射频验证后定值 |  |  | https://wiki.sifli.com/hardware/SF32LB52B-E-G-J-HW-Application.html
B29 | 下载 / 调试触点 | 板上测试点，配外部治具 | 1 | GND / 参考电压 / SWD 或 UART / RESET | 测试点位置、间距随板确定 | 首版保留可恢复下载路径和关键电源测试点。 | 避免仅依赖蓝牙升级；触点可达性需在装配前确认。 | 随 PCB 实现 |  |  | https://wiki.sifli.com/hardware/SF32LB52B-E-G-J-HW-Application.html
B30 | 结构与装配附件 | 自研壳、后盖、支架、表冠轴与磁铁；新购表带 | 1 | 机械图号、材料和数量待 CAD | 表体初估 46–48 × 40–42 × 13–15 mm | 先打印试装，围绕新屏、电池包设计。表带初选标准 22 mm 快拆接口。 | 尺寸是包络假设，不是已验证 CAD；不含表冠和表带。需预留电池膨胀间隙、密封、螺柱、LRA 和天线净空。 | 试装后定图纸与用量
 |  |  |  |  |  | 已填单价项目小计 | 未报价、选配和待定项目未计入；不是整机总价。
库存和价格未确认；候选料号需经过屏幕兼容、供电和装配验证后才能冻结。

Sheet: 整机评估
整机可行性与扩展选型
围绕显示、交互、续航和装配联合设计电子与结构。
尺寸、效率与续航条件为设计假设，尚未完成实机测试。
项目 | 建议 | 依据与边界 | 对方案的影响 / 验证要求 | 来源
整机范围 | 电子器件与外壳全部重新选型 / 设计 | 本版覆盖界面核心整机；心率、GNSS 和通话为扩展候选。 | 第一阶段实现显示、触摸、表冠、振动、抬腕、蓝牙与电池系统。 | 需求范围；2026-09-11
主控选择 | 先验证 SF32LB52JUD6；必要时升级 SF32LB58x | SF52 有图形加速、PSRAM 与双模蓝牙；SF58 增加 MIPI-DSI 等显示接口。 | 复杂全屏效果要求稳定 60 fps 时，优先评估 SF58 + 确认过的 MIPI 屏组合；不是原位替换。 | https://www.sifli.com/en/sf32lb58x
屏幕总成 | ZC-A1D85W-010，标准盖板优先 | 官方已给出驱动、触摸与电源芯片，开发 BSP 有对应组合。 | 先获取同版本外形图和完整电路。开发转接板不装入表体；定制曲面玻璃会增加贴合和打样工作。 | https://wiki.sifli.com/en/board/sf32lb52x/SF-DevKit-LCM-Adapter.html
界面性能 | 用真实 UI 帧时间作选型门槛 | 390 × 450 RGB565 单帧 351000 B；60 fps 需要 21.06 MB/s。官方默认 QSPI 50 MHz，理论 25 MB/s。 | 需求占理论 84.24%。假设有效系数 70%，传输上限约 49.86 fps；局部更新有帮助，不能保证重转场全屏 60 fps。 | https://github.com/OpenSiFli/SiFli-SDK/blob/main/customer/peripherals/display/co5300/co5300.c
表冠体验 | TMAG5273 + 径向磁铁 + 侧按开关 | 低摩擦轴、导向、按压限位及磁铁间距需要联合设计。 | 无机械档位，滚动刻度由 LRA 反馈。测慢转、快转、换向、边按边转与充电底座磁干扰。 | https://www.ti.com/lit/ds/symlink/tmag5273.pdf
电池与续航 | 300 mAh 保护电池包为初始容量 | LP372435TB 是裸电芯型号，成品包额外占据保护板、引线和绝缘空间。 | 按 80% 可用容量，24 h 要平均电流 ≤10 mA；48 h 要 ≤5 mA。必须按电池侧测量并计入亮屏占空比。 | https://www.eemb.com/product-166
触感 | DRV2605L + C10-100 | 马达直径约 10 mm、厚 3.7 mm，先考虑与电池并排避免叠高。 | 闭环驱动、固定方式和整机重量共同决定触感，需佩戴样机评价。 | https://www.precisionmicrodrives.com/datasheets/C10-100%20-%20datasheet-006.pdf
充电 | 首版用新设计 5 V 磁吸触点 | Pogo Pin 和磁铁配自制底座，BQ25180 管理充电与电源路径。 | 无线充电后续需另加接收电路、线圈、隔磁片与热测试；当前不假设兼容 Apple 充电器。 | https://www.ti.com/product/BQ25180
结构包络 | 初估 46–48 × 40–42 × 13–15 mm | 不含表冠和表带，是布局起点，不是已验证的最终尺寸。 | 屏总成决定窗口，电池包和主板决定层叠。先做实际厚度的 1:1 试装，再精修外观与密封。 | 工程假设；后续 CAD 与试装确认
天线与材料 | 首版非金属壳或明确的 RF 窗口 | 芯片天线需要厂商规定的净空和地；金属壳会影响辐射与匹配。 | 完整屏、电池、后盖及佩戴状态下测匹配和连接；射频窗口需在结构初期预留。 | https://www.johansontechnology.com/products/antennas/rf-antennas/2450at18a0100001e/
心率 / 血氧扩展 | MAX30101 + MAX14750A，先做原始 PPG | 集成光学模块，参考电路提供独立 1.8 V 与 LED 电源。 | 另做贴肤小板、遮光、光学窗、运动伪影和算法验证；不是接上 I²C 就能得到可靠腕部读数。 | https://www.analog.com/en/products/max30101.html
独立 GNSS 扩展 | u-blox MIA-M10Q-00B | 约 4.5 × 4.5 × 1.0 mm；UART / I²C，仍需独立 GNSS 天线与供电设计。 | 按运动记录时段开启，单独测耗电和佩戴接收效果；芯片功耗不能代表整机定位模式。 | https://www.u-blox.com/en/product/mia-m10-series
音频 / 通话扩展 | 片上 CODEC + TPA2011D1；MIC / 喇叭后定 | SF52 是双模蓝牙平台，官方有 HFP HF 示例，具备继续做蓝牙通话的基础。 | 需要音频路由、回声抑制、声孔、声腔与手机兼容验证。当前是扩展评估，不是完整音频采购 BOM。 | https://docs.sifli.com/projects/sdk/latest/en/sf32lb52x/example/bt/hfp/README.html https://www.ti.com/product/TPA2011D1
固件与边界 | SiFli SDK 对应 RTOS + LVGL + 自研 UI | 实现表盘、应用网格、通知、卡片、滚动动效；需接硬件加速并管理资源缓存。 | 可重现主要界面和交互风格；运行自研固件，不能安装 watchOS。手机通知与数据同步仍需手机侧适配。 | https://www.sifli.com/en/xinpian

Sheet: 先行验证
先行验证清单
先验证真实显示、表冠、振动、电源和结构，再冻结主板。
研发物料不与单机 BOM 相加；目前没有下单或联系供应商。
编号 | 用途 | 型号 / 项目 | 数量 | 安排 | 选择理由 | 核对事项 | 来源
P01 | UI 性能验证 | SF32LB52-DevKit-LCD N16R8 配套屏套装 | 1 | 先验证 | 官方 BSP 支持对应显示组合，建立渲染、传输和触摸性能基线。 | 开发板只有 8 MB PSRAM，目标主板为 16 MB；记录缓存差别，开发板耗电不能直接当作整机耗电。 | https://docs.sifli.com/projects/sdk/latest/sf32lb52x/supported_boards/boards/sf32lb52-lcd_n16r8/doc/index.html
P02 | 装机屏样品 | ZC-A1D85W-010 总成 + 正式图纸 | 1 | 核对套装后购样 | 拿到盖板、FPC、连接器、电源和驱动资料，作为壳体设计输入。 | P01 已含同版本总成则不重复买；不把开发转接板尺寸当作屏总成尺寸。 | https://wiki.sifli.com/en/board/sf32lb52x/SF-DevKit-LCM-Adapter.html
P03 | 表冠验证 | TMAG5273 评估小板 + 轴机构与磁铁 | 1 | 与 UI 并行 | 用真实输入调滚动速度、方向、按压及休眠唤醒。 | 这一项是一套研发工装；磁铁尺寸和间距需要机械容差试验，不能直接视为成品表冠。 | https://www.ti.com/lit/ds/symlink/tmag5273.pdf
P04 | 触感验证 | DRV2605L 评估板 + C10-100 | 1 | 与表冠一起验证 | 测点击、刻度、通知和制动。 | 按马达规格限幅，在接近实际整机质量和固定方式的样件上测试。 | https://www.precisionmicrodrives.com/datasheets/C10-100%20-%20datasheet-006.pdf
P05 | 电源验证 | 300 mAh 保护电池包 + 充电 / 稳压测试板 | 1 | 电池规格确认后 | 测白屏、无线收发、振动同时工作的峰值与充电温升。 | 匹配 NTC 和充电参数，以电池侧电流积分评估亮屏、关屏与通知等模式。 | https://www.ti.com/product/BQ25180
P06 | 结构试装 | 打印壳、支架、表冠轴套与 PCB 厚度模型 | 1 | 图纸和样品齐后 | 验证屏、电池包、FPC、LRA、按钮与连接器的装配关系。 | 先做 1:1 干涉检查和实装，再冻结外壳；尚未开模或采购定制玻璃。 | 工程建议
P07 | 自研 PCBA | B01–B30 适用项；SF58 + MIPI 为升级分支 |  | 验证后投板 | 界面帧时间、表冠、触感和结构通过后，展开原理图与逐位号 BOM。 | 若复杂动画不达标，先升级显示链路再投板。4–6 层、0.8 mm 仍为初步 PCB 参数。 | https://www.sifli.com/en/sf32lb58x

Sheet: 资源预算
图形与电源资源预算
黄色为设计输入或待测数据，蓝灰色为公式结果；不是实测性能。
QSPI 50 MHz 为官方驱动默认值，效率 70% 为计算假设；帧率还受绘制、同步和面板限制。
参数 / 结果 | 值 | 单位 | 说明
显示宽度 | 390 | px | B13 候选屏的已知像素宽度。
显示高度 | 450 | px | B13 候选屏的已知像素高度。
每像素字节数 | 2 | B/px | 示例 RGB565；ARGB8888 使用 4。
帧缓冲数量 | 2 | 个 | 用于双缓冲容量预算，具体渲染模式由驱动决定。
目标刷新率 | 60 | fps | 设计目标，尚未在实物验证。
显示总线时钟 | 50 | MHz | 官方 co5300.c 默认 50 MHz，并注明 RGB565 限制。需锁定 SDK 与面板版本后核对。
每拍数据位数 | 4 | bit/clock | 四数据线、单沿 QSPI，未假定 DDR 或超频。
总线有效利用系数 | 70.0% | 比例 | 工程计算假设，包含命令与传输间隙；不是实测值。
单帧数据量 | 351000 | B | 宽 × 高 × 每像素字节数。
帧缓冲总容量 | 685.55 | KiB | 1 KiB = 1024 B。
全屏刷新的数据量 | 21.06 | MB/s | 十进制 MB/s；不包含额外渲染读写。
总线理论吞吐 | 25.00 | MB/s | 时钟 × 数据线位数 / 8。
估算有效吞吐 | 17.50 | MB/s | 只用于前期预算，不能据此保证 60 fps。
刷新占估算吞吐 | 120.3% | 比例 | 超过 100% 表示按当前效率假设不能达到全屏目标帧率；真实效率与渲染仍需实测。
单帧时间预算 | 16.67 | ms | 1 秒 / 目标帧率。
实际触摸采样率 |  | Hz | 待实测；不能用渲染帧率代替触摸输入速率。
实测触摸到显示延迟 |  | ms | 用同步触发或高速视频评估典型与 P95；初始交互目标 P95 ≤80 ms，尚未验证。
设计用 PSRAM | 16 | MiB | B01 合封容量。P01 为 8 MB，试验时需改成 8 并相应缩减下方缓存预算。
双缓冲占用 | 0.67 | MiB | 由本页帧缓冲公式计算。
图像资源缓存预算 | 4.00 | MiB | 工程初始预算，可调整。
字体缓存预算 | 1.00 | MiB | 工程初始预算，可调整。
临时合成 / 解码预算 | 2.00 | MiB | 工程初始预算，可调整。
其他 PSRAM 预算 | 1.00 | MiB | 不代表所有 DMA 或任务栈都可放在 PSRAM。
已分配 PSRAM 预算 | 8.67 | MiB | 各项预算合计。
PSRAM 剩余预算 | 7.33 | MiB | 不足时应调整图形资源或架构。
PSRAM 剩余比例 | 45.8% | 比例 | 预留余量供缓存峰值和后续功能。
片内 SRAM | 576 | KiB | 芯片资料值；RTOS、协议栈、DMA 与双核分配须看 BSP 链接布局。
设计电池容量 | 300 | mAh | 按 B16 候选电芯容量预算，成品电池包规格仍待确认。
电池可用容量系数 | 80.0% | 比例 | 工程估算；受温度、老化与关机阈值影响。
目标运行时间 | 24.00 | h | 用于倒推平均电流上限。
电池侧平均电流上限 | 10.00 | mA | 要求在电池侧测量，以纳入各电源转换损耗。
实测电池侧平均电流 |  | mA | 留空直到完成指定亮屏、蓝牙与振动占空比测试。
按实测电流估算续航 |  | h | 估算值，仍需完整放电验证。
软件与测试依据
LVGL 缓冲模式 |  |  | https://lvgl.io/docs/open/9.0/porting/display.html
SiFli 电路和时钟 |  |  | https://wiki.sifli.com/hardware/SF32LB52B-E-G-J-HW-Application.html
单机软件架构 |  |  | SiFli SDK 对应 BSP + RTOS + LVGL。界面线程不阻塞采样；表冠 / 触摸事件排队处理，短中断，保留看门狗与恢复下载。
实机验证项目 |  |  | 测全屏滑动、图标缩放、卡片转场的帧时间；同时测 BLE 重连、任务栈余量、关屏电流、充电温升及完整外壳下的射频表现。
所需最低有效利用率 | 84.24% | 比例 | 全屏目标数据量 / 理论带宽。还需绘制与 DMA 并发，不能只满足算术门槛。
按假设效率的传输上限 | 49.86 | fps | 仅为传输上限，实际还受面板扫描、渲染和同步限制。
官方显示驱动 |  |  | https://github.com/OpenSiFli/SiFli-SDK/blob/main/customer/peripherals/display/co5300/co5300.c
屏幕总成资料 |  |  | https://wiki.sifli.com/en/board/sf32lb52x/SF-DevKit-LCM-Adapter.html
