zhangguotao05-zgt/iwatch/hardware/自研智能手表_离线阶段方案与BOM_v0.4.xlsx

Sheet: 阶段方案
阶段方案
v0.4 · 离线第一阶段；完整网络/应用路线推迟，健康测量仍保留。
编号 | 模块 | 本阶段安排 | 实现内容 | 边界与验证
01 | 主线 | 本阶段实现 | SF32LB58 + RT-Thread/LVGL；先开发板，再自研主板/外壳。 | 联网和官方应用不再是本阶段前置条件。
02 | 界面 | 本阶段实现 | 表盘、蜂窝图标、列表、控制中心、设置、健康/运动页面；暗色与动画。 | 60 fps 为目标；同时测触摸、表冠响应和掉帧。
03 | 基础功能 | 本阶段实现 | 本地时间、日期、闹钟、秒表、计时器；手动或有线校时。 | 离线掉电后重启、RTC 计时与闹钟必须实测。
04 | 交互 | 本阶段实现 | 触摸、可按压表冠、侧键、LRA 反馈、抬腕亮屏与休眠。 | 电机与机械安装共同决定触感；AOD 在基础休眠后优化。
05 | 心率血氧 | 本阶段实现 | 接入真实 PPG 数据和算法输出；本地显示与保存摘要。 | 开发板本身不测 HR/SpO2；外接健康模块，先验证静止血氧。
06 | 运动记录 | 本阶段实现 | IMU 计步、活动时长及简单运动页面；本地保存。 | GNSS 轨迹暂不集成；运动/睡眠算法不因离线而自动具备。
07 | 主板和外壳 | 本阶段后段 | 完全新设计；初版可用 SF58 模组 + 自研载板，紧凑版再选裸芯片。 | 模组 24×24 mm；整机厚度与电池容量仍需 3D 堆叠。
08 | 联网/同步 | 后续阶段 | 暂不开发 Wi-Fi、蜂窝网络、云服务、蓝牙数据同步和 OTA。 | SF58 内置蓝牙保留；本阶段功能在无线关闭时验收，有线烧录/日志。
09 | 微信/支付宝 | 后续阶段 | 不开发官方应用安装、聊天和真实支付，也不制作容易误认的假付款功能。 | 未来需要单独重评应用生态，不能承诺 SF58 加网络后可直接安装。
10 | 其他扩展 | 后续阶段 | ECG、腕温、NFC、GNSS、在线音乐、通话以及复杂睡眠/预警算法。 | 保持在最终方向中，暂不放入本轮采购和 PCB 必装清单。

Sheet: 开发采购
开发采购
第一批先买板屏套装与数据线；不把开发套件当成最终可佩戴主板。
编号 | 项目 | 数量 | 批次 | 采购前确认 | 价格与说明 | 来源
P01 | SF32LB58-DevKit-LCD，N16R32N1 + 配套 AMOLED | 1 | 第一批 | 按截图选择含 AMOLED 的套餐；取得能编译的屏幕/触摸例程及转接板。 | 本版建议；实际套装价格未核实 | S01/S06
P02 | USB 数据线 | 1 | 第一批 | 接 USB 转 UART 调试口；第二根线仅在同时使用芯片 USB 时需要。 | 优先使用已有数据线 | S01
P03 | 表冠原型编码器 + 按键 | 1 | 第二批 | 先用可按压编码器模块验证操作；最终机构在外壳阶段确定。 | GPIO 电平及去抖需确认 | S02
P04 | DRV2605L 评估模块 + 小型 LRA | 1 | 第二批 | 用于表冠刻度/通知反馈；先原型调校再选具体马达尺寸。 | 核对模块逻辑电平与 LRA 参数 | S13
P05 | LSM6DSO 评估模块 | 1 | 第二批 | 抬腕、计步和健康算法加速度输入。 | 核对供电/IO、数据率和时间戳 | S10/S11
P06 | MAXM86146EVSYS | 1 | 健康验证批次 | 先确认算法固件、GUI、供货及主机供数模式；接入独立健康界面。 | 有官方评估路线，价格/库存未确认 | S07/S08
P07 | 健康/主控转接线板 | 1 | 接口明确后 | 按参考图对照 VIO、GND、I2C、RESET/MFIO；不能按排针间距盲插。 | 电气检查后制作 | S02/S09
P08 | 自研载板、传感板、3D 外壳 | 1 | 开发板功能验证后 | 先做可调试版本，再收紧体积；样件数量由返板计划确定。 | 此项按一轮服务计，价格待图纸 | 工程设计

Sheet: 整机候选
整机候选
初版模组方案与裸芯片方案互斥；数量 1 的组项需在原理图阶段展开。
编号 | 功能 | 候选器件/方案 | 数量 | 设计选择 | 验证/装配条件 | 来源
B01 | 主控 | SF32LB58-MOD-N16R32N1；紧凑版 SF32LB586VDD36 | 1 | 初版优先 24×24 mm 模组；避免一开始处理裸芯片密集布线。 | 与分立方案互斥；模块内存/晶体不再重复采购。 | S01/S04
B02 | 主存储 | 模组内 16+16 MB PSRAM、16 MB NOR 与合封启动 Flash | 1 | 按模组既有配置；图形、字体、固件和历史摘要先做预算。 | 按两个 PSRAM 区域配置，不默认单一连续 32 MB 堆。 | S01/S04
B03 | 时钟 | 48 MHz + 32.768 kHz | 1 | 模块已含；裸芯片版按官方 CL/ESR 与布局要求选型。 | 不直接沿用 W5+ 平台晶体/电源设计。 | S02
B04 | 显示触摸 | 配套 1.85 英寸 390×450 AMOLED | 1 | 截图标注 QSPI 显示 + I2C 触摸；先使用随板转接与驱动。 | CO5300AF-01/FT6146-M00 来自截图；RGB565 总线模式须核实。 | S06
B05 | 屏接口与电源 | 跟随配套屏参考设计 | 1 | 连接器、供电、电平、初始化与 TE/RESET 一并匹配。 | QSPI 面板不能靠改软件变成 MIPI；换屏需转接与驱动。 | S01/S02
B06 | 光学健康模块 | MAXM86146CFU+ | 1 | 内含 AFE、算法 MCU 与双 PD；主机 I2C 与控制脚。 | 外部 LED、算法固件和佩戴光学仍然必需。 | S07
B07 | 红/红外 LED | SFH 7015 | 1 | 按 EVSYS 参考选择红光/红外组件。 | 完整分档和当前供货随健康板验证确认。 | S09
B08 | 绿光 LED | CT DBLP31.12-6C5D-56-J6U6 | 2 | 按 EVSYS 参考；替代需验证光学和算法设置。 | 保留遮光和皮肤接触设计。 | S09
B09 | LED 切换 | MAX14689EWL+ | 1 | 与参考板的四发光芯片/三驱动通道拓扑配套。 | 不能只接三个 LED 驱动通道就忽略切换配置。 | S09
B10 | 健康板时钟/电源 | 参考时钟、1.8 V 域、LED 电源与去耦 | 1 | 根据健康模块手册展开；电源和地布局控制噪声。 | 不把芯片电源直接接电池，不凭外观判断 IO 电平。 | S09
B11 | 运动 IMU | LSM6DSOTR | 1 | 抬腕/计步；SF58 采集并通过支持的协议供给健康算法。 | LSM6DSO 不是算法内部驱动的即插即用替代；验证同步和采样率。 | S10/S11/S12
B12 | 健康光学结构 | 遮光墙、光学窗、贴肤支撑 | 1 | 先可调整光学样件，后固定进新后盖。 | 无效信号应显示未测得，不能显示成正常数值。 | S07/S09
B13 | 振动驱动 | DRV2605L | 1 | I2C 控制 LRA；原型阶段用评估模块。 | 核对 1.8 V 逻辑兼容及马达额定参数。 | S13
B14 | 马达 | 小型 LRA，MPN 随外壳确定 | 1 | 同一马达在不同安装刚度下响应不同。 | 预留刚性支撑与独立调校空间。 | S13
B15 | 表冠/按键 | 可按压旋转机构 + 侧键 | 1 | GPIO/编码器输入；先模块验证后选最终机构。 | 端口中断、去抖、按压/旋转同时操作实测。 | S02
B16 | 主电源 | SF30147C + SF58 参考电源树 | 1 | 作为可穿戴板候选；模块方案遵循模块供电要求。 | 开发板已含供电；自研板重新核对所有电压域和峰值电流。 | S02
B17 | 电池充电 | BQ25180，或完整官方充电参考方案 | 1 | 单节电池充电/电源路径；二选一并与 B16 做电源树核对。 | 实际电芯终止电压、电流、NTC、保护与散热确定后冻结。 | S14
B18 | 电池 | 单节 LiPo；300–500 mAh 仅初期体积评估范围 | 1 | 优先满足尺寸、内阻、保护及温度要求。 | 本版资源表以 400 mAh 做假设；不保证最终容量/续航。 | 工程假设
B19 | 充电接入 | 磁吸触点/底座；无线接收后续评估 | 1 | 原型用 USB；优先简化第一次整机充电调试。 | 不假定兼容 Apple 原装无线充电盘。 | 工程选择
B20 | PCB/FPC/调试 | 自研载板 + 健康板/FPC + UART/SWD/BOOT 测试点 | 1 | 开发板不放入表壳；载板先保留测试点，再收紧结构。 | 层数/板厚由实际布局决定；保留离线恢复刷机路径。 | S01/S02
B21 | 外壳/表带连接 | 完全新设计中框、后盖、盖板与连接机构 | 1 | 3D 样件核对屏幕、电池、马达、光学和表冠堆叠。 | 不直接承诺 Apple 尺寸、厚度、防水或重量。 | 用户目标
B22 | 无源/连接器 | 按原理图展开 |  | 电感、电容、电阻、ESD、排线座及封装尾码。 | 当前是选型级 BOM，不能直接作为生产贴片清单。 | 工程设计

Sheet: 资源预算
资源预算
黄色为假设；显示、RAM、存储和续航均需实际测量替换。
参数 | 值 | 单位 | 说明
屏幕宽 | 390 | pixel | 来自商品截图；以实际屏为准
屏幕高 | 450 | pixel | 来自商品截图；以实际屏为准
目标刷新率 | 60 | Hz | UI 目标，非开发板已测帧率
QSPI 时钟假设 | 50 | MHz | 演算值；须查面板/板级驱动可用时钟
QSPI 数据线数 | 4 | bit/cycle | SDR 假设；不套用 DDR 倍率
理论吞吐量 | 25.00 | MB/s | 不含协议、DMA 调度和屏幕等待
RGB888 一帧 | 526500 | byte | 线传 24 bit/pixel 假设
RGB888 传输时间 | 21.06 | ms | 只含有效像素字节
RGB565 一帧 | 351000 | byte | 仅当驱动和屏幕实际支持线传 16 位
RGB565 传输时间 | 14.04 | ms | 渲染 16 位不代表总线也传 16 位
目标帧周期 | 16.67 | ms | 渲染和传输可重叠程度需测量
RGB565 双帧缓冲 | 0.67 | MiB | 只是帧缓冲，不含图形资源与中间缓冲
图形资源/缓存预算 | 8 | MiB | 自定初值，按 SDK 内存区域实际分配
应用堆预算 | 2 | MiB | 自定初值，量测堆/栈高水位后调整
外部 NOR 规划 | 容量 | MiB | 初始规划；合封启动 Flash 另按 BSP 管理
固件 | 6 | MiB | 以链接产物为准；不预留联网 OTA 双镜像
字体/图标/表盘 | 6 | MiB | 先压缩资源并裁剪字体
摘要/设置 | 2 | MiB | 原始 PPG 调试数据输出 PC
余量 | 2 | MiB | 按文件系统开销调整
合计 | 16 | MiB | 与 16 MB 外部 NOR 实际分区核对
电池容量假设 | 400 | mAh | 体积/电芯未选定
标称电压假设 | 3.85 | V | 不是充电终止电压
可用能量系数 | 85% | 比例 | 简化余量/截止假设
可用能量 | 1309.00 | mWh | 按电池端能量计算
工作时长目标 | 24 | h | 整机设计目标，非实测续航
允许平均功耗 | 54.54 | mW | 电池端口径；不再次扣电源效率
重点验证 | 方法
内存/时钟 |  |  | 主系统先按最高 240 MHz 验证；PSRAM 16+16 MB 不是默认连续单堆。
中断/采样 |  |  | 用逻辑分析仪和 FIFO 计数检查采样丢失、I2C 时序、数据单位和时间戳。
显示链路 |  |  | 测 QSPI/TE/DMA、帧耗时和触摸响应，确认实际线上像素格式。
离线稳定性 |  |  | 测试 RTC、闹钟、掉电记录恢复、看门狗与有线恢复下载。
整机功耗 |  |  | 测最终板电池端电流、休眠唤醒及 LED 脉冲；开发板电流不能直接推算整机。

Sheet: 资料来源
资料来源
网页核查：2026-09-11；价格未确认；截图参数仅作为原型候选。
编号 | 资料 | 链接/出处 | 核实范围
S01 | SF58 开发板官方指南 | https://wiki.sifli.com/board/sf32lb58x/SF32LB58-DevKit-LCD.html | N16R32N1、USB 转 UART、屏幕接口和板级设计文件。
S02 | SF58 硬件设计指南 | https://wiki.sifli.com/en/hardware/SF32LB58x-HW-Application.html | 48 MHz/32.768 kHz、供电域、SF30147C、表冠/马达、PCB 指导。
S03 | SiFli SDK | https://github.com/OpenSiFli/SiFli-SDK | RT-Thread 与图形框架；采用匹配开发板和屏幕的稳定工程。
S04 | SiFli 模组型号指南 | https://wiki.sifli.com/silicon/%E6%A8%A1%E7%BB%84%E5%9E%8B%E5%8F%B7%E6%8C%87%E5%8D%97.html | SF32LB58-MOD-N16R32N1 为 24×24 mm；16+16 MB PSRAM 与 16 MB 外部 NOR。
S05 | SF32LB58X 产品页 | https://www.sifli.com/zh-hans/node/29 | 主系统最高 240 MHz；本版不假设所有核心/存储均归 UI 独占。
S06 | 用户提供的开发板商品截图 | 用户提供截图，2026-09-11 | 1.85 英寸、390×450、QSPI 显示/I2C 触摸；截图选中 A128R32N1 和板卡项，不能把截图价格当带屏套装报价。
S07 | MAXM86146 产品页 | https://www.analog.com/en/products/maxm86146.html | 集成 AFE、算法 MCU、双 PD；还需 LED、运动样本、固件与光学结构。
S08 | MAXM86146EVSYS | https://www.analog.com/en/resources/evaluation-hardware-and-software/evaluation-boards-kits/maxm86146evsys.html | 评估板和固件/GUI 入口；具体价格、库存与下载权限未确认。
S09 | MAXM86146EVSYS 电路与用料 | https://www.analog.com/media/en/technical-documentation/data-sheets/maxm86146evsys.pdf | SFH 7015、两颗绿光 LED、LED 切换电路和供电/时钟参考。
S10 | ADI 加速度兼容性 FAQ | https://ez.analog.com/other-products/a/documents/do21669/what-accelerometers-are-supported-by-the-max32664c-firmware | 新 IMU 需采用主机供数等受支持模式，不是直接替换内置驱动型号。
S11 | ST LSM6DSO | https://www.st.com/en/mems-and-sensors/lsm6dso.html | 在产六轴 IMU，用于运动检测及健康算法的加速度输入候选。
S12 | ST LIS2DS12 | https://www.st.com/en/mems-and-sensors/lis2ds12.html | 官方已列为 Obsolete；不作为新板默认用料。
S13 | TI DRV2605L | https://www.ti.com/product/DRV2605L | 支持 LRA/ERM 触觉驱动，最终手感须机械和波形调校。
S14 | TI BQ25180 | https://www.ti.com/product/BQ25180 | 单节电池充电与电源路径候选，充电参数按实际电芯确定。
S15 | 奥视特 MIPI 屏候选 | https://www.aoshite.net/productView1_1975.html | ET020AM03-HT 可作为之后的屏幕评估分支，时序/驱动/现货仍待确认。
