zhangguotao05-zgt/iwatch/docs/SF32LB58开发板资料与首次调试.html

iwatch SF32LB58 开发板资料与首次调试

# SF32LB58 开发板资料与首次调试

历史调试快照（归档日期：2026-09-15）：本节记录首次无屏验证阶段，保留当时 SDK 安装、编译、串口烧录与回读结果。屏幕后来已经点亮；旧演示固件见 板上历史基线，D01–D03 新固件见 正式板上验收。本页的“无屏”和栈峰值 91% 不代表当前硬件状态。

当前按此前确认的 SF32LB58-DevKit-LCD + 1.85 英寸、390×450 QSPI AMOLED 触摸屏套装整理。实测开发板为 A128R32N1 存储配置，芯片启动信息为 Chip:2, Package:0, Rev:1，即 SDK 所称的 SF32LB58 A1 修订版。

## 2026-09-15 实物验证结论

项目 | 实测结果
下载串口 | CH342 Serial-A，Windows COM9，1,000,000 baud
HCPU 日志与 MSH | CH342 Serial-B，Windows COM10，1,000,000 baud
NAND | ID 0xC891C8，BBM 初始化成功，应用地址 0x68000000 可读写
SDK | v2.5.1，commit 421126d9f476ed8e2a6f0b0ca28a9f241c182e65
示例 | example/multimedia/lvgl/watch_v9
启动状态 | RT-Thread shell、LVGL、GPU 和 Main 图形应用均已启动；转场完成 res=0

首次按原始 sf32lb58-lcd_a128r32n1_qspi 配置构建时，固件在 rt_hw_board_init() 主动停止并打印：

Wrong board is used!! It's SF32LB58 A1 chip revision, please use board with A1 chip revision!
Please enable LCPU_CONFIG_AUTO and ensure LCPU_CONFIG_V2 is not enabled in BOTH HCPU and LCPU config!

本板的修正方式是在以下两个官方板级配置文件中加入 CONFIG_LCPU_CONFIG_AUTO=y，然后重新生成配置并完整重编译：

customer/boards/sf32lb58-lcd_a128r32n1_qspi/hcpu/board.conf
customer/boards/sf32lb58-lcd_a128r32n1_qspi/lcpu/board.conf

修正后的 HCPU 和 Bootloader .config 均为 CONFIG_LCPU_CONFIG_AUTO=y、CONFIG_LCPU_CONFIG_V2 未启用；构建系统针对本芯片生成 LCPU_CONFIG_V1 编译定义。不要再使用未修正的 V2 固件。

本次修正版烧录内容如下，三段均由 sftool 开启写后校验：

内容 | 地址 | 字节数 | SHA256
ftab.bin | 0x1C000000 | 11,288 | 806582A790C58582DDEF2CF5E721F7602A1AD4844704712C107E555E0C9DE221
bootloader.bin | 0x1C020000 | 46,144 | 803504F7A4BEEB2C62ED4CCEFD101D496F376E8F78B4099F928ADF66FCF68D45
main.bin | 0x68000000 | 5,709,092 | BD7C93A2B1FCC38CFEE4B94079A8140E0A894CA3D3801F336BFC25FF81983A90

无屏启动时出现以下现象，符合当前没有连接显示触摸模组的硬件状态：

- CO5300 读 ID 为 0xFFFFFF，驱动进入 NOT_FIND 并关闭 LCD 供电；
- FT6146 驱动已注册，但 I2C4 无器件应答并报告总线错误；
- 图形应用仍完成初始化并进入 Main 页面，串口 shell 可正常执行命令。

另有三个 flash1 is not found 的 FAL 报错，目前未阻止 NAND 主镜像或应用启动，后续启用资源文件系统时需要单独核对分区设备名。无屏阶段 free 显示 RT-Thread 管理堆总量 1,809,900 字节、已用 58,928 字节；当时 tpread 的 1 KiB 栈峰值达到 91%。D01–D03 固件已改用 2 KiB 栈，最终实屏压力峰值为 39%；FAL 持久化问题仍未关闭。

## 官方资料入口

资料 | 能解决的问题
开发板中文使用指南 (https://wiki.sifli.com/board/sf32lb58x/SF32LB58-DevKit-LCD.html) | 板卡版本、供电、接口、Mode 跳线、下载和调试接线
指南的官方 GitHub 源文件 (https://github.com/OpenSiFli/SiFli-Wiki/blob/main/source/zh_CN/board/sf32lb58x/SF32LB58-DevKit-LCD.md) | Wiki 访问较慢时可查看同源说明和连接图
开发板设计图纸 V1.0.1 ZIP (https://downloads.sifli.com/hardware/files/documentation/SF32LB58-DevKit-LCD-V1.0.1.zip) | 原理图 PDF/源文件、PCB、BOM、Gerber、贴片及钢网资料
开发板立创 EDA 专业版工程 (https://downloads.sifli.com/hardware/files/documentation/ProPrj_SF32LB58-DevKit-LCD_2025-09-24.epro) | 可导入的官方开发板电路及 PCB；已确认压缩包内有 5 个原理图页和 1 个 PCB 文件
模组设计图纸 V1.0.1 ZIP (https://downloads.sifli.com/hardware/files/documentation/SF32LB58-MOD-V1.0.1.zip) | 模组内部主控、电源、存储器、时钟及布板参考，包含两种存储版本的 BOM
芯片资料总入口 (https://wiki.sifli.com/silicon/index.html) | SF32LB58x 数据手册、用户手册与模组规格书
SDK v2.5.1 发布页 (https://github.com/OpenSiFli/SiFli-SDK/releases/tag/v2.5.1) | 本次核查的 SDK 版本，2026-08-27 发布
SDK 上手指南 (https://docs.sifli.com/projects/sdk/latest/sf32lb58x/quickstart/get-started.html) | 工具链、SDK 和基本使用流程
CodeKit 安装指南 (https://docs.sifli.com/projects/codekit/get-started/) | 在 VS Code 中安装、管理开发环境；SDK 上手文档推荐的安装方式
Windows 安装说明，固定 v2.5.1 (https://github.com/OpenSiFli/SiFli-SDK/blob/v2.5.1/docs/source/zh_CN/quickstart/install/script/windows.md) | 手动安装、子模块、工具链和终端环境激活
官方调试工具汇总 (https://wiki.sifli.com/tools/index.html) | Impeller 烧录工具、Sifli_Trace 日志工具等

官方开发板图纸与本仓库的自研手表原理图是两个工程。上面官方包里的 PCB/Gerber 属于开发板，不表示自研手表 PCB 已完成。

## 选对 QSPI 板型

SDK v2.5.1 已提供专门的 QSPI 配置；本套装应按实际存储型号选择以下目标。不要因为开发板名称带 LCD，就套用 DSI/DPI 屏的配置。

板上模组标识 | 外部资源 Flash | 合封 PSRAM 总量 | SDK 板型
SF32LB58-MOD-A128R32N1 | 128 MB QSPI NAND | 16 MB + 16 MB | sf32lb58-lcd_a128r32n1_qspi
SF32LB58-MOD-N16R32N1 | 16 MB QSPI NOR | 16 MB + 16 MB | sf32lb58-lcd_n16r32n1_qspi

两种模组还有 1 MB 合封 NOR。V1.0.1 官方配置采用 SF32LB586VDD36，外部晶体为 48 MHz 和 32.768 kHz；晶体频率不等于应用运行主频。首次调试保持对应 BSP 的默认时钟和存储配置。

依据：官方板型指南 (https://wiki.sifli.com/board/devkit_guide.html)、A128 板型说明 (https://github.com/OpenSiFli/SiFli-SDK/blob/v2.5.1/customer/boards/sf32lb58-lcd_a128r32n1_qspi/doc/index.md)、A128 配置 (https://github.com/OpenSiFli/SiFli-SDK/blob/v2.5.1/customer/boards/sf32lb58-lcd_a128r32n1_qspi/hcpu/board.conf)、N16 配置 (https://github.com/OpenSiFli/SiFli-SDK/blob/v2.5.1/customer/boards/sf32lb58-lcd_n16r32n1_qspi/hcpu/board.conf)。

## 屏幕、触摸与手表 UI 示例

A128 QSPI 板型的官方说明明确写出默认转接屏为 LCD_1P85_390*450_DevKit_Adapter_V1.0.0。两种 QSPI 板型配置均启用 CO5300 显示驱动，并将触摸设备总线设为 i2c4。

内容 | 固定 v2.5.1 的源码入口
CO5300 显示驱动 | customer/peripherals/display/co5300/co5300.c (https://github.com/OpenSiFli/SiFli-SDK/blob/v2.5.1/customer/peripherals/display/co5300/co5300.c)
原套装标注的 FT6146 触摸驱动 | customer/peripherals/touch_panel/ft6146 (https://github.com/OpenSiFli/SiFli-SDK/tree/v2.5.1/customer/peripherals/touch_panel/ft6146)
后续 CWS05 对应的 CST820 驱动 | customer/peripherals/touch_panel/cst820 (https://github.com/OpenSiFli/SiFli-SDK/tree/v2.5.1/customer/peripherals/touch_panel/cst820)
LVGL 9 手表界面 | example/multimedia/lvgl/watch_v9 (https://github.com/OpenSiFli/SiFli-SDK/tree/v2.5.1/example/multimedia/lvgl/watch_v9)

watch_v9 自带蜂窝菜单、表盘和立方体旋转演示，是本项目验证界面效果的起点。官方 GCC 构建配置 (https://github.com/OpenSiFli/SiFli-SDK/blob/v2.5.1/build_config_gcc.yaml) 明确列出了该示例与上述两种 QSPI 板型的组合；本项目已完成 A128 QSPI 板型的有屏冷启动、触摸和 D01–D03 压力实测。

SDK 中存在驱动不等于任意同主控屏都能直接替换。原开发套装与拟选 CWS05 的触摸芯片、供电、连接器和初始化参数需要分别核对。CWS05 接口问题继续以 已有评估 为准。

首次界面内存预算可以从 RGB565 开始：390×450 单帧为 351,000 字节，约 343 KiB，双帧约 686 KiB；这只是像素缓冲，不包含字体、图片、渲染临时内存和任务栈。模组标称 32 MB PSRAM 也不代表这些容量都已分配给 HCPU 的同一个可用堆。

另外，SiFli Solution 板级介绍 (https://docs.sifli.com/projects/solution/open-source-community/board_introduction.html) 还提供更完整的手表应用方案，明确包含 SF32LB58 + 390×450 QSPI 配置。Solution 是独立工程体系，工程路径和依赖版本应按其自身文档选择；首次点亮可先用上述 SDK 示例。

## 首次调试顺序

1. 记录板上模组型号、PCB 版本和屏幕转接板标识，核对套装连接方式。保留出厂程序运行画面及日志，作为硬件工作的基准。
2. 使用数据线连接板上的 USB-to-UART 口，在 Windows 设备管理器确认串口。板上另一个 USB 功能口也能供电，但首次串口下载应使用 USB-to-UART。
3. 按 CodeKit 或固定版本 Windows 文档准备 SDK v2.5.1 环境。通过 Git 取得 SDK 时要初始化子模块；GitHub 的普通源码 ZIP 不包含全部子模块内容。
4. 先验证串口日志和最小示例，再编译 watch_v9。验证下载流程时，按实物板版本的指南设置 Mode 跳线；官方指南规定插上为下载模式，取下为正常运行模式，模式切换后重新复位/上电。
5. 在官方界面上检查整屏颜色、刷新、四角触摸坐标和滑动方向，然后开始自定义表盘、菜单与转场。

当 SDK 和工具链安装完成、终端已执行该 SDK 根目录下的 export.ps1 后，可在 SDK 的 example/multimedia/lvgl/watch_v9/project 目录编译。例如实际为 A128R32N1 时：

scons --board=sf32lb58-lcd_a128r32n1_qspi -j8

实际为 N16R32N1 时，改用 --board=sf32lb58-lcd_n16r32n1_qspi。本次实物的 A1 修正必须先应用到 HCPU、LCPU 两份板级配置，再执行上述构建命令。

## 本地下载记录

以下官方原件已下载到项目本地的 references/vendor/sifli-sf32lb58/，并通过压缩包完整性检查。该目录由 .gitignore 排除；仓库保存索引和原厂链接。downloads.json 记录了原始下载地址、大小、SHA256 和包内文件列表。

文件 | 字节数 | SHA256
SF32LB58-DevKit-LCD-V1.0.1.zip | 3,578,531 | 6524cf82bc13801054ccc3e0028a738f3fec859a6c1bb5aa580d1ec856e7fb3a
ProPrj_SF32LB58-DevKit-LCD_2025-09-24.epro | 837,483 | 562c49859dd3e17eb18e27b2021f467faa8523de4888cb3688752a07dc55d995
SF32LB58-MOD-V1.0.1.zip | 2,828,734 | dc97992b2d78225a0a5c2ef98e4c68c09ac6a03211f4b7f557d8e6db62d12ba7

压缩包检查证明本次下载未发现归档校验错误；SDK 板级配置和开发板串口已用于本次实物验证，官方 EDA 工程仍未导入核查。

iwatch 工程文档 · SF32LB58 / RT-Thread / LVGL
