zhangguotao05-zgt/iwatch/hardware/原理图_v0.3_封装与接口完善/上电与固件调试.html

iwatch v0.3 上电与固件调试

# v0.3 上电与固件调试

状态：执行步骤和设计预算，尚未进行实物测试。先在开发板完成 UI/屏幕/触摸，再逐项迁移到自制主板。

## MCU、时钟和内存

项目 | 本版约定
MCU | SF32LB586VDD36，BGA256，直接贴装
时钟 | 48 MHz 主晶体 + 32.768 kHz 低速晶体；PPG 独立 32.768 kHz
HCPU | 目标上限 240 MHz；首次启动沿用匹配芯片的官方 BSP 保守配置，再验证升频
存储 | SiP 16+16 MB PSRAM、1 MB NOR；U104 额外 16 MB、3.3 V QSPI NOR
UI 基准 | 390×450，RGB565 单帧 351,000 B，双帧 702,000 B，约 686 KiB
额外内存 | 纹理、字体、LVGL heap、DMA buffer、任务栈分别统计；32 MB 总容量不能代替可用地址区/总线可达性检查
调试 | SWD/UART 均为 1.8 V；J101 的 VTREF 是目标参考，不能作为外部强制供电输入
网络 | 本版关闭蓝牙/RF；BRF_ANT 尚未连接天线

开发板 BSP 与自制板 GPIO、时钟、供电控制并不保证相同，烧录前按 pin-net-map_v0.3.csv 移植。

## 断电检查

1. 检查极性、BGA A1 和芯片方向，检查 USB-C 外壳、各 IC EP 和 LED 2/3 阴极焊盘。确认所有 GND 球位可回流到连续地平面。
2. 验证 VSYS、1.8 V、3.3 V、5 V 对地无硬短；不能用某个统一电阻阈值代替电容充电过程判断。
3. C140–C143、R112、R115、R401、R402 为 DNP。R112/R115 是电源开关旁路，未经判断不要补焊；触摸 I2C 上拉按套装转接板是否已有上拉决定。
4. 电池、屏幕、LRA 先不连接。确认 J202 实际焊线：1=PACK+，2=PACK-，3=NTC；电池包自带保护电路仍是必要设计前提。

## 分步上电

步骤 | 操作和观察 | 进入下一步的条件
1 | 用限流台式电源从电池入口提供 3.7 V；首次设约 50 mA 只用于短路筛查。该限流值不保证 MCU 能启动 | 无异常发热或硬短；观察限流/启动波形后按负载增加限流，不能带故障直接放宽
2 | 保持 BOOST5_EN/HAPTIC_EN 为低，测 TP002/003/004；按器件手册容差判断 VSYS、1.8 V、3.3 V | 稳态电压及启动波形正确，MCU 核心各内部电源没有被错接到外部电源
3 | 1.8 V 调试器连接 J101；检查 RESET_N、BOOT_MODE 和 UART 输出；运行最小 GPIO/串口程序 | 冷启动、复位、下载均可重复，尚不启动高电流外设
4 | 固件使能 SiP 电源，再做 PSRAM 内存读写；使能 Flash 电源后检查 ID、擦写/回读 | 每个内存区通过地址/数据模式检查，掉电前总线置高阻避免反向供电
5 | 使用套装转接板，先确认排针 1 脚和 3.3 V/5 V 引脚，再点亮屏幕；初始降低亮度，单独测电流 | 稳定纯色、棋盘格、滑动和触摸坐标；长时间刷新无撕裂、掉电、复位
6 | SENS 总线先用 100 kHz；读 LSM6DSO 身份与采样，检查中断；再按手册启动 PPG | 总线电平 1.8 V，无重复上拉过强或时序异常；PPG 按其官方协议复位/握手
7 | 开启 5 V 并从低 LED 脉冲电流开始，观察 5 V 下陷、地噪声和原始 PPG | 主控不复位，PPG 不饱和；屏幕与 LED 同时工作仍稳定
8 | 确认实际 LRA 的额定电压和谐振频率，设置 DRV2605L，再执行校准和短脉冲 | 振动期间电压与温升合格，无过驱动
9 | 接入已确认型号的电池/NTC，单独验证充电、拔插 USB、低电压和休眠唤醒 | 全工作范围和故障行为通过，再进入佩戴样机测试

充电芯片 R203=6.98 kΩ，名义充电电流按手册常数约 890/6980=127.5 mA；不包含芯片/电阻误差和热调节。R204=3.09 kΩ，EN1 高/EN2 低是本版固定 500 mA 输入模式。PTC 的 0.5 A hold 是室温指标，温升后需降额。

## 供电预算：计算模板，不是测量结果

测试顺序先保证单个外设稳定，再同时开启。电源芯片的开关限流和系统允许输出电流不是同一个量。

电源 | 初步测试分配示例 | 输出功率
1.8 V | 100 mA | 0.180 W
3.3 V | 50 mA | 0.165 W
5 V | 50 mA | 0.250 W
合计 | LRA 关闭，充电关闭 | 0.595 W

以上是用于安排第一轮测量的假设，不能代表真实 MCU/屏幕/PPG 消耗，也不是最大工作电流。若 VSYS=3.0 V、统一按 80% 效率估算，输入约 0.595/(3.0×0.8)=248 mA，另加未计入的直接供电负载和静态电流。实际应分别用各转换器效率曲线计算并测量。LED 脉冲峰值、触觉启动和显示白屏电流必须单独测试；电池的瞬时能力可能先于平均功耗成为限制。

L301/L303 的 XFL3012-222MEC 饱和电流按电感下降 10%/20%/30% 的定义分别不同；不能把某个较大的 Isat 数字当作零降额额定电流。要在输入最低电压、最大负载下算平均电流加半个纹波峰峰值，再结合电感/开关限流和温升评估。各输出 MLCC 必须采用偏压后的有效电容。

## 测试点

位号 | 网络 | 观察重点
TP001 | GND | 探头就近地参考，避免长接地线
TP002 | VSYS | 电池与 USB 切换、系统峰值负载
TP003 / TP004 / TP005 | +1V8 / +3V3 / +5V_SW | 启动、纹波、负载阶跃；5 V 受使能控制
TP006 / TP007 | VDD_SIP / FLASH_VDD | 供电开启顺序、关闭后的反向供电
TP008 / TP009 | RESET_N / BOOT_MODE | 复位和下载状态；两者上拉电压域不同
TP010 / TP011 | SENS_SCL / SENS_SDA | 1.8 V I2C 波形和上升沿
TP012 / TP013 | PPG_MFIO / PPG_RST_N | 官方 PPG 启动/中断协议
TP014 / TP015 | HAPTIC_EN / BOOST5_EN | 启动默认关闭、按顺序开启
TP016 | VBAT_ADC | 4.2 V 电池名义分压约 0.757 V；验证 ADC 校准与采样时间

不在晶体引脚上直接挂普通长探头/测试点；测量手段的电容可能改变振荡。

完成记录至少包括：板版本、BOM 修订、固件 commit/BSP 版本、供电电压、室温、每种模式平均/峰值电流、关键波形和异常复现步骤。

iwatch 工程文档 · SF32LB58 / RT-Thread / LVGL
