zhangguotao05-zgt/iwatch/hardware/4mm磁吸母头封装/4mm磁吸母头_封装尺寸预览.pdf

# 4mm 磁吸母头 · PCB 封装

PCB 顶视图 | 单位：mm

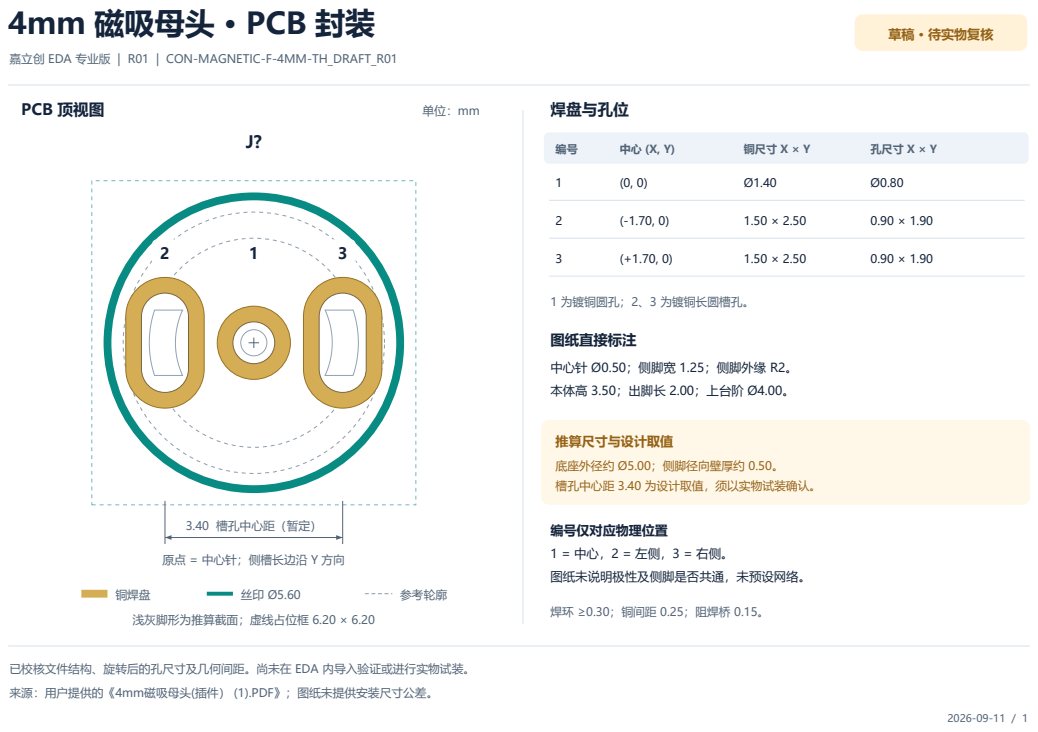
[picture p22: page 1]
草稿 · 待实物复核; 3.40 槽孔中心距（暂定）; 铜焊盘; 参考轮廓; 浅灰脚形为推算截面；虚线占位框 6.20 × 6.20; 焊盘与孔位; 铜尺寸 X × Y; 孔尺寸 X × Y; 1 为镀铜圆孔；2、3 为镀铜长圆槽孔。; 图纸直接标注; 推算尺寸与设计取值

嘉立创 EDA 专业版 | R01 | CON-MAGNETIC-F-4MM-TH_DRAFT_R01

中心针 Ø0.50；侧脚宽 1.25；侧脚外缘 R2。
本体高 3.50；出脚长 2.00；上台阶 Ø4.00。

底座外径约 Ø5.00；侧脚径向壁厚约 0.50。
槽孔中心距 3.40 为设计取值，须以实物试装确认。

编号仅对应物理位置
图纸未说明极性及侧脚是否共通，未预设网络。

原点 = 中心针；侧槽长边沿 Y 方向

焊环 ≥0.30；铜间距 0.25；阻焊桥 0.15。

已校核文件结构、旋转后的孔尺寸及几何间距。尚未在 EDA 内导入验证或进行实物试装。
来源：用户提供的《4mm磁吸母头(插件） (1).PDF》；图纸未提供安装尺寸公差。
