zhangguotao05-zgt/iwatch/hardware/原理图_v0.1/HealthWatch-SF58-v0.1-原理图审阅.pdf

# HealthWatch-SF58-Offline-v0.1 | 01 CORE AND DEBUG

### SF32LB58 module carrier | PA bank selectable; PB / SWD / UART = 1.8 V

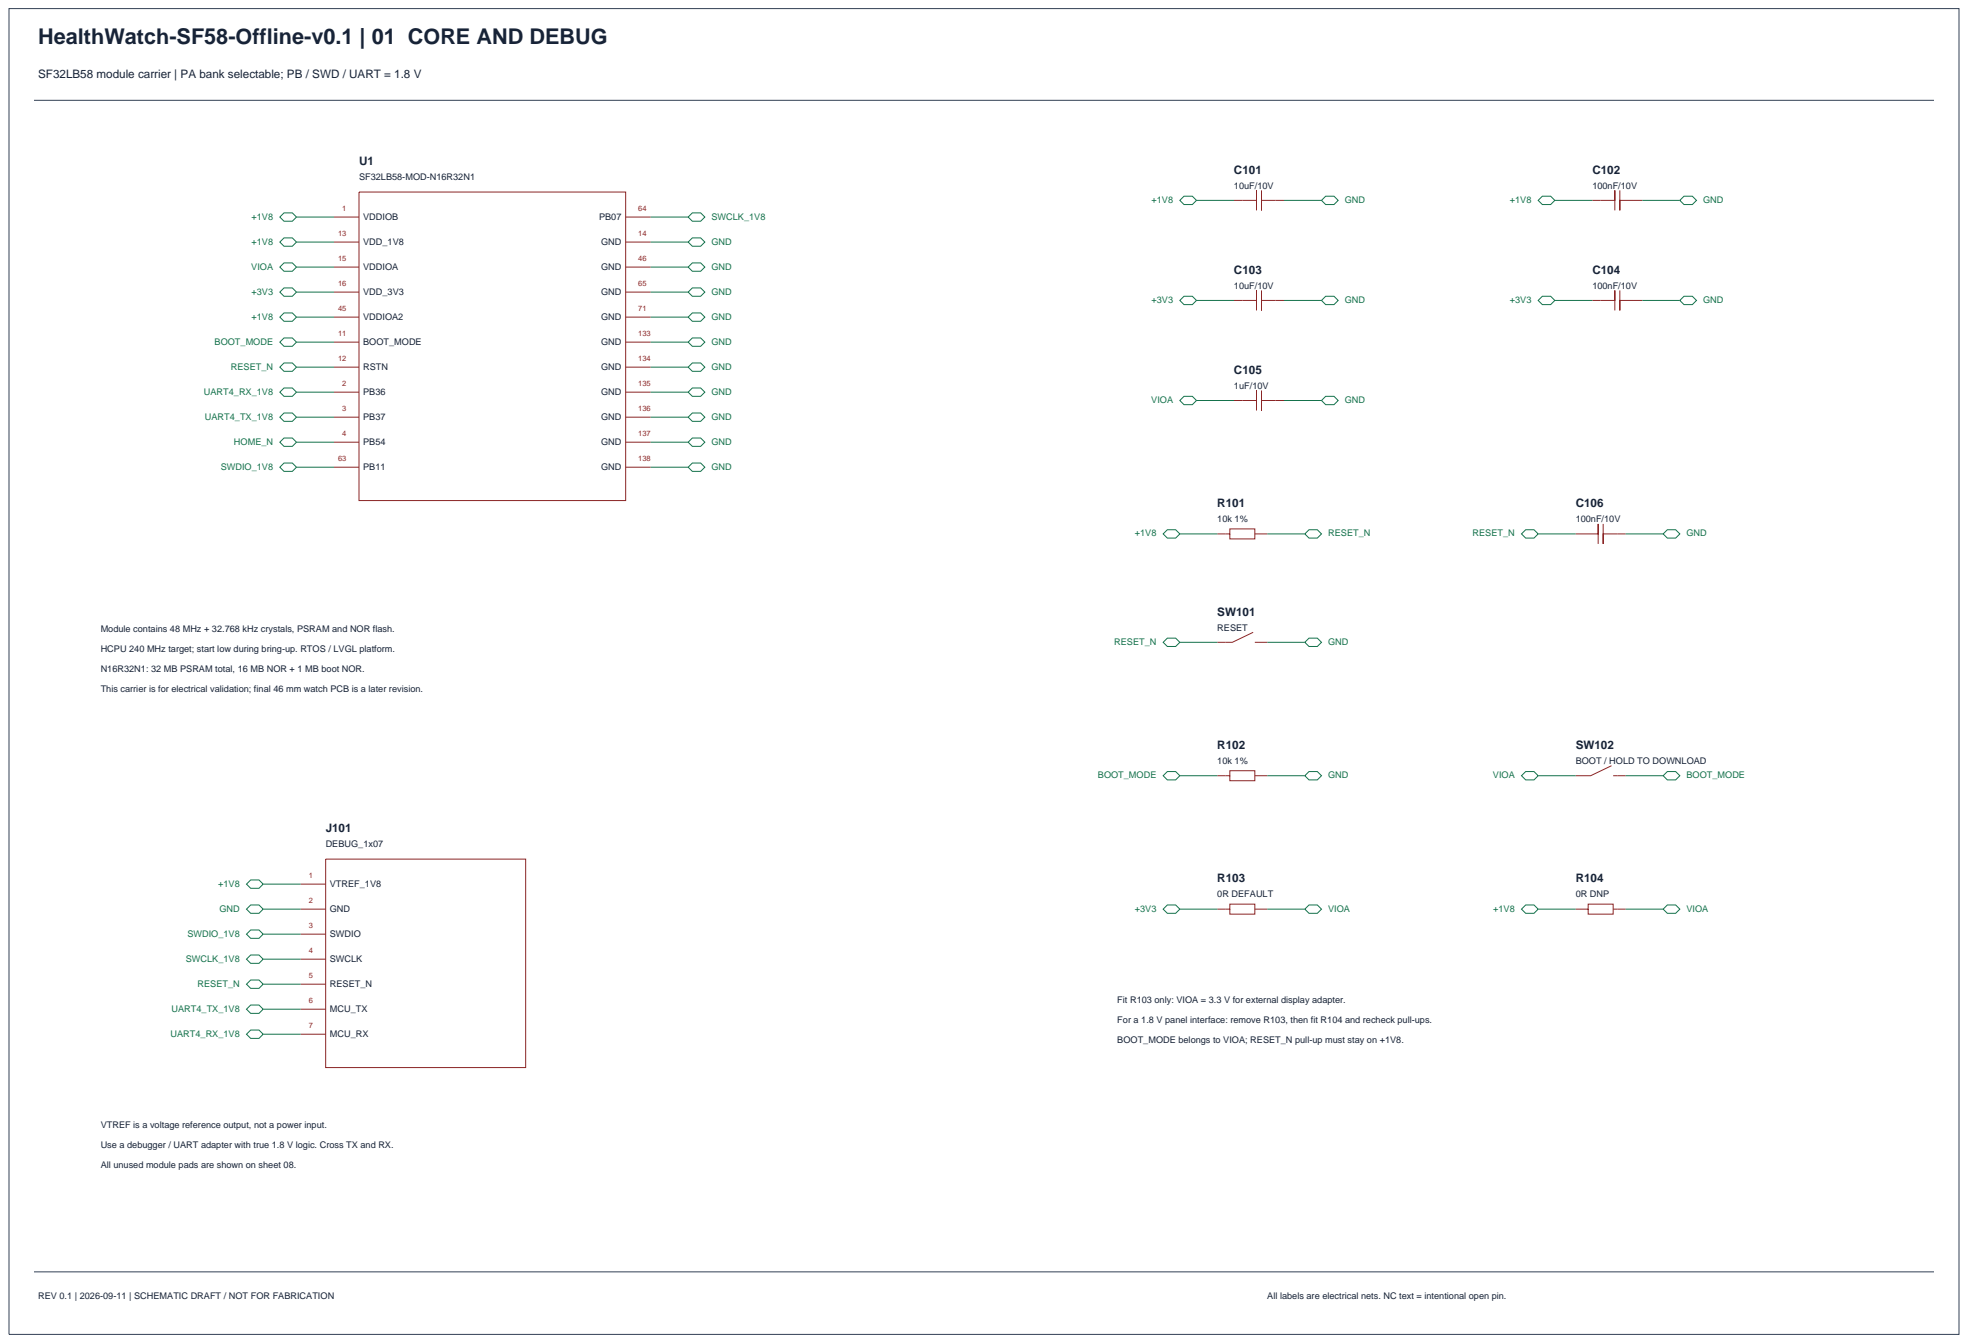
[picture p23: page 1]

Module contains 48 MHz + 32.768 kHz crystals, PSRAM and NOR flash.
HCPU 240 MHz target; start low during bring-up. RTOS / LVGL platform.
N16R32N1: 32 MB PSRAM total, 16 MB NOR + 1 MB boot NOR.
This carrier is for electrical validation; final 46 mm watch PCB is a later revision.

BOOT / HOLD TO DOWNLOAD

Fit R103 only: VIOA = 3.3 V for external display adapter.
For a 1.8 V panel interface: remove R103, then fit R104 and recheck pull-ups.
BOOT_MODE belongs to VIOA; RESET_N pull-up must stay on +1V8.

VTREF is a voltage reference output, not a power input.
Use a debugger / UART adapter with true 1.8 V logic. Cross TX and RX.
All unused module pads are shown on sheet 08.

# HealthWatch-SF58-Offline-v0.1 | 02 BATTERY AND CHARGER

BQ24074 power path | single-cell 4.2 V charge termination | nominal 128 mA initial charge current

J201
USB-C_POWER_ONLY

VBUS

A4

VBUS

A9

VBUS

B4

VBUS

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
SHIELD

S1

USB_VBUS_RAW

USB_VBUS_RAW

USB_VBUS_RAW

USB_VBUS_RAW

CC1

CC2

GND

GND

GND

GND

GND

R201
5.1k 1%
CC1 | GND

R202
5.1k 1%
CC2 | GND

F201
PTC 0.5A / >=12V
USB_VBUS_RAW | USB_5V

U201
BQ24074RGTR

IN

13

CE_N

4

EN2

5

EN1

6

ILIM

12

ISET

16

TS

1

TMR

14

ITERM

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
PGOOD_N

7

CHG_N

9

VSS

8

EP

17

USB_5V

GND

GND

USB_5V

CHG_ILIM

CHG_ISET

BAT_NTC

NC

NC

VBAT

VBAT

VSYS

VSYS

PGOOD_N

CHG_N

GND

GND

R203
6.98k 1%
CHG_ISET | GND

R204
3.09k 1%
CHG_ILIM | GND

R205
47k 1%
+1V8 | PGOOD_N

R206
47k 1%
+1V8 | CHG_N

C201
4.7uF/16V
USB_5V | GND

C202
10uF/10V
VSYS | GND

C203
4.7uF/10V
VBAT | GND

J202
BATTERY_1x03

PACK+

1

PACK-

2

NTC10k

3

VBAT

GND

BAT_NTC

Battery: protected 1S Li-ion/LiPo, 4.2 V charge rating; nominal 3.7 V.

400 mAh is a planning assumption. Verify max charge current and cell dimensions.

Use a real 10k NTC in thermal contact with the cell; TS is not tied to GND.

Connector polarity and NTC B value must be checked against the selected pack.

USB-C is charge-only. USB data / SBU contacts are not routed in this revision.

I_CHG typ = 890 / 6980 = 127.5 mA (charger / resistor tolerance applies).

EN2=0, EN1=1: fixed 500 mA input mode; use a suitable USB 5 V supply.

ILIM resistor fitted as required even when fixed input mode is selected.

TMR and ITERM open: internal default timer / termination behavior.

VSYS ~ battery voltage on battery; up to 4.4 V with external input.

Protection IC is required in the purchased battery pack; not duplicated here.

# HealthWatch-SF58-Offline-v0.1 | 03 POWER RAILS

VSYS -> 1.8 V buck, 3.3 V buck-boost, switchable 5 V boost | validate startup and peak current

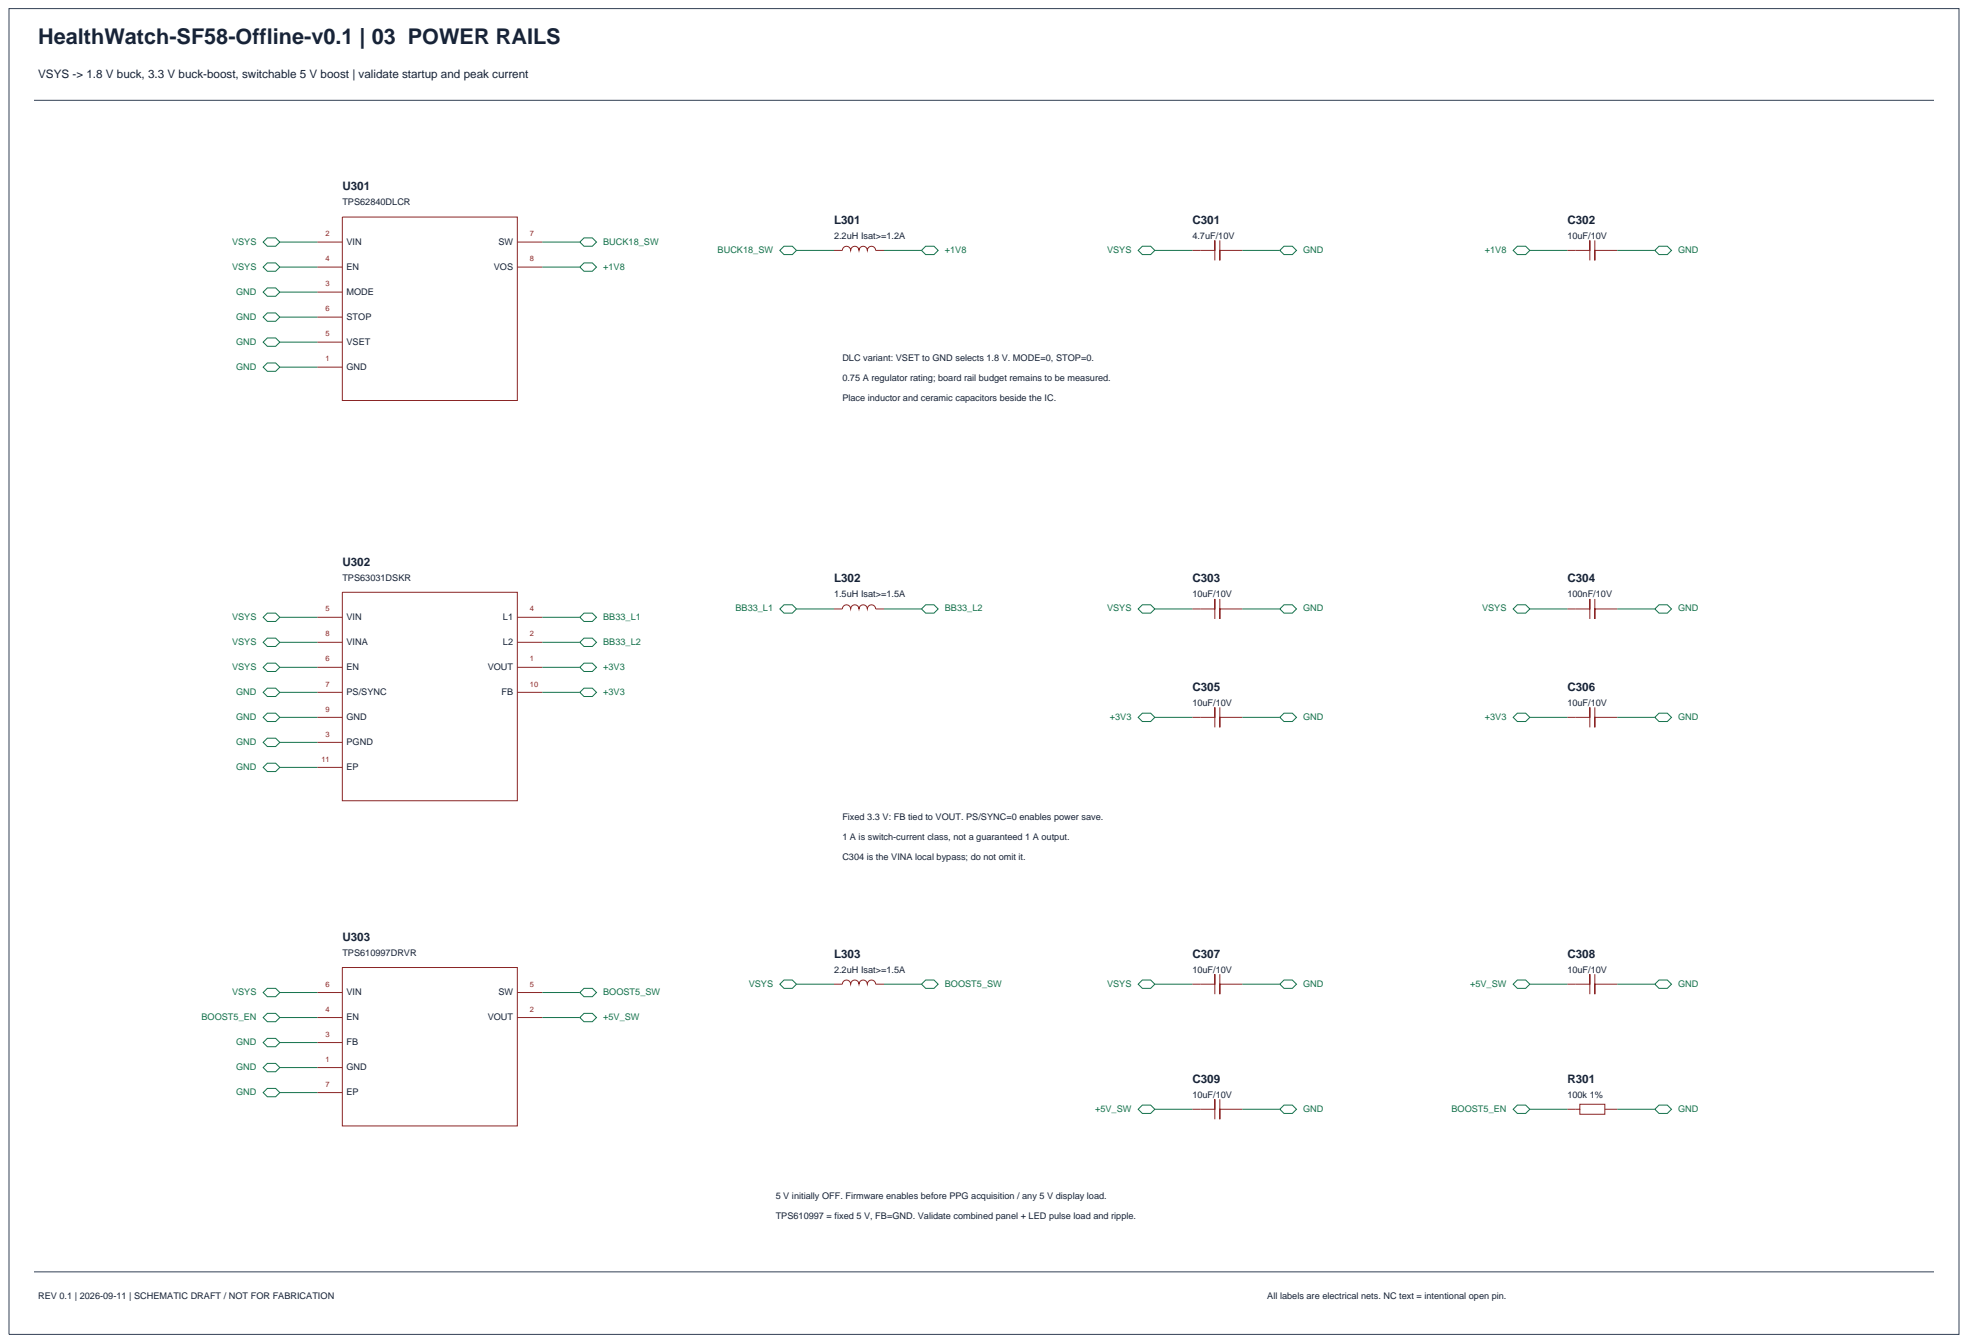
[picture p24: page 3]

DLC variant: VSET to GND selects 1.8 V. MODE=0, STOP=0.
0.75 A regulator rating; board rail budget remains to be measured.
Place inductor and ceramic capacitors beside the IC.

Fixed 3.3 V: FB tied to VOUT. PS/SYNC=0 enables power save.
1 A is switch-current class, not a guaranteed 1 A output.
C304 is the VINA local bypass; do not omit it.

5 V initially OFF. Firmware enables before PPG acquisition / any 5 V display load.
TPS610997 = fixed 5 V, FB=GND. Validate combined panel + LED pulse load and ripple.

# HealthWatch-SF58-Offline-v0.1 | 04 DISPLAY AND CONTROLS

390x450 QSPI AMOLED + I2C touch | connector matches required SiFli CONN2 signals; panel FPC is not guessed

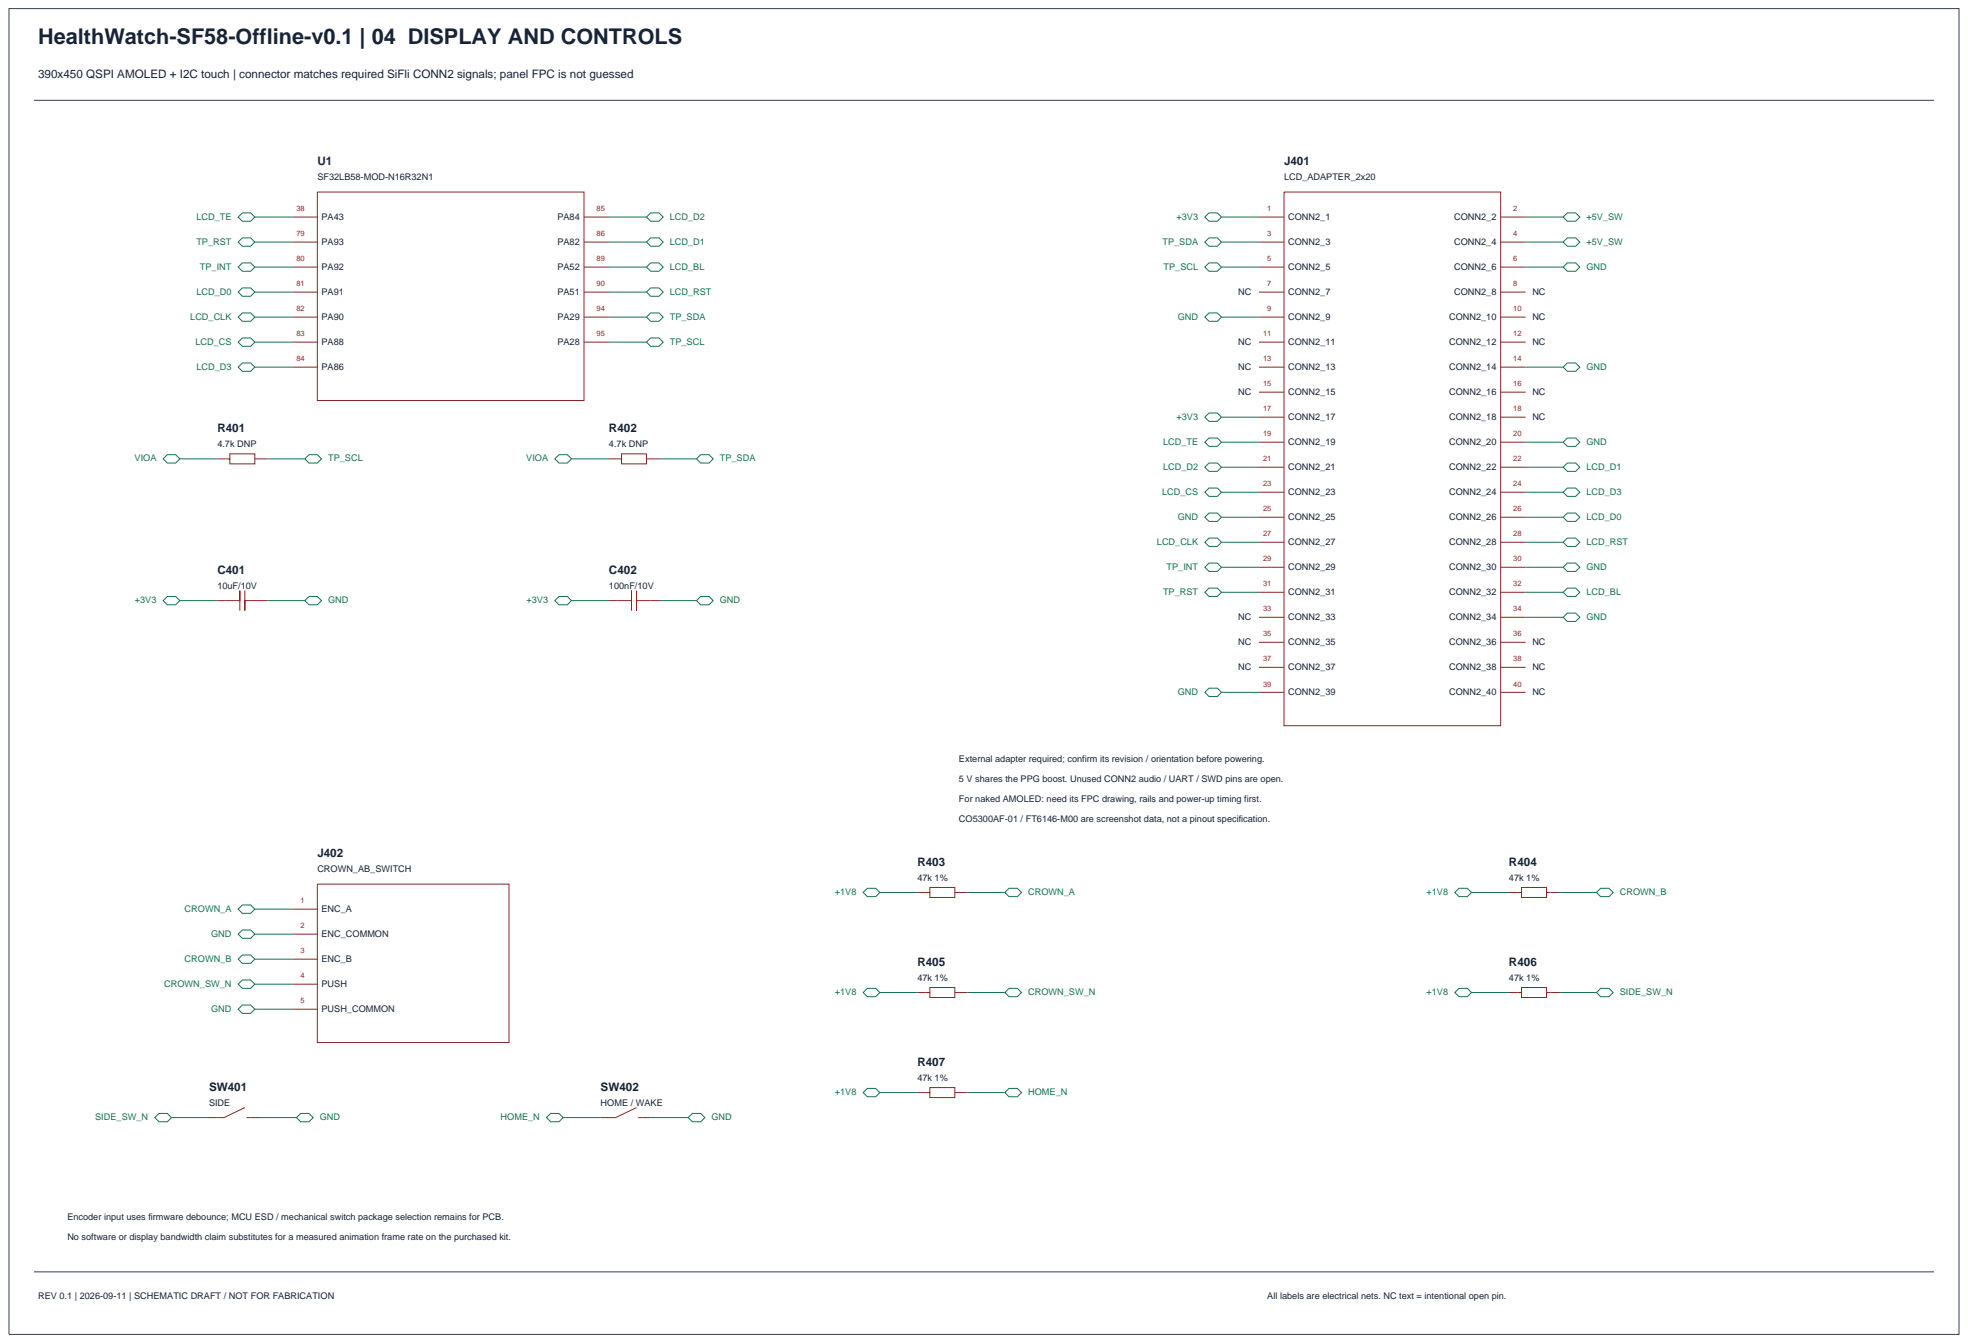
[picture p25: page 4]

External adapter required; confirm its revision / orientation before powering.
5 V shares the PPG boost. Unused CONN2 audio / UART / SWD pins are open.
For naked AMOLED: need its FPC drawing, rails and power-up timing first.
CO5300AF-01 / FT6146-M00 are screenshot data, not a pinout specification.

Encoder input uses firmware debounce; MCU ESD / mechanical switch package selection remains for PCB.
No software or display bandwidth claim substitutes for a measured animation frame rate on the purchased kit.

# HealthWatch-SF58-Offline-v0.1 | 05 IMU AND HAPTICS

LSM6DSO -> SF58 host -> MAXM86146 algorithm | 1.8 V sensor I2C bus | LRA with closed-loop driver

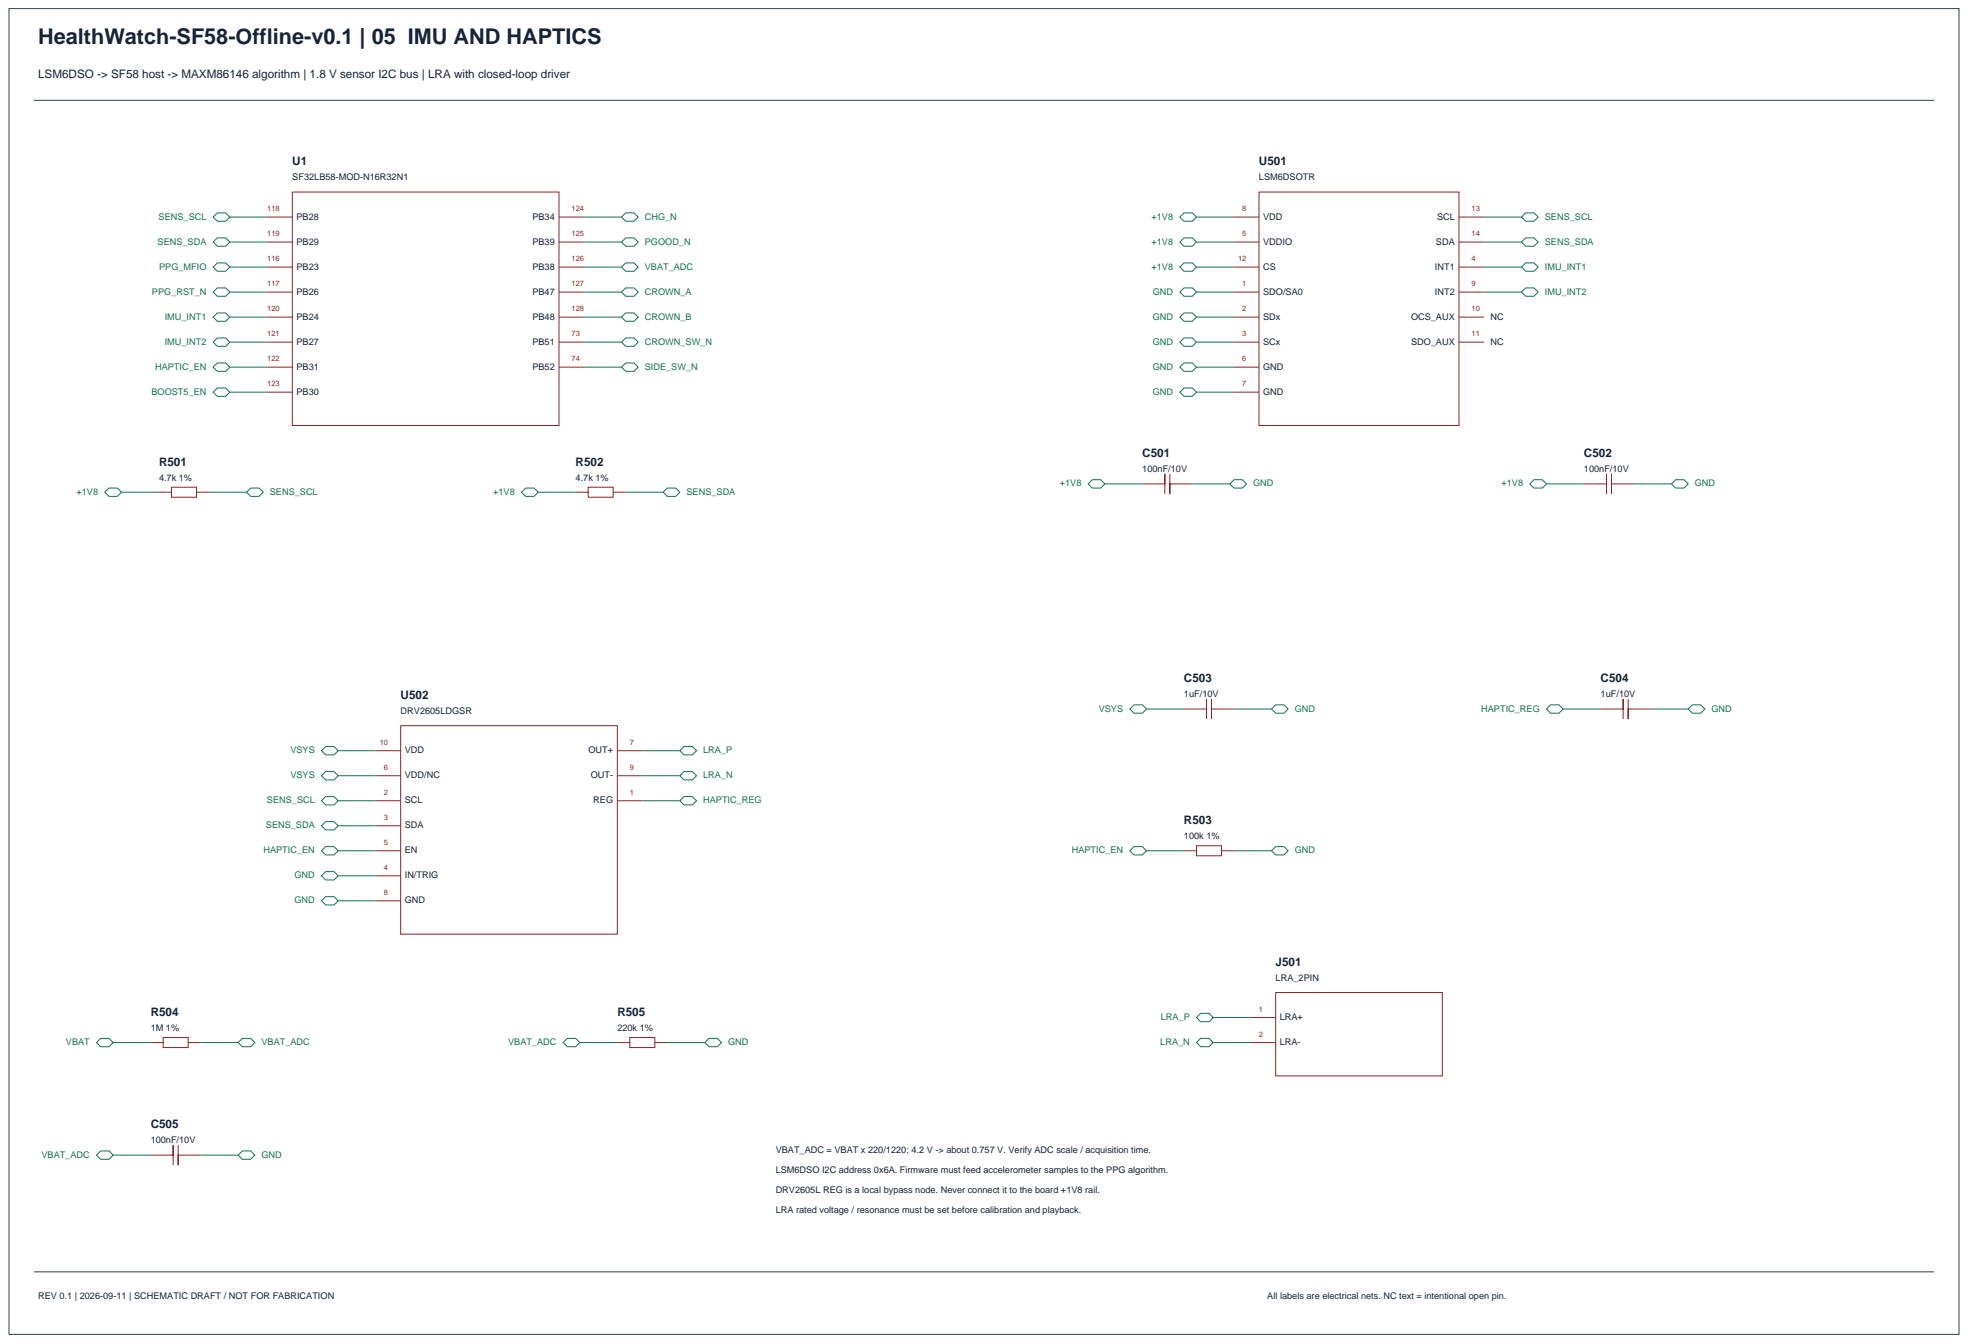
[picture p26: page 5]

LSM6DSO I2C address 0x6A. Firmware must feed accelerometer samples to the PPG algorithm.
DRV2605L REG is a local bypass node. Never connect it to the board +1V8 rail.
LRA rated voltage / resonance must be set before calibration and playback.

# HealthWatch-SF58-Offline-v0.1 | 06 PPG MODULE

MAXM86146CFU+ heart-rate / SpO2 front end | wrist optics and firmware algorithm still require validation

U601

MAXM86146CFU+; VDD; VDD_AFE; VLED; HOST_SCL; HOST_SDA; MFIO; RSTN; 32KIN; 32KOUT; VREF; VCORE; P0.3/PPG_INT; P0.0/ACCEL_CS; P0.2/ACCEL_INT; P0.6/SCK; P0.5/MOSI; P0.4/MISO; LED1_DRV; LED2_DRV; LED3_DRV; AFE_GPIO1; PD2_CAT; VSS; GND; SENS_SCL; SENS_SDA; PPG_MFIO; PPG_RST_N; PPG_XI; PPG_XO; PPG_VREF; PPG_VCORE; PPG_INT_LOCAL; LED_MUX_CB; PD2_LINK

C601
1uF/10V
+1V8 | GND

C602
10uF/10V
+1V8 | GND

C603
100nF/10V
+1V8 | GND

C604
1uF/10V
PPG_VREF | GND

C605
1uF/10V
PPG_VCORE | GND

C606
10uF/10V
+5V_SW | GND

C607
100nF/10V
+5V_SW | GND

R601
4.7k 1%
+1V8 | PPG_MFIO

R602
4.7k 1%
+1V8 | PPG_INT_LOCAL

R603
10R 1%
PPG_RST_SNUB | GND

C608
100nF/10V
PPG_RST_N | PPG_RST_SNUB

Y601
32.768kHz CL6pF
PPG_XI | PPG_XO

PD1 is integrated: pin 1 remains open. PD2 pin 25 must be joined to pin 26.

VCORE and VREF are capacitor-only nodes; do not drive with +1V8.

The unused accelerometer SPI pins stay unloaded in host-feed architecture.

PPG_INT_LOCAL is the local AFE interrupt; host communication uses MFIO.

Crystal load network follows the ADI reference; no guessed external load capacitors.

Host I2C / MFIO / reset all 1.8 V. I2C pull-ups are on sheet 05.

Hold PPG reset while required rails / clock stabilize, then follow ADI boot protocol.

C601 at VDD; C602+C603 at VDD_AFE; C606+C607 at VLED.

Common ground electrically; keep LED pulse returns away from optical/analog nodes.

This is a real sensing circuit; accuracy is not established by the schematic.

# HealthWatch-SF58-Offline-v0.1 | 07 OPTICAL EMITTERS

Two green LEDs + red / IR | MAX14689 switching network | LED polarity / optical footprint review required

U701
MAX14689EWL+T

VCC

C2

GND

B2

CB

A2

COM1

B1

COM2

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
+1V8

GND

LED_MUX_CB

LED2_DRV

LED3_DRV

RED_K

GREEN1_K

IR_K

GREEN2_K

D701
SFH7015

A_RED+IR

3
K_RED_655nm

2

K_IR_940nm

4
NC

1

+5V_SW | RED_K
NC | IR_K

R701
0R
LED1_DRV | GREEN1_K

D702
CT DBLP31.12-6C5D-56-J6U6

ANODE

A
CATHODE

K
+5V_SW | GREEN1_K

D703
CT DBLP31.12-6C5D-56-J6U6

ANODE

A
CATHODE

K
+5V_SW | GREEN2_K

R702
100k 1%
LED_MUX_CB | GND

C701
100nF/10V
+1V8 | GND

C702
22uF/10V
+5V_SW | GND

C703
22uF/10V
+5V_SW | GND

Current is regulated by MAXM86146 LED drivers. Set pulse current / timing before acquisition.

CB=0: LED2 -> RED, LED3 -> IR. CB=1: LED2 -> GREEN1, LED3 -> GREEN2.

GREEN1 cathode is also connected to LED1_DRV, following the ADI typical application.

Keep the GREEN1 shared path: three independent LEDs would change the reference design.

MAX14689 VCC=1.8 V; analog terminals support beyond-rail signals within its ratings.

Green symbols use A/K logical pads. Physical pad mapping is intentionally not invented.

Before PCB: audit emitter land patterns, optical separation, black barriers and skin contact geometry.

Heart rate / SpO2 algorithms, calibration, motion rejection and human testing remain required.

# HealthWatch-SF58-Offline-v0.1 | 08 MODULE UNUSED PADS

Complete module inventory | offline phase: MIPI, USB data, RF, audio and spare GPIO remain unconnected

U1
SF32LB58-MOD-N16R32N1

PA75

5

PA76

6

PA77

7

PA70

8

PA81

9

PA79

10

PA13

17

PA15

18

PA14

19

PA12

20

PA67

21

PA65

22

PA63

23

PA62

24

PA61

25

PA58

26

PA57

27

PA56

28

PA55

29

PA54

30

PA53

31

PA50

32

PA48

33

PA47

34

PA46

35

PA45

36

PA44

37

PA27

39

PA26

40

PA25

41

PA24

42

PA23

43

PA22

44

DSI_D0N

47

DSI_D0P

48

DSI_CLKN

49

DSI_CLKP

50

DSI_D1N

51

DSI_D1P

52

PA32

53

PA31

54

USB_DN

55

USB_DP

56

PA17

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
SF32LB58-MOD-N16R32N1

PA16

58

PA00

59

PA03

60

PB17

61

PB18

62

DAC1N

66

DAC1P

67

MIC_BIAS

68

ADC1N

69

ADC1P

70

BT_ANT

72

PB56

75

PB57

76

PB58

77

PB59

78

PA60

87

PA59

88

PA42

91

PA20

92

PA21

93

PA18

96

PA02

97

PA11

98

PA08

99

PA07

100

PA10

101

PA09

102

PA06

103

PA04

104

PA05

105

PA01

106

PB10

107

PB09

108

PB08

109

PB06

110

PB04

111

PB03

112

PB02

113

UNVERIFIED_UNUSED

114

UNVERIFIED_UNUSED

115

DAC2N

129

DAC2P

130

ADC2N

131

ADC2P

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
U1 units A-E are the same physical SF32LB58 module. Shared designator and unique ID preserve one BOM item.

All pads marked NC on this sheet are deliberately not routed in v0.1. This is not an omission of power pins.

114 / 115 are shown as UNVERIFIED_UNUSED; confirm names using the module pad drawing before future reuse.

The imported module footprint comes from the SiFli native EDA reference project.

Other IC and mechanical footprints are unbound for deliberate review before PCB layout.

No PCB outline, RF antenna, audio chain, network radio enablement or production release is included.

Next gate: verify imported electrical nets, complete footprint audit, confirm panel adapter and battery pack.
