zhangguotao05-zgt/iwatch/(list of files, drawings)

Other design files:
hardware/4mm磁吸母头封装/4mm磁吸母头_嘉立创专业版_封装草稿.epro
hardware/SJ056_N极母座封装/SJ056_N极母座_嘉立创专业版_封装草稿.epro
hardware/原理图_v0.1/HealthWatch-SF58-Offline-v0.1.epro
hardware/原理图_v0.2_裸芯片/HealthWatch-SF58-BareChip-v0.2.epro
hardware/原理图_v0.3_封装与接口完善/HealthWatch-SF58-BareChip-v0.3.epro
