zhangguotao05-zgt/iwatch/firmware/iwatch/src/gui_apps/watch_demo.c

/*
 * SPDX-FileCopyrightText: 2019-2026 SiFli Technologies(Nanjing) Co., Ltd
 *
 * SPDX-License-Identifier: Apache-2.0
 */
/*********************
 *      INCLUDES
 *********************/
#include "littlevgl2rtt.h"
// #include "lv_ext_resource_manager.h"
#include <rtdevice.h>
#ifndef _WIN32
    #include "drv_lcd.h"
#endif
#include "gui_app_fwk.h"
#include "lv_ex_data.h"
#include "app_mem.h"
#include "log.h"
#include "lv_freetype.h"
#include "lvsf.h"
#include "iw_key_port.h"
#include "iw_key_feedback.h"
#include "iw_display_guard.h"
#include "iw_gui_port.h"
#include "iw_touch.h"
#include "iw_touch_input.h"
#include "iw_recovery.h"
#include "iw_font.h"
#include "iw_gui_owner.h"
#include "iw_router.h"
#include "iw_product_controller.h"
#include "iw_routes.h"
#include "iw_render_probe.h"
#include "iw_font_port.h"
#include "cpu_usage_profiler.h"
#include "iw_components.h"
#include "iw_components_demo.h"
#include "iw_boot.h"
#include "iw_service_runtime.h"
#include "clock/app_clock_status_bar.h"
#include <string.h>
#ifdef BSP_USING_PM
    #include "bf0_pm.h"
    #include "gui_app_pm.h"
    #include "drv_gpio.h"
#endif /* BSP_USING_PM */

#define APP_WATCH_GUI_TASK_STACK_SIZE 16*1024

#define SLEEP_CTRL_PIN   (BSP_KEY1_PIN)
#define LCD_DEVICE_NAME  "lcd"
#define IDLE_TIME_LIMIT  (10000)
#define DISPLAY_WAKE_MIN_MS (250u)
#define DISPLAY_APPLY_WARN_MS (250u)
#define FONT_SAMPLE_PERIOD_MS (250u)

extern const unsigned char DroidSansFallback[];
extern const int DroidSansFallback_size;
extern const unsigned char IWV00Noto300[], IWV00Noto400[], IWV00Noto500[], IWV00Noto600[];
extern const int IWV00Noto300_size, IWV00Noto400_size, IWV00Noto500_size, IWV00Noto600_size;

typedef enum
{
    BTN_EVT_SHUTDOWN = 0x01,
    BTN_EVT_UI_CLOSE = 0x02,
    BTN_EVT_UI_OPEN  = 0x04,
    BTN_EVT_ALL = BTN_EVT_SHUTDOWN | BTN_EVT_UI_CLOSE | BTN_EVT_UI_OPEN,
} btn_evt_type_t;


static struct rt_thread watch_thread;

ALIGN(RT_ALIGN_SIZE)
static uint8_t watch_thread_stack[APP_WATCH_GUI_TASK_STACK_SIZE];
static rt_device_t lcd_device;
static iw_display_wake_gate_t display_wake_gate;
static uint32_t display_reassert_count;
static uint32_t display_recovery_count;
static uint8_t display_fault_pending;

static lv_timer_t *button_event_task;
static struct rt_event btn_event;
static lv_obj_t *mbox;

/*Compatible with private lib*/
uint32_t g_mainmenu[2];

extern void ui_datac_init(void);

static void count_saturating_add(uint32_t *value)
{
    if (*value != UINT32_MAX) (*value)++;
}

static bool display_target_read(uint8_t *level, uint32_t *revision, uint32_t *sequence)
{
    iw_brightness_snapshot_t snapshot;

    if (!level || !revision || !sequence || !iw_brightness_read(&snapshot) ||
            !(snapshot.flags & IW_BRIGHTNESS_FLAG_DESIRED_VALID))
        return false;
    *level = snapshot.desired;
    *revision = snapshot.desired_revision;
    *sequence = snapshot.setting_sequence;
    return true;
}

#ifndef _WIN32
static bool lcd_driver_read_state(void *context, iw_display_driver_state_t *state)
{
    LCD_DrvStatusTypeDef lcd_state = LCD_STATUS_NONE;
    rt_err_t result;

    if (!context || !state) return false;
    result = rt_device_control((rt_device_t)context, RTGRAPHIC_CTRL_GET_STATE, &lcd_state);
    if (result != RT_EOK) return false;
    switch (lcd_state)
    {
    case LCD_STATUS_INITIALIZED:
    case LCD_STATUS_DISPLAY_ON:
    case LCD_STATUS_DISPLAY_OFF:
    case LCD_STATUS_IDLE_MODE:
        *state = IW_DISPLAY_DRIVER_STATE_READY;
        return true;
    case LCD_STATUS_OPENING:
    case LCD_STATUS_DISPLAY_OFF_PENDING:
        *state = IW_DISPLAY_DRIVER_STATE_BUSY;
        return true;
    case LCD_STATUS_DISPLAY_TIMEOUT:
        *state = IW_DISPLAY_DRIVER_STATE_TIMEOUT;
        return true;
    case LCD_STATUS_NONE:
    case LCD_STATUS_NOT_FIND_LCD:
        *state = IW_DISPLAY_DRIVER_STATE_UNAVAILABLE;
        return true;
    default:
        *state = IW_DISPLAY_DRIVER_STATE_UNKNOWN;
        return false;
    }
}

static bool lcd_driver_read_busy(void *context, bool *busy)
{
    bool value = true;
    rt_err_t result;

    if (!context || !busy) return false;
    result = rt_device_control((rt_device_t)context, RTGRAPHIC_CTRL_GET_BUSY, &value);
    if (result != RT_EOK) return false;
    *busy = value;
    return true;
}

static iw_display_apply_status_t lcd_driver_write_brightness(void *context,
                                                             uint8_t level,
                                                             int32_t *device_error)
{
    rt_err_t result;

    if (!context || !device_error) return IW_DISPLAY_APPLY_FAILED;
    result = rt_device_control((rt_device_t)context, RTGRAPHIC_CTRL_SET_BRIGHTNESS, &level);
    *device_error = (int32_t)result;
    if (result == RT_EOK) return IW_DISPLAY_APPLY_OK;
    if (result == -RT_EBUSY || result == RT_EBUSY) return IW_DISPLAY_APPLY_BUSY;
    if (result == -RT_ETIMEOUT || result == RT_ETIMEOUT) return IW_DISPLAY_APPLY_TIMEOUT;
    return IW_DISPLAY_APPLY_FAILED;
}

static bool lcd_driver_read_brightness(void *context, uint8_t *level)
{
    uint8_t value = UINT8_MAX;
    rt_err_t result;

    if (!context || !level) return false;
    result = rt_device_control((rt_device_t)context, RTGRAPHIC_CTRL_GET_BRIGHTNESS, &value);
    if (result != RT_EOK || value > IW_BRIGHTNESS_MAX) return false;
    *level = value;
    return true;
}
#endif

/* 此函数只允许在 GUI owner 中调用，避免与 SDK 的 LCD 串行状态并发。 */
static iw_display_apply_status_t display_apply_brightness(uint8_t level, int32_t *device_error)
{
#ifndef _WIN32
    iw_display_driver_ops_t ops;
    uint32_t started;
    uint32_t elapsed;
    iw_display_apply_status_t status;

    if (!device_error) return IW_DISPLAY_APPLY_FAILED;
    if (!lcd_device)
    {
        *device_error = -RT_ENOSYS;
        return IW_DISPLAY_APPLY_FAILED;
    }
    ops.context = lcd_device;
    ops.read_state = lcd_driver_read_state;
    ops.read_busy = lcd_driver_read_busy;
    ops.write_brightness = lcd_driver_write_brightness;
    ops.read_brightness = lcd_driver_read_brightness;
    started = (uint32_t)rt_tick_get();
    status = iw_display_apply_verified(&ops, level, device_error);
    elapsed = (uint32_t)((uint32_t)rt_tick_get() - started);
    if (elapsed > (uint32_t)rt_tick_from_millisecond(DISPLAY_APPLY_WARN_MS))
        LOG_W("LCD brightness apply is slow: %u ticks", (unsigned)elapsed);
    return status;
#else
    (void)level;
    if (device_error) *device_error = -RT_ENOSYS;
    return IW_DISPLAY_APPLY_FAILED;
#endif
}

/* 只注入下一条 mailbox 请求，避免影响触摸唤醒和恢复路径。 */
static bool display_take_fault_once(iw_display_apply_status_t *status, int32_t *device_error)
{
#ifndef _WIN32
    uint8_t fault;
    rt_base_t level;

    if (!status || !device_error) return false;
    level = rt_hw_interrupt_disable();
    fault = display_fault_pending;
    display_fault_pending = 0u;
    rt_hw_interrupt_enable(level);
    if (fault == 1u)
    {
        *status = IW_DISPLAY_APPLY_BUSY;
        *device_error = -RT_EBUSY;
        return true;
    }
    if (fault == 2u)
    {
        *status = IW_DISPLAY_APPLY_TIMEOUT;
        *device_error = -RT_ETIMEOUT;
        return true;
    }
    if (fault == 3u)
    {
        *status = IW_DISPLAY_APPLY_FAILED;
        *device_error = -RT_EIO;
        return true;
    }
#else
    (void)status;
    (void)device_error;
#endif
    return false;
}

static bool display_apply_current_target(void)
{
    uint8_t level;
    uint32_t revision;
    uint32_t sequence;
    int32_t device_error = 0;
    iw_display_apply_status_t status;

    if (!display_target_read(&level, &revision, &sequence)) return false;
    status = display_apply_brightness(level, &device_error);
    (void)iw_display_note_current_apply(level, revision, sequence, status, device_error);
    return status == IW_DISPLAY_APPLY_OK;
}

static void display_process_pending(void)
{
    iw_display_request_t request;
    iw_display_take_status_t take = iw_display_take_request(&request);

    if (take == IW_DISPLAY_TAKE_READY)
    {
        int32_t device_error = 0;
        iw_display_apply_status_t status;

        if (!display_take_fault_once(&status, &device_error))
            status = display_apply_brightness(request.level, &device_error);

        if (!iw_display_complete_request(&request, status, device_error))
            LOG_E("LCD brightness completion rejected: request=%u seq=%u",
                  (unsigned)request.token.request_id, (unsigned)request.setting_sequence);
    }
}

static int iw_display_fault_once(int argc, char **argv)
{
#ifndef _WIN32
    uint8_t fault;
    rt_base_t level;

    if (argc != 2)
    {
        rt_kprintf("usage: iw_display_fault_once <busy|timeout|failed>\n");
        return -RT_EINVAL;
    }
    if (strcmp(argv[1], "busy") == 0)
        fault = 1u;
    else if (strcmp(argv[1], "timeout") == 0)
        fault = 2u;
    else if (strcmp(argv[1], "failed") == 0)
        fault = 3u;
    else
        return -RT_EINVAL;

    level = rt_hw_interrupt_disable();
    display_fault_pending = fault;
    rt_hw_interrupt_enable(level);
    rt_kprintf("display next mailbox fault=%u\n", (unsigned)fault);
    return RT_EOK;
#else
    (void)argc;
    (void)argv;
    return -1;
#endif
}
MSH_CMD_EXPORT(iw_display_fault_once, Inject one bounded display mailbox failure);

/* CO5300 偶发保持黑屏时，重发当前目标亮度即可恢复，无需重建 GUI。 */
static void display_reassert(void)
{
#ifndef _WIN32
    uint32_t now;
    uint32_t minimum_ticks;

    if (!lcd_device) return;
    now = (uint32_t)rt_tick_get();
    minimum_ticks = (uint32_t)rt_tick_from_millisecond(DISPLAY_WAKE_MIN_MS);
    if (!iw_display_wake_gate_take(&display_wake_gate, now, minimum_ticks)) return;
    if (display_apply_current_target())
        count_saturating_add(&display_reassert_count);
#endif
}

static void display_pointer_event_cb(lv_event_t *event)
{
    if (LV_EVENT_PRESSED == lv_event_get_code(event)) display_reassert();
}

static void display_register_pointer_wake(void)
{
    for (lv_indev_t *indev = lv_indev_get_next(NULL); indev; indev = lv_indev_get_next(indev))
    {
        if (LV_INDEV_TYPE_POINTER == lv_indev_get_type(indev))
            lv_indev_add_event_cb(indev, display_pointer_event_cb, LV_EVENT_PRESSED, NULL);
    }
}

/* 绘制超时后重新探测面板，并让下一轮 LVGL 刷新完整画面。 */
static void display_recover_if_faulted(void)
{
#ifndef _WIN32
    uint8_t draw_error = 0;
    rt_err_t power_result;

    if (!lcd_device || RT_EOK != rt_device_control(lcd_device, SF_GRAPHIC_CTRL_GET_DRAW_ERR, &draw_error) ||
            !draw_error)
        return;

    count_saturating_add(&display_recovery_count);
    LOG_E("LCD draw failed; recovery attempt %u", (unsigned)display_recovery_count);
    power_result = rt_device_control(lcd_device, RTGRAPHIC_CTRL_POWEROFF, NULL);
    if (power_result == RT_EOK)
        power_result = rt_device_control(lcd_device, RTGRAPHIC_CTRL_POWERON, NULL);
    if (power_result == RT_EOK)
        (void)display_apply_current_target();
    else
    {
        uint8_t level;
        uint32_t revision;
        uint32_t sequence;
        if (display_target_read(&level, &revision, &sequence))
            (void)iw_display_note_current_apply(level, revision, sequence,
                                                IW_DISPLAY_APPLY_FAILED,
                                                (int32_t)power_result);
    }
    lv_obj_invalidate(lv_scr_act());
    lv_disp_trig_activity(NULL);
#endif
}

static void iw_display_stat(void)
{
    rt_kprintf("display reassert=%u recovery=%u fault_pending=%u\n",
               (unsigned)display_reassert_count, (unsigned)display_recovery_count,
               (unsigned)display_fault_pending);
}
MSH_CMD_EXPORT(iw_display_stat, Show LCD wake and recovery statistics);

/**
 * return to MAIN_APP or CLOCK_APP
 * \n
 *
 * @param event
 * @return
 * @param key
 * \n
 * @see
 */
static int32_t default_keypad_handler(lv_key_t key, lv_indev_state_t event)
{
    static lv_indev_state_t last_event = LV_INDEV_STATE_REL;//LV_INDEV_STATE_REL == 0，LV_INDEV_STATE_PRESSED == 1
    // rt_kprintf("default_keypad_handler %d,%d,%d\n", key, event,LV_INDEV_STATE_REL);
    if (last_event != event) //Not execute repeatly.
    {
        last_event = event;

        if ((LV_INDEV_STATE_PR == event) && (LV_KEY_HOME == key))
        {
            iw_gui_fault_dismiss();
            if (iw_components_demo_home()) return LV_BLOCK_EVENT;
            (void)iw_router_home();
        }
        else if ((LV_INDEV_STATE_PR == event) && (LV_KEY_ESC == key))
        {
            gui_app_goback();
        }
    }

    return LV_BLOCK_EVENT;
}

#ifdef USING_BUTTON_LIB
static void input_service(void);
#else
#define input_service()
#endif

/* 页面开关与故障处理优先排空在途绘制，禁止边等待空闲边提交下一帧。 */
static uint32_t gui_process_frame(void)
{
    if (app_clock_main_process_font_fault() || iw_components_demo_process()) return 1u;
    if (iw_router_process()) return 1u;
    /* 页面切换刚提出的取消必须在新页面读取触摸之前兑现。 */
    input_service();
    bool probe_enabled = iw_render_probe_active();
    uint32_t probe_start_us = cpu_get_hw_us();
    iw_render_probe_begin(lv_tick_get(), iw_font_port_render_idle());
    uint32_t probe_begin_us = cpu_get_hw_us();
    uint32_t wait_ms = lv_timer_handler();
    iw_render_probe_end(lv_tick_get(), iw_font_port_render_idle());
    uint32_t probe_end_us = cpu_get_hw_us();
    iw_render_probe_note_overhead(probe_enabled, (probe_begin_us - probe_start_us) + (probe_end_us - probe_begin_us));
    /* 输入回调可能刚投递关闭请求，绘制返回后再次检查。 */
    if (app_clock_main_process_font_fault() || iw_components_demo_process()) return 1u;
    if (iw_router_process()) return 1u;
    if (iw_components_tick() && wait_ms > 16u) wait_ms = 16u;
    if (wait_ms > iw_router_wait_ms()) wait_ms = iw_router_wait_ms();
    return wait_ms;
}


#ifdef USING_BUTTON_LIB

/* 取消只在 GUI 安全点执行，先复位输入，再改变后续读取权限。 */
static void input_cancel_lvgl(void)
{
    iw_key_feedback_cancel();
    iw_input_context_t context = iw_key_port_context();
    bool allow_touch = context != IW_INPUT_WATER && context != IW_INPUT_LOCKED;
#ifndef _WIN32
    iw_touch_input_set_enabled(allow_touch);
#endif
    for (lv_indev_t *indev = lv_indev_get_next(NULL); indev; indev = lv_indev_get_next(indev)) {
        lv_indev_reset(indev, NULL);
        if (lv_indev_get_type(indev) == LV_INDEV_TYPE_POINTER) {
            lv_indev_wait_release(indev);
            lv_indev_enable(indev, allow_touch);
        }
        lv_timer_t *timer = lv_indev_get_read_timer(indev);
        if (timer) lv_timer_ready(timer);
    }
#ifndef _WIN32
    iw_touch_cancel();
#endif
}

static bool input_touch_down(void)
{
#ifndef _WIN32
    iw_touch_stats_t stats;
    return !iw_touch_stats_get(&stats) || stats.physical_down || stats.queued || stats.cancel_pending || stats.wait_release;
#else
    return false;
#endif
}

static void input_feedback(unsigned key, bool pressed)
{
    iw_key_feedback_set(key, pressed);
    if (pressed) {
        display_reassert();
        lv_disp_trig_activity(NULL);
    }
}

static bool input_signal(iw_key_signal_t signal)
{
    if (iw_gui_fault_pending()) return false;
    iw_input_context_t context = iw_key_port_context();
    if (iw_recovery_visible()) context = IW_INPUT_RECOVERY;
    else if (context < IW_INPUT_OVERLAY && iw_components_demo_active()) context = IW_INPUT_OVERLAY;
    else if (context < IW_INPUT_ALERT && iw_router_alert_visible()) context = IW_INPUT_ALERT;
    else if (context < IW_INPUT_OVERLAY && iw_router_overlay_visible()) context = IW_INPUT_OVERLAY;
    iw_input_intent_t intent = iw_keys_intent(signal, context);
    rt_kprintf("key intent=%u context=%u\n", (unsigned)intent, (unsigned)context);
    switch (intent) {
    case IW_INTENT_HOME: return iw_router_home();
    case IW_INTENT_CONTROL: return iw_router_open(IW_PAGE_CONTROL_CENTER);
    case IW_INTENT_SWITCHER: return iw_router_open(IW_PAGE_SWITCHER);
    case IW_INTENT_DISMISS:
        if (context == IW_INPUT_OVERLAY && iw_components_demo_active()) return iw_components_demo_home();
        if (context == IW_INPUT_ALERT) return iw_router_back();
        if (context == IW_INPUT_OVERLAY) return iw_router_home();
        break;
    case IW_INTENT_RECOVER:
        iw_gui_fault_dismiss();
        (void)iw_key_port_apply_context(IW_INPUT_NORMAL);
        return iw_router_recover();
    case IW_INTENT_UNLOCK:
        /* 锁页是覆盖层模态页，解锁后关闭整条覆盖链并回到进入前来源。 */
        return iw_router_unlock();
    case IW_INTENT_NONE: return false;
    default: break;
    }
    rt_kprintf("key intent=%u unavailable\n", (unsigned)intent);
    return false;
}

static void input_rotate(int32_t steps)
{
    if (iw_gui_fault_pending() || iw_recovery_visible() || iw_components_demo_active() || !iw_router_rotate(steps))
        rt_kprintf("key rotation unavailable steps=%ld\n", (long)steps);
}

static void input_service(void)
{
    static gui_app_route_snapshot_t previous;
    static bool sampled;
#ifndef _WIN32
    if (iw_touch_input_service() && iw_key_port_context() != IW_INPUT_WATER &&
        iw_key_port_context() != IW_INPUT_LOCKED) iw_key_port_cancel();
#endif
    gui_app_route_snapshot_t current;
    (void)gui_app_get_route_snapshot(&current);
    /* 兼容旧页面：框架切页或开始动画后，不把上页未决手势带入新页。 */
    if (sampled && (strcmp(previous.app_id, current.app_id) || strcmp(previous.page_id, current.page_id) ||
        previous.user_data != current.user_data || (!previous.busy && current.busy))) iw_key_port_cancel();
    previous = current;
    sampled = true;
    iw_key_port_process();
    iw_product_set_lock_progress(iw_key_port_unlock_progress());
}

void button_key_read(uint32_t *last_key, lv_indev_state_t *state)
{
    if (!last_key || !state) return;
    /* 保留 SDK 接口；实体键由语义仲裁直接处理，不再伪造 LVGL Home。 */
    *last_key = 2;
    *state = LV_INDEV_STATE_REL;
}

static void init_pin(void)
{
    const iw_key_port_ops_t ops = {input_feedback, input_signal, input_rotate, input_cancel_lvgl, input_touch_down};
    if (!iw_key_port_init(&ops)) LOG_E("Physical keys unavailable; touch and software diagnostics remain active");
}
#define input_wait(ms) iw_key_port_wait_ms(ms)
#else
#define init_pin()
#define input_wait(ms) (ms)
#endif /* USING_BUTTON_LIB */

#ifdef BSP_USING_PM
static void opa_anim(void *bg, int32_t v)
{
    lv_obj_set_style_bg_opa(bg, (lv_opa_t)v, LV_PART_MAIN | LV_STATE_DEFAULT);
}

static void mbox_event_cb(lv_event_t *event)
{
    lv_obj_t *mbox = lv_event_get_user_data(event);
    uint16_t btn_idx = lv_msgbox_get_active_btn(mbox);

    LOG_I("mbox_event VALUE_CHANGED: %d", btn_idx);
    if (0 == btn_idx)
    {
        rt_device_control(lcd_device, RTGRAPHIC_CTRL_POWEROFF, NULL);
        pm_shutdown();
    }
    else
    {
        /* Delete the parent modal background */
        lv_obj_del_async(lv_obj_get_parent(mbox));
        //Restore HOME key
        keypad_default_handler_register(default_keypad_handler);
    }
}

static void show_shutdown_msgbox(void)
{
    /* Create a base object for the modal background */
    lv_obj_t *obj = lv_obj_create(lv_scr_act());
    lv_obj_set_style_bg_color(obj, LV_COLOR_BLACK, LV_PART_MAIN | LV_STATE_DEFAULT);
    lv_obj_set_pos(obj, 0, 0);
    lv_obj_set_size(obj, LV_HOR_RES, LV_VER_RES);

    static const char *btns2[] = {"Ok", "Cancel", ""};

    /* Create the message box as a child of the modal background */
    lv_obj_t *mbox = lv_msgbox_create(obj, "Shutdown",
                                      "Are you sure to shutdown?", btns2, false);
    lv_obj_align(mbox, LV_ALIGN_CENTER, 0, 0);
    lv_obj_add_event_cb(mbox, mbox_event_cb, LV_EVENT_VALUE_CHANGED, mbox);

    /* Fade the message box in with an animation */
    lv_anim_t a;
    lv_anim_init(&a);
    lv_anim_set_var(&a, obj);
    lv_anim_set_time(&a, 500);
    lv_anim_set_values(&a, LV_OPA_TRANSP, LV_OPA_50);
    lv_anim_set_exec_cb(&a, (lv_anim_exec_xcb_t)opa_anim);
    lv_anim_start(&a);

    //Disable HOME key
    keypad_default_handler_register(NULL);
    //lv_label_set_text(info, in_msg_info);
    //lv_obj_align(info, NULL, LV_ALIGN_IN_BOTTOM_LEFT, 5, -5);
}

static void button_event_task_entry(struct _lv_timer_t *task)
{
    rt_uint32_t evt;
    rt_err_t err;

    if (lv_disp_get_inactive_time(NULL) > IDLE_TIME_LIMIT)
    {
        gui_pm_fsm(GUI_PM_ACTION_SLEEP);
    }

    err = rt_event_recv(&btn_event, BTN_EVT_ALL, RT_EVENT_FLAG_OR | RT_EVENT_FLAG_CLEAR, RT_WAITING_NO, &evt);

    if (RT_EOK != err)
    {
        return;
    }

    if (evt & BTN_EVT_SHUTDOWN)
    {
        lv_disp_trig_activity(NULL);
        show_shutdown_msgbox();
    }
}

static void pm_event_handler(gui_pm_event_type_t event)
{
    switch (event)
    {
    case GUI_PM_EVT_SUSPEND:
    {
        lv_timer_enable(false);
        break;
    }
    case GUI_PM_EVT_RESUME:
    {
        lv_timer_enable(true);
        break;
    }
    case GUI_PM_EVT_SHUTDOWN:
    {
        //TODO: start power down procedure
        RT_ASSERT(RT_EOK == rt_event_send(&btn_event, BTN_EVT_SHUTDOWN));
        break;
    }
    default:
    {
        RT_ASSERT(0);
    }
    }
}
#else
#define rt_pm_request(mode)
#define rt_pm_release(mode)
#endif /* BSP_USING_PM */

#ifdef BSP_USING_DFU
#include "bf0_ble_dfu.h"

static void dfu_btn_event_cb(lv_obj_t *obj, lv_event_t evt)
{
    if ((evt == LV_EVENT_DELETE) && (obj == mbox))
    {
        /* Delete the parent modal background */
        lv_obj_del_async(lv_obj_get_parent(mbox));
        mbox = NULL; /* happens before object is actually deleted! */
        //lv_label_set_text(info, welcome_info);
    }
    else if (evt == LV_EVENT_VALUE_CHANGED)
    {
        uint16_t btn_idx = lv_msgbox_get_active_btn(obj);
        if (0 == btn_idx)
        {
            rt_device_control(lcd_device, RTGRAPHIC_CTRL_POWEROFF, NULL);
            rt_hw_cpu_reset();
        }
        else
        {
            /* A button was clicked */
            lv_msgbox_start_auto_close(mbox, 0);
        }
    }
}

static void opa_anim(void *bg, lv_anim_value_t v)
{
    lv_obj_set_style_local_bg_opa(bg, LV_OBJ_PART_MAIN, LV_STATE_DEFAULT, v);
}


static void show_dfu_reboot_msgbox(void)
{
    /* Create a base object for the modal background */
    lv_obj_t *obj = lv_obj_create(lv_scr_act(), NULL);
    _lv_obj_set_style_local_color(obj, LV_OBJ_PART_MAIN, LV_STYLE_BG_COLOR, LV_COLOR_BLACK);
    lv_obj_set_pos(obj, 0, 0);
    lv_obj_set_size(obj, LV_HOR_RES, LV_VER_RES);

    static const char *btns2[] = {"Ok", "Cancel", ""};

    /* Create the message box as a child of the modal background */
    mbox = lv_msgbox_create(obj, NULL);
    lv_msgbox_add_btns(mbox, btns2);
    lv_msgbox_set_text(mbox, "Upgrade firmware is ready! Do you want to update?");
    lv_obj_align(mbox, NULL, LV_ALIGN_CENTER, 0, 0);
    lv_obj_set_event_cb(mbox, dfu_btn_event_cb);

    /* Fade the message box in with an animation */
    lv_anim_t a;
    lv_anim_init(&a);
    lv_anim_set_var(&a, obj);
    lv_anim_set_time(&a, 500);
    lv_anim_set_values(&a, LV_OPA_TRANSP, LV_OPA_50);
    lv_anim_set_exec_cb(&a, (lv_anim_exec_xcb_t)opa_anim);
    lv_anim_start(&a);

    //lv_label_set_text(info, in_msg_info);
    //lv_obj_align(info, NULL, LV_ALIGN_IN_BOTTOM_LEFT, 5, -5);
}



uint8_t app_dfu_callback(uint16_t event, void *param)
{
    uint8_t ret = BLE_DFU_EVENT_SUCCESSED;
    switch (event)
    {
    case BLE_DFU_END:
    {
        ble_dfu_end_t *ret = (ble_dfu_end_t *)param;
        LOG_I("app dfu reset start %d", ret->result);
        if (ret->result == 0)
            show_dfu_reboot_msgbox();
        break;
    }
    default:
        break;
    }


    return ret;
}
#else
#define ble_dfu_register(cbk)
#endif

void app_watch_entry(void *parameter)
{
    uint8_t first_loop = 1;
#ifdef _MSC_VER
    {
        extern int wait_platform_init_done(void);
        wait_platform_init_done();
    }
#endif /* _MSC_VER */

    init_pin();
    lcd_device = rt_device_find(LCD_DEVICE_NAME);

#ifdef BSP_USING_PM
    rt_event_init(&btn_event, "btn", RT_IPC_FLAG_FIFO);

    int8_t wakeup_pin;
    uint16_t gpio_pin;
    GPIO_TypeDef *gpio;

    gpio = GET_GPIO_INSTANCE(SLEEP_CTRL_PIN);
    gpio_pin = GET_GPIOx_PIN(SLEEP_CTRL_PIN);

    wakeup_pin = HAL_HPAON_QueryWakeupPin(gpio, gpio_pin);
    RT_ASSERT(wakeup_pin >= 0);

    pm_enable_pin_wakeup(wakeup_pin, AON_PIN_MODE_DOUBLE_EDGE);
    gui_ctx_init();
    gui_pm_init(lcd_device, pm_event_handler);
#endif /* BSP_USING_PM */

    /* init littlevGL */
    {
        rt_err_t r = littlevgl2rtt_init(LCD_DEVICE_NAME);
        RT_ASSERT(RT_EOK == r);
    }
#ifndef _WIN32
    if (!iw_touch_input_init())
    {
        LOG_E("touch input safety initialization failed; GUI startup stopped");
        return;
    }
#endif
    iw_display_wake_gate_init(&display_wake_gate);
#ifndef _WIN32
    /* CO5300 没有 SDK 的 TimeoutReset 回调；模式 2 先保住系统，再由项目层重新探测。 */
    (void)rt_device_control(lcd_device, SF_GRAPHIC_CTRL_ASSERT_IF_DRAWTIMEOUT, (void *)2);
#endif
    display_register_pointer_wake();

    if (!iw_recovery_init())
    {
        LOG_E("recovery layer allocation failed; GUI startup stopped");
        return;
    }
    if (!iw_key_feedback_init()) LOG_E("Key feedback unavailable");
    if (!iw_font_init(DroidSansFallback, (uint32_t)DroidSansFallback_size))
    {
        LOG_E("font registry initialization failed");
        return;
    }
#ifdef IW_TARGET_BUILD
    const iw_font_blob_t v00_fonts[4] = {
        {IWV00Noto300, (uint32_t)IWV00Noto300_size},
        {IWV00Noto400, (uint32_t)IWV00Noto400_size},
        {IWV00Noto500, (uint32_t)IWV00Noto500_size},
        {IWV00Noto600, (uint32_t)IWV00Noto600_size}
    };
    if (!iw_font_v00_init(v00_fonts)) {
        LOG_E("V00 font registry initialization failed");
        return;
    }
#endif
    (void)iw_display_runtime_set_available(lcd_device != RT_NULL,
                                           lcd_device ? 0 : -RT_ENOSYS);
    lv_ex_data_pool_init();
    resource_init();
    gui_app_init(1);
    iw_router_init();
#ifdef USING_BUTTON_LIB
    iw_product_set_lock_available(iw_key_port_can_unlock());
#endif

#ifdef BSP_USING_PM
    button_event_task = lv_timer_create(button_event_task_entry, 30, 0);
#endif /* BSP_USING_PM */

    keypad_default_handler_register(default_keypad_handler);
    LOG_I("Creating input device...");





    gui_app_run("iwlist");
    lv_disp_trig_activity(NULL);


    rt_tick_t last_font_sample = rt_tick_get();
    while (1)
    {
        uint32_t ms;
        input_service();
        display_process_pending();

        rt_pm_request(PM_SLEEP_MODE_IDLE);
        /* 排空期间保留服务和输入采集，只暂停提交新的页面绘制。 */
        ms = input_wait(gui_process_frame());
        rt_pm_release(PM_SLEEP_MODE_IDLE);
        (void)iw_font_collect();
        if ((rt_tick_t)(rt_tick_get() - last_font_sample) >= rt_tick_from_millisecond(FONT_SAMPLE_PERIOD_MS))
        {
            iw_font_sample();
            last_font_sample = rt_tick_get();
        }
        display_recover_if_faulted();

#ifdef BSP_USING_PM
        if (gui_is_force_close())
        {
            bool lcd_drawing;
            rt_device_control(lcd_device, RTGRAPHIC_CTRL_GET_BUSY, &lcd_drawing);
            if (lv_refreshing_done())
            {
                LOG_I("no input:%d", lv_disp_get_inactive_time(NULL));
                gui_suspend();
                LOG_I("ui resume");
                /* force screen to redraw */
                lv_obj_invalidate(lv_scr_act());
                /* reset activity timer */
                lv_disp_trig_activity(NULL);
            }
            else if (ms > 0)
            {
                iw_gui_wait(ms);       /* 统一处理有界等待和锁存唤醒。 */
            }
        }
        else
#endif  /* BSP_USING_PM */
        {
            //EventStartB(0);
            iw_gui_wait(ms);       /* 统一处理有界等待和锁存唤醒。 */
            //EventStopB(0);
        }

        if (first_loop)
        {
            /* 上电后使用模型中的当前目标，不回退到固定示例亮度。 */
            (void)display_apply_current_target();
            first_loop = 0;
        }
    }

}

void app_register(void)
{
}

int app_watch_init(void)
{
    return iw_boot_start_app_thread(&watch_thread, "app_watch", app_watch_entry, RT_NULL,
                                    watch_thread_stack, APP_WATCH_GUI_TASK_STACK_SIZE,
                                    RT_THREAD_PRIORITY_MIDDLE, RT_THREAD_TICK_DEFAULT);
}

#if !defined (_MSC_VER)
#define APP_MEM_THRESHOLD 16384
void *cxx_mem_allocate(size_t size)
{
    if (size > APP_MEM_THRESHOLD)
    {
        void *p = app_anim_mem_alloc(size, 1);
        rt_kprintf("Allocate %d, %p\n", size, p);
        return p;
    }
    else
        return rt_malloc(size);
}

extern int rt_in_system_heap(void *ptr);
void cxx_mem_free(void *ptr)
{
    if (rt_in_system_heap(ptr))
        rt_free(ptr);
    else
    {
        rt_kprintf("Free %p\n", ptr);
        app_anim_mem_free(ptr);
    }
}
#endif

INIT_APP_EXPORT(app_watch_init);
