zhangguotao05-zgt/iwatch/firmware/tests/d07_tiny_ttf_oom/test_product_view.c

#include "iw_product_view.h"
#include "iw_v00_scene.h"
#include "iw_v00_paint.h"
#include "test_v00_assets.h"
#include "test_v00_fonts.h"
#include "iw_gui_owner.h"
#include "iw_render_probe.h"
#include "src/draw/lv_draw_private.h"
#include "src/draw/sw/lv_draw_sw.h"
#include "src/draw/sw/lv_draw_sw_mask_private.h"
#include "src/core/lv_refr_private.h"
#include "src/misc/lv_text_private.h"
#include <assert.h>
#include <stdio.h>
#include <string.h>

extern void test_font_arm_failure(size_t index);
extern size_t test_font_live_bytes(void);
extern size_t test_font_live_blocks(void);
extern size_t test_font_allocation_sequence(void);
extern unsigned test_font_assert_count(void);
extern void test_component_capture(lv_display_t *, lv_obj_t *, unsigned);
extern bool test_component_capture_region_has_ink(lv_display_t *, lv_obj_t *, unsigned,
                                                   unsigned, unsigned, unsigned);

static const uint16_t product_pages[] = {IW_PAGE_FACE, IW_PAGE_FACE_PICKER, IW_PAGE_FACE_EDITOR,
                                         IW_PAGE_LAUNCHER_LIST, IW_PAGE_LAUNCHER_GRID,
                                         IW_PAGE_SETTINGS, IW_PAGE_DISPLAY,
                                         IW_PAGE_BRIGHTNESS, IW_PAGE_TIME, IW_PAGE_ABOUT,
                                         IW_PAGE_TIMER_LIST, IW_PAGE_TIMER_DETAIL, IW_PAGE_STOPWATCH};

static lv_point_t pointer_point;
static lv_indev_state_t pointer_state;
static unsigned pointer_actions, pointer_finals;
static uint16_t pointer_action;
static int32_t pointer_value;
static uint32_t pointer_tick_ms;
static uint32_t pointer_tick_get(void) { return pointer_tick_ms; }
static void read_pointer(lv_indev_t *input, lv_indev_data_t *data) {
    (void)input;
    data->point = pointer_point;
    data->state = pointer_state;
}
static void touch(lv_indev_t *input, int x, int y, bool down) {
    pointer_point = (lv_point_t){x, y};
    pointer_state = down ? LV_INDEV_STATE_PRESSED : LV_INDEV_STATE_RELEASED;
    lv_tick_inc(20);
    lv_indev_read(input);
}
static void pointer_action_cb(uint16_t action, int32_t value, bool final, void *context) {
    (void)context;
    pointer_actions++;
    pointer_finals += final;
    pointer_action = action;
    pointer_value = value;
}

static void picker_cases(lv_indev_t *input, iw_product_view_t *view, iw_product_model_t *m) {
    for (unsigned reduced = 0; reduced < 2; reduced++) {
        m->large_text = true;
        m->reduced_motion = reduced != 0;
        assert(iw_time_draft_begin(&m->draft, &m->clock));
        assert(iw_product_view_create(view, lv_screen_active(), IW_PAGE_TIME, m, pointer_action_cb, NULL, NULL));
        iw_product_view_scroll(view, 70);
        int saved_scroll = view->scroll_y;
        assert(saved_scroll > 0 && iw_time_draft_select(&m->draft, IW_EDIT_MONTH));
        assert(iw_product_view_update(view, m) && !view->scroll_y);
        lv_obj_update_layout(view->surface);
        pointer_actions = 0;
        /* 从选中行上拖超过半格，松手只产生一次候选变更，未直接提交日期。 */
        touch(input, 180, 220, true);
        touch(input, 180, 175, true);
        assert(view->picker_offset == -45);
        touch(input, 180, 175, false);
        assert(pointer_actions == 1 && pointer_action == IW_ACTION_PICK_STEP && pointer_value == 1);
        uint8_t original_month = m->draft.value.month;
        assert(iw_time_draft_step(&m->draft, pointer_value));
        assert(iw_product_view_update(view, m));
        assert(m->draft.value.month == original_month);
        assert(view->picker_snapping == !reduced);
        if (!reduced) {
            assert(view->picker_offset == 30);
            lv_tick_inc(95);
            assert(iw_product_view_tick(view) == 16);
            assert(view->picker_offset > 0 && view->picker_offset < 5);
        }
        lv_tick_inc(190);
        (void)iw_product_view_tick(view);
        assert(!view->picker_offset && !view->picker_snapping);
        /* 不到半格只回弹；输入取消必须丢弃尚未松手的动作。 */
        touch(input, 180, 220, true);
        touch(input, 180, 200, true);
        touch(input, 180, 200, false);
        assert(pointer_actions == 1);
        touch(input, 180, 220, true);
        touch(input, 180, 270, true);
        lv_indev_reset(input, NULL);
        touch(input, 180, 270, false);
        assert(pointer_actions == 1 && !view->picker_offset && !view->picker_snapping);
        iw_time_draft_cancel_field(&m->draft);
        assert(iw_product_view_update(view, m) && view->scroll_y == saved_scroll);
        assert(m->draft.value.month == original_month);
        assert(iw_product_view_destroy(view));
    }
    m->large_text = false;
}

static void input_cases(lv_display_t *display, iw_product_view_t *view, iw_product_model_t *m) {
    lv_indev_t *input = lv_indev_create();
    assert(input);
    lv_indev_set_type(input, LV_INDEV_TYPE_POINTER);
    lv_indev_set_read_cb(input, read_pointer);
    for (unsigned reduced = 0; reduced < 2; reduced++) {
        m->reduced_motion = reduced != 0;
        assert(iw_product_view_create(view, lv_screen_active(), IW_PAGE_SETTINGS, m, pointer_action_cb, NULL, NULL));
        lv_obj_update_layout(view->surface);
        pointer_actions = pointer_finals = 0;
        touch(input, 150, 145, true);
        lv_tick_inc(75);
        (void)iw_product_view_tick(view);
        assert(view->press_value == 1000 && !pointer_actions);
        lv_indev_reset(input, NULL);
        touch(input, 150, 145, false);
        assert(!pointer_actions);
        touch(input, 150, 145, true);
        touch(input, 150, 145, false);
        assert(pointer_actions == 1 && pointer_action == IW_PAGE_DISPLAY);
        assert(iw_product_view_destroy(view));
    }
    assert(iw_product_view_create(view, lv_screen_active(), IW_PAGE_ABOUT, m, pointer_action_cb, NULL, NULL));
    lv_obj_update_layout(view->surface);
    pointer_actions = 0;
    touch(input, 150, 340, true);
    touch(input, 150, 150, true);
    touch(input, 150, 150, false);
    assert(view->scroll_y > 0 && !pointer_actions);
    char wide[IW_PRODUCT_TEXT_BYTES];
    memset(wide, 'W', sizeof(wide) - 1);
    wide[sizeof(wide) - 1] = 0;
    const char *saved_firmware = m->firmware;
    m->firmware = wide;
    m->large_text = true;
    assert(iw_product_view_update(view, m));
    for (unsigned i = 0; i < view->scene.count; i++) {
        const iw_product_node_t *node = &view->scene.nodes[i];
        if (strcmp(node->text, wide)) continue;
        lv_point_t measured;
        const lv_font_t *font = NULL;
        for (unsigned f = 0; f < 7; f++)
            if (view->fonts[f].font && node->font_px == (unsigned[]){20, 22, 24, 26, 30, 64, 80}[f]) font = view->fonts[f].font;
        assert(font);
        lv_text_get_size(&measured, wide, font, 0, 0, node->width, LV_TEXT_FLAG_NONE);
        assert(node->height == measured.y + 12 && node->height > 150);
        assert(i + 1 < view->scene.count && view->scene.nodes[i + 1].y >= node->y + node->height);
    }
    m->firmware = saved_firmware;
    m->large_text = false;
    assert(iw_product_view_destroy(view));
    assert(iw_product_view_create(view, lv_screen_active(), IW_PAGE_BRIGHTNESS, m, pointer_action_cb, NULL, NULL));
    lv_obj_update_layout(view->surface);
    pointer_actions = pointer_finals = 0;
    touch(input, 120, 340, true);
    touch(input, 354, 340, true);
    touch(input, 354, 340, false);
    assert(pointer_action == IW_ACTION_TRACK && pointer_value == 100 && pointer_finals == 1);
    touch(input, 120, 340, true);
    lv_indev_reset(input, NULL);
    touch(input, 120, 310, false);
    assert(pointer_finals == 1);
    pointer_actions = pointer_finals = 0;
    touch(input, 50, 320, true);
    touch(input, 50, 320, false);
    assert(pointer_actions == 1 && pointer_finals == 1 && pointer_action == IW_ACTION_DIM);
    pointer_actions = pointer_finals = 0;
    touch(input, 340, 320, true);
    touch(input, 340, 320, false);
    assert(pointer_actions == 1 && pointer_finals == 1 && pointer_action == IW_ACTION_BRIGHTEN);
    assert(iw_product_view_destroy(view));

    /* 蜂窝桌面只把真实 READY 页面做成可点击磁贴，首项命中设置页。 */
    assert(test_v00_assets_load());
    assert(iw_product_view_set_v00_images(view, test_v00_assets_images(),
                                          IW_ICON_V00_ASSET_COUNT));
    assert(iw_product_view_create(view, lv_screen_active(), IW_PAGE_LAUNCHER_GRID, m,
                                  pointer_action_cb, NULL, NULL));
    lv_obj_update_layout(view->surface);
    pointer_actions = pointer_finals = 0;
    touch(input, 340, 140, true);
    touch(input, 340, 140, false);
    assert(pointer_actions == 1 && pointer_finals == 1 && pointer_action == IW_PAGE_SETTINGS);
    /* 蜂窝磁贴是圆形命中区，角落不能误触发；拖动和空白区双击分别平移和缩放。 */
    assert(view->cellular_icons[6] && view->cellular_bounds[6].action == IW_PAGE_SETTINGS);
    pointer_actions = pointer_finals = 0;
    touch(input, view->cellular_bounds[6].x + 2, view->cellular_bounds[6].y + 2, true);
    touch(input, view->cellular_bounds[6].x + 2, view->cellular_bounds[6].y + 2, false);
    assert(pointer_actions == 0);
    touch(input, 30, 120, true);
    touch(input, 50, 134, true);
    assert(pointer_actions == 1 && pointer_finals == 0 &&
           pointer_action == IW_ACTION_LAUNCHER_PAN &&
           pointer_value == (int32_t)((20u << 16) | 14u));
    touch(input, 68, 146, true);
    assert(pointer_actions == 2 && pointer_finals == 0 &&
           pointer_value == (int32_t)((18u << 16) | 12u));
    touch(input, 68, 146, false);
    assert(pointer_actions == 2 && pointer_finals == 0);
    /* 快速松手也提交最后一段位移；输入取消不得再次提交。 */
    pointer_actions = pointer_finals = 0;
    touch(input, 30, 120, true);
    touch(input, 68, 146, false);
    assert(pointer_actions == 1 && pointer_finals == 1 &&
           pointer_action == IW_ACTION_LAUNCHER_PAN);
    pointer_actions = pointer_finals = 0;
    touch(input, 30, 120, true);
    touch(input, 50, 134, true);
    assert(pointer_actions == 1 && pointer_finals == 0);
    lv_indev_reset(input, NULL);
    assert(lv_obj_send_event(view->surface, LV_EVENT_INDEV_RESET, NULL) == LV_RESULT_OK);
    touch(input, 68, 146, false);
    assert(pointer_actions == 1 && pointer_finals == 0);
    pointer_actions = pointer_finals = 0;
    touch(input, 5, 445, true);
    touch(input, 5, 445, false);
    touch(input, 5, 445, true);
    touch(input, 5, 445, false);
    assert(pointer_actions == 1 && pointer_finals == 1 && pointer_action == IW_ACTION_LAUNCHER_ZOOM);
    /* 输入取消必须清除待定双击；tick 为 0 时首个双击也必须有效。 */
    pointer_actions = pointer_finals = 0;
    touch(input, 5, 445, true);
    touch(input, 5, 445, false);
    assert(view->last_tap_valid);
    lv_indev_reset(input, NULL);
    assert(lv_obj_send_event(view->surface, LV_EVENT_INDEV_RESET, NULL) == LV_RESULT_OK);
    assert(!view->last_tap_valid);
    touch(input, 5, 445, true);
    touch(input, 5, 445, false);
    assert(pointer_actions == 0);
    lv_indev_reset(input, NULL);
    assert(lv_obj_send_event(view->surface, LV_EVENT_INDEV_RESET, NULL) == LV_RESULT_OK);
    lv_tick_get_cb_t previous_tick_get = lv_tick_get_cb();
    pointer_tick_ms = 0;
    lv_tick_set_cb(pointer_tick_get);
    touch(input, 5, 445, true);
    touch(input, 5, 445, false);
    pointer_tick_ms = 100;
    touch(input, 5, 445, true);
    touch(input, 5, 445, false);
    assert(pointer_actions == 1 && pointer_finals == 1 && pointer_action == IW_ACTION_LAUNCHER_ZOOM);
    pointer_actions = pointer_finals = 0;
    pointer_tick_ms = 200;
    touch(input, 5, 445, true);
    touch(input, 5, 445, false);
    pointer_tick_ms = 250;
    touch(input, 5, 445, true);
    touch(input, 5, 415, true);
    touch(input, 5, 390, true);
    touch(input, 5, 390, false);
    assert(pointer_actions >= 2 && pointer_finals == 0 &&
           pointer_action == IW_ACTION_LAUNCHER_ZOOM_DRAG && pointer_value > 0);
    lv_tick_set_cb(previous_tick_get);
    assert(iw_product_view_destroy(view));

    m->alarm_edit.hour = 6u;
    m->alarm_edit.minute = 45u;
    assert(test_v00_fonts_load());
    assert(iw_product_view_set_v00_images(view, test_v00_assets_images(),
                                          IW_ICON_V00_ASSET_COUNT));
    assert(iw_product_view_create(view, lv_screen_active(), IW_V00_ALARM_RUNTIME,
                                  m, pointer_action_cb, NULL, NULL));
    lv_obj_update_layout(view->surface);
    pointer_actions = pointer_finals = 0;
    touch(input, 250, 230, true);
    touch(input, 250, 202, true);
    touch(input, 250, 174, true);
    touch(input, 250, 174, false);
    assert(pointer_actions >= 2 && pointer_finals == 0 &&
           pointer_action == IW_ACTION_ALARM_WHEEL &&
           ((uint32_t)pointer_value >> 16) == 1u &&
           (int16_t)(uint16_t)pointer_value > 0);
    assert(iw_product_view_destroy(view));
    assert(iw_product_view_set_v00_images(view, NULL, 0u));
    test_v00_assets_release();
    assert(iw_font_collect());
    test_v00_fonts_release();

    /* 表盘长按只打开选择器一次，松手不能再误触发卡片。 */
    m->face_session = (iw_face_session_t){
        .schema = IW_FACE_SCHEMA, .active_face_id = IW_FACE_DIGITAL, .revision = 1u,
        .color = IW_FACE_COLOR_BLUE, .center = IW_FACE_CENTER_NONE,
        .left = IW_FACE_LEFT_SETTINGS, .right = IW_FACE_RIGHT_ABOUT};
    m->face_draft = (iw_face_draft_t){.value = m->face_session, .expected_revision = 1u, .valid = true};
    assert(iw_product_view_create(view, lv_screen_active(), IW_PAGE_FACE, m,
                                  pointer_action_cb, NULL, NULL));
    lv_obj_update_layout(view->surface);
    pointer_actions = pointer_finals = 0;
    touch(input, 195, 240, true);
    lv_tick_inc(700);
    touch(input, 195, 240, true);
    assert(pointer_actions == 1 && pointer_finals == 1 &&
           pointer_action == IW_ACTION_FACE_PICKER);
    touch(input, 195, 240, false);
    assert(pointer_actions == 1);
    assert(iw_product_view_destroy(view));

    /* 切换器使用横向手势；向左滑动只发出下一项动作，不触发卡片打开。 */
    static iw_recent_apps_t switcher_recent;
    memset(&switcher_recent, 0, sizeof(switcher_recent));
    switcher_recent.count = 2;
    switcher_recent.entries[0].app_id = IW_APP_SETTINGS;
    switcher_recent.entries[0].resume.route = (iw_route_t){IW_PAGE_SETTINGS, 0};
    switcher_recent.entries[1].app_id = IW_APP_STOPWATCH;
    switcher_recent.entries[1].resume.route = (iw_route_t){IW_PAGE_STOPWATCH, 0};
    m->recent_apps = &switcher_recent;
    m->recent_index = 0;
    assert(iw_product_view_create(view, lv_screen_active(), IW_PAGE_SWITCHER, m,
                                  pointer_action_cb, NULL, NULL));
    lv_obj_update_layout(view->surface);
    pointer_actions = pointer_finals = 0;
    touch(input, 195, 240, true);
    touch(input, 120, 240, true);
    touch(input, 120, 240, false);
    assert(pointer_actions == 1 && pointer_finals == 1 &&
           pointer_action == IW_ACTION_RECENT_NEXT);
    /* 删除文字必须实际进入像素缓冲，避免只有不可见命中区的假通过。 */
    assert(test_component_capture_region_has_ink(display, view->surface, 300u, 134u, 40u, 26u));
    assert(iw_product_view_destroy(view));
    m->recent_apps = NULL;

    picker_cases(input, view, m);
    lv_indev_delete(input);
}

static unsigned line_failures;
static void line_failed(void) { line_failures++; iw_gui_fault_raise(); }
static size_t line_case(lv_display_t *display, unsigned variant, size_t failure) {
    lv_draw_sw_mask_cleanup();
    lv_draw_buf_t *buffer = lv_draw_buf_create(128, 128, LV_COLOR_FORMAT_RGB565, LV_STRIDE_AUTO);
    assert(buffer);
    lv_layer_t layer = {0};
    layer.draw_buf = buffer;
    layer.color_format = LV_COLOR_FORMAT_RGB565;
    layer.buf_area = (lv_area_t){0, 0, 127, 127};
    lv_draw_task_t task = {0};
    task.target_layer = &layer;
    task.clip_area = layer.buf_area;
    lv_draw_line_dsc_t dsc;
    lv_draw_line_dsc_init(&dsc);
    dsc.p1 = (lv_point_precise_t){15, 15};
    dsc.p2 = (lv_point_precise_t){variant == 2 ? 15 : 70, variant == 1 ? 15 : 70};
    dsc.width = 8;
    dsc.opa = 255;
    dsc.color = lv_color_white();
    dsc.round_start = dsc.round_end = 1;
    dsc.allocation_failed_cb = line_failed;
    if (variant) { dsc.dash_width = 4; dsc.dash_gap = 3; }
    lv_refr_set_disp_refreshing(display);
    size_t before = test_font_allocation_sequence();
    test_font_arm_failure(failure);
    lv_draw_sw_line(&task, &dsc);
    size_t count = test_font_allocation_sequence() - before;
    test_font_arm_failure(0);
    assert((line_failures != 0) == (failure != 0));
    lv_draw_buf_destroy(buffer);
    lv_draw_sw_mask_cleanup();
    if (failure) assert(!iw_gui_fault_process());
    return count;
}

static iw_product_model_t fixture(void) {
    iw_product_model_t m = {
        .clock = {.utc_ms = INT64_C(1789610970000), .valid = true, .revision = 3, .offset_minutes = 480,
                  .source = IW_TIME_SOURCE_RTC},
        .message = IW_TEXT_COUNT,
        .display_available = true,
        .time_available = true,
        .lock_available = true,
        .back = true,
        .face_session = {.schema = IW_FACE_SCHEMA, .active_face_id = IW_FACE_DIGITAL,
                         .revision = 1u, .color = IW_FACE_COLOR_BLUE,
                         .center = IW_FACE_CENTER_NONE, .left = IW_FACE_LEFT_SETTINGS,
                         .right = IW_FACE_RIGHT_ABOUT},
        .hardware = "SF32LB58 A128",
        .firmware = "HOST FIXTURE",
        .toolchain = "HOST ASan"};
    m.brightness = (iw_brightness_snapshot_t){.desired = 80,
                                              .applied = 80,
                                              .flags = IW_BRIGHTNESS_FLAG_DESIRED_VALID |
                                                       IW_BRIGHTNESS_FLAG_APPLIED_VALID};
    m.face_draft = (iw_face_draft_t){.value = m.face_session, .expected_revision = 1u, .valid = true};
    assert(iw_time_draft_begin(&m.draft, &m.clock));
    return m;
}

typedef struct {
    uint8_t index;
    int16_t x, y, width, height;
} v00_expected_asset_t;

static void v00_assert_assets(const iw_product_scene_t *scene,
                              const v00_expected_asset_t *expected, unsigned count)
{
    for (unsigned i = 0; i < count; i++) {
        const v00_expected_asset_t *item = &expected[i];
        bool found = false;
        for (unsigned j = 0; j < scene->count; j++) {
            const iw_product_node_t *node = &scene->nodes[j];
            if (node->icon == IW_ICON_V00_APP_FIRST + item->index &&
                node->x == item->x && node->y == item->y &&
                node->width == item->width && node->height == item->height) {
                found = true;
                break;
            }
        }
        assert(found);
        assert((int)test_v00_assets_images()[item->index]->header.w == item->width);
        assert((int)test_v00_assets_images()[item->index]->header.h == item->height);
    }
}

static bool has_text(const iw_product_scene_t *scene, const char *text);
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
