zhangguotao05-zgt/iwatch/firmware/tests/d07_tiny_ttf_oom/test_router.c

#include "iw_router.h"
#include "iw_navigator.h"
#include "iw_scope.h"
#include "iw_components.h"
#include "iw_font_port.h"
#include "iw_gui_owner.h"
#include "iw_service.h"
#include "iw_router_text.h"
#include "iw_product_controller.h"
#include "iw_keys.h"
#include "iw_render_probe.h"
#include "src/core/lv_obj_private.h"
#include "src/core/lv_obj_class_private.h"
#include "src/core/lv_obj_style_private.h"
#include <assert.h>
#include <stdio.h>
#include <string.h>

extern void test_font_owner(bool owner, bool idle);
extern void test_font_arm_failure(size_t index);
extern size_t test_font_live_bytes(void);
extern size_t test_font_live_blocks(void);
extern size_t test_font_allocation_sequence(void);
extern unsigned test_font_assert_count(void);
extern void iw_gui_cancel_input(void);

typedef enum { GUI_APP_MSG_ONSTART, GUI_APP_MSG_ONRESUME, GUI_APP_MSG_ONPAUSE, GUI_APP_MSG_ONSTOP } gui_app_msg_type_t;
typedef void (*gui_page_msg_cb_t)(gui_app_msg_type_t, void *);
typedef struct {
    char app_id[16], page_id[16], back_page_id[16];
    void *user_data, *back_user_data;
    uint16_t running_apps, page_count;
    bool busy, back_valid, resumed, transitioning;
} gui_app_route_snapshot_t;
enum { RT_EOK = 0, LV_SWITCHANIM_NONE = 0, LV_SWITCHANIM_PRIOR_HIGHEST = 4, IW_GUI_WAKE_STATE = 2 };
typedef unsigned rt_base_t;
static unsigned irq_depth;
static rt_base_t rt_hw_interrupt_disable(void) { return irq_depth++; }
static void rt_hw_interrupt_enable(rt_base_t old) { assert(irq_depth == old + 1); irq_depth = old; }
static void iw_gui_wake(unsigned reason) { assert(!irq_depth && reason == IW_GUI_WAKE_STATE); }
static void *rt_calloc(size_t n, size_t size) { assert(!irq_depth); return lv_malloc_zeroed(n * size); }
static void rt_free(void *pointer) { assert(!irq_depth); lv_free(pointer); }
static int rt_kprintf(const char *format, ...) { (void)format; return 0; }
#define MSH_CMD_EXPORT(function, description)

/* 真正的 SDK 屏幕构造函数；只替换 RTOS 的消息/生命周期调度边界。 */
#include "route_screen_under_test.inc"
typedef struct {
    lv_obj_t *screen;
    void *data;
    gui_page_msg_cb_t handler;
    char name[16];
} fake_page_t;
static fake_page_t stack[8];
static unsigned depth, dispatch_index;
static int queued;
static fake_page_t queued_page;
static char queued_removal[16];
static unsigned queued_target_index;
static bool held_transition, hold_after_resume, reject_send, reject_page;
static bool drop_queued_back, fail_root_resume, hold_admitted_back;
static unsigned reject_back, reject_home;
static const char *active_app = "Main", *next_app;
static bool display_available = true;
static bool flip_display_after_first_read;
static unsigned capability_reads;
static uint32_t test_tick_ms;
static iw_service_t service;
static iw_time_state_t service_time;
static bool (*ready_callback)(void);

static uint32_t test_tick_get(void) { return test_tick_ms; }

static void notify_page(unsigned index, gui_app_msg_type_t event)
{
    dispatch_index = index;
    if (!index && event == GUI_APP_MSG_ONRESUME && fail_root_resume) {
        fail_root_resume = false;
        return;
    }
    if (stack[index].handler) stack[index].handler(event, NULL);
    else if (!index && !strcmp(active_app,"iwlist")) iw_router_root_event(IW_PAGE_LAUNCHER_LIST,(unsigned)event);
    else if (!index && !strcmp(active_app,"iwface")) iw_router_root_event(IW_PAGE_FACE,(unsigned)event);
}
static void *gui_app_this_page_userdata(void) { return stack[dispatch_index].data; }
static void gui_app_set_enter_anim_type(unsigned major, unsigned minor, unsigned aux)
{ assert(major == LV_SWITCHANIM_NONE && !minor && !aux); }
static void gui_app_set_exit_anim_type(unsigned major, unsigned minor, unsigned aux)
{ assert(major == LV_SWITCHANIM_NONE && !minor && !aux); }
static void gui_app_set_anim_prior(int enter, int exit)
{ assert(enter == LV_SWITCHANIM_PRIOR_HIGHEST && exit == LV_SWITCHANIM_PRIOR_HIGHEST); }
static void gui_app_set_resources_ready(bool (*ready)(void)) { ready_callback = ready; }
static int gui_app_create_page_ext(const char *name, gui_page_msg_cb_t handler, void *data)
{
    if (reject_send) { reject_send = false; return -1; }
    assert(!queued && strlen(name) < sizeof(queued_page.name));
    queued_page = (fake_page_t){.data = data, .handler = handler};
    memcpy(queued_page.name, name, strlen(name) + 1);
    queued = 1;
    return RT_EOK;
}
static int gui_app_goback(void)
{
    assert(!queued);
    if (reject_back) { reject_back--; return -1; }
    if (depth <= 1) return -1;
    queued = 2;
    return RT_EOK;
}
static int gui_app_goback_to_page(const char *name)
{
    assert(!queued);
    if (reject_back) { reject_back--; return -1; }
    for (unsigned i = 0; i < depth; i++)
        if (!strcmp(stack[i].name, name)) {
            queued_target_index = i;
            queued = 3;
            if (hold_admitted_back) {
                held_transition = true;
                hold_admitted_back = false;
            }
            return RT_EOK;
        }
    return -1;
}

static void gui_app_remove_page(const char *name)
{
    assert(!queued && strlen(name) < sizeof(queued_removal));
    memcpy(queued_removal, name, strlen(name) + 1u);
    queued = 5;
}

static int gui_app_run(const char *name)
{
    assert(!queued && (!strcmp(name, "Main") || !strcmp(name, "clock") || !strcmp(name,"iwface") || !strcmp(name,"iwlist")));
    if (reject_home) { reject_home--; return -1; }
    next_app = name; queued = 4;
    return RT_EOK;
}

static iw_snapshot_status_t iw_snapshot_read(iw_snapshot_topic_t topic, void *output, size_t capacity, size_t *required)
{
    assert(topic == IW_SNAPSHOT_CAPABILITIES || topic == IW_SNAPSHOT_ALERTS);
    if (topic == IW_SNAPSHOT_CAPABILITIES) {
        bool available = display_available;
        if (flip_display_after_first_read && capability_reads++ == 0u)
            display_available = false;
        assert(iw_service_set_capability(&service, IW_CAP_DISPLAY,
            available ? IW_CAP_STATE_AVAILABLE : IW_CAP_STATE_FAULT, 0));
    }
    /* 真实服务序列化与调用约束参与回归，只替换运行时互斥及时间采样。 */
    return iw_service_snapshot_read(&service, topic, output, capacity, required);
}
static int gui_app_get_route_snapshot(gui_app_route_snapshot_t *value)
{
    memset(value, 0, sizeof(*value));
    memcpy(value->app_id, active_app, strlen(active_app) + 1);
    memcpy(value->page_id, stack[depth - 1].name, sizeof(value->page_id));
    value->user_data = stack[depth - 1].data;
    value->running_apps = 1; value->page_count = (uint16_t)depth;
    value->resumed = true;
    value->busy = queued != 0 || held_transition;
    value->transitioning = held_transition;
    if (depth > 1) {
        memcpy(value->back_page_id, stack[depth - 2].name, sizeof(value->back_page_id));
        value->back_user_data = stack[depth - 2].data;
        value->back_valid = true;
    }
    return RT_EOK;
}
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
