zhangguotao05-zgt/iwatch/(commit log)

2026-09-15 Archive SF32LB58 watch hardware and design documentation
    [4mm磁吸母头_嘉立创专业版_封装草稿.epro, BOM_v0.1.csv, BOM_v0.2.csv, BOM_v0.3.csv, CWS05_24针接口核查.csv, HealthWatch-SF58-BareChip-v0.2.epro, HealthWatch-SF58-BareChip-v0.3.epro, HealthWatch-SF58-Offline-v0.1.epro]
2026-09-15 修复 D01-D03 生命周期、GUI 唤醒与构建来源校验
    [app_mainmenu.c]
2026-09-15 完成 D01-D03 板上验收并固定配套烧录
2026-09-15 收口 D01-D03 审批问题
2026-09-16 修复黑屏唤醒并增加 LCD 超时恢复
2026-09-16 补充 Keil 显示恢复源文件
2026-09-16 完善输入压力统计输出
2026-09-16 记录 D01-D03 最终板上验收
2026-09-16 实现 D04-D05 时间与服务基础
2026-09-16 收口 D04-D05 接口与实施记录
2026-09-16 固定 Keil 工程生成顺序
2026-09-16 固定 Keil 链接参数顺序
2026-09-16 修复冷启动服务会话重用
2026-09-16 记录 D04-D05 开发板验收
2026-09-16 建立 Issue 任务追踪规则
2026-09-16 修复D04-D05验收缺陷
2026-09-16 修复Keil干净构建检查顺序
2026-09-16 修正Keil工程源码路径
2026-09-16 修复Windows烧录脚本编码
2026-09-16 记录D04-D05整改复验
2026-09-16 feat: 完成 D06 会话亮度闭环
2026-09-16 docs: 记录 D06 最终验收身份
2026-09-16 fix: 收紧 D06 亮度确认与版本边界
    [iw_display.c, iw_display.h, test_display.c, test_service.c, watch_demo.c]
2026-09-16 docs: 收口 D06 整改验收
2026-09-16 test: 固化 D06 显示确认边界
2026-09-16 docs: 提交 D07 资源与组件审批方案
2026-09-16 docs: 修订 D07 资源与字体方案 v2
2026-09-16 feat(d07): 建立 A0 字体与安全工具链
2026-09-17 docs(d07): 封存 A0 实屏字体基线
2026-09-17 feat(d07): 实现 A1 兼容字体替换
2026-09-17 fix(d07): 统一RT-Thread内存统计类型
2026-09-17 fix(d07): 关闭不安全字距缓存并补全文压力测试
2026-09-17 fix(d07): 补齐 EPIC 字形缓存清理范围并验证像素
    [run_oom_matrix.py, test_epic_glyph.c, test_sdk_patch.py, test_tiny_ttf_oom.c]
2026-09-17 docs(d07): 记录字形破损根因与待上板修复包
2026-09-17 docs(d07): 归档 A1 字形修复实机验证与内存证据
2026-09-17 fix: close D07-A1 font OOM safety and manifest gaps
    [generate_lifecycle_test.py, run_oom_matrix.py, test_build_identity.py]
2026-09-17 fix: declare SDK render idle probe for target build
2026-09-17 docs: 记录 D07-A1 审批通过并启动 B
2026-09-17 feat(gui): 实现 D07-B 字体引用服务和只读主题
2026-09-17 fix(gui): 兼容 Keil 的 RTOS 堆统计类型
2026-09-17 docs: 归档 D07-B 双工具链结果和板测待办
2026-09-17 docs: 归档 D07-B 十次实机回归及延迟边界
2026-09-17 feat(gui): 实现 D07-C 共享组件和全局页面故障回收
2026-09-17 fix(gui): 页面开关先排空绘制避免返回饥饿
2026-09-17 docs: 归档 D07-C 实机复验和返回延迟修正
2026-09-17 docs: 整理 Apple Watch 设计指南与项目适配
2026-09-17 feat(gui): 补齐 D07-D 状态展示与综合故障回归
2026-09-17 docs: 归档 D07-D 实屏证据并保留性能复核项
2026-09-17 fix(input): cancel touch overflow until physical release
    [iw_drv_touch.c, iw_touch.h, iw_touch_input.c, iw_touch_input.h, run_oom_matrix.py, test_components.c, test_tiny_ttf_oom.c]
2026-09-17 docs(d07): archive touch overflow recovery and board validation
2026-09-17 实现 D08 页面作用域、导航事务和安全框架适配
2026-09-17 修复 D08 能力快照调用并接入真实服务回归
2026-09-17 记录 D08 修正版构建和待实机验收状态
2026-09-17 记录 D08 实机复验及未定位的显示异常
2026-09-17 fix(input): keep LVGL animation advancing during Home transitions
    [iw_router.c, test_router.c]
2026-09-17 fix(input): enforce touch locks across SDK device re-enable
    [iw_touch_input.c, iw_touch_input.h, test_touch_input.c, watch_demo.c]
2026-09-17 docs: record D09 board regressions and fixes for review
2026-09-17 实现 D10 七页、时间亮度闭环与受控图标绘制
2026-09-17 记录 D10 双工具链与边界检查，保留实机待验收
2026-09-18 fix(ui): allow first clock calibration with present degraded RTC
    [iw_product_controller.c, test_product_controller.c]
2026-09-18 docs: record D10 board flow checks and cold clock fix with display incident
2026-09-18 feat(ui): 完善 D10 选择器吸附、大字号重排与绘制采样
2026-09-18 docs(ui): 归档 D10 界面完善实机复验并提交架构复核
2026-09-18 fix(ui): 收口 D10 外观反馈与性能采样边界
    [iw_router.c, test_component_navigation.c, test_product_view.c, watch_demo.c]
2026-09-18 docs(d10): 记录七页往返与V08增量验收
2026-09-18 fix(ui): 修正禁用态布局并更新视觉证据
2026-09-18 docs(d10): 更新增量验收与构建归档
2026-09-18 test(d10): 覆盖请求处理中禁用态
2026-09-18 build(d10): 绑定最终提交构建身份
2026-09-18 docs(d10): 记录架构审批收口
2026-09-18 feat(d11): 实现计时器与秒表闭环
2026-09-18 build(d11): 纳入计时核心的 Keil 工程引用
2026-09-19 docs(d11): 归档双工具链与板上自动验收
2026-09-19 fix(d11): 限制计时重启并完善满容量反馈与日志复核
2026-09-19 docs(d11): 记录整改镜像实机复验与架构交接
2026-09-19 fix(d11): 按最新快照恢复计时容量按钮
2026-09-19 docs(d11): 归档容量恢复和 SDK 隔离验收
2026-09-19 docs(d11): 记录架构审批与收口边界
2026-09-20 docs(d12): record board validation and evidence checks
2026-09-20 docs(d12): align project status with board validation
2026-09-20 fix(d12): restore snoozed alerts and release acknowledged timers
    [iw_alarms.c, iw_alarms.h, iw_alerts.c, iw_alerts.h, iw_chronograph.c, iw_chronograph.h, iw_router.c]
2026-09-20 docs(d12): record state fixes and board revalidation
2026-09-20 fix: include D13 route identifiers in key routing
    [watch_demo.c]
2026-09-20 fix: 收口 D13-B 页面布局与实体点击校验
    [iw_product_controller.c, test_product_controller.c, test_product_view.c]
2026-09-20 test: 覆盖切换器点击与失效历史
2026-09-20 fix: 完善 D13-B 叠放切换器与控制中心
    [iw_product_controller.c, iw_router.c]
2026-09-20 fix: 完善实体失效提示与回归覆盖
2026-09-20 docs: 更新 D13-B 构建与复核状态
2026-09-20 fix: 完善最近应用删除和能力失效提示
2026-09-20 fix: 处理最近应用导航能力竞态
2026-09-21 fix D13 brightness control layout
    [test_product_view.c, test_settings_model.c]
2026-09-21 record D13 brightness board validation
2026-09-21 docs: 收口 D13-B 回归记录
2026-09-21 docs(d13): archive conditional C board validation
2026-09-21 fix(d13): defer watch face commit until root resume
    [iw_product_controller.h, iw_router.c, test_router.c]
2026-09-22 fix(d13): close face transaction races
    [iw_product_controller.c, iw_product_controller.h, iw_router.c, test_router.c]
2026-09-22 测试：固定生命周期夹具运行时
2026-09-22 docs: 归档D13-D开发板复核证据
2026-09-22 docs: 同步设计指南与D13-D取消证据
2026-09-22 docs: 标记D13-D架构复核通过
2026-09-22 docs: 记录D13-D已推送
2026-09-22 feat(d14): 落地蜂窝桌面第一批闭环
2026-09-22 docs(d14): 记录双工具链构建结果
2026-09-22 docs(d14): 关联独立验收 issue
2026-09-22 docs(d14): 归档蜂窝桌面实机验收
2026-09-26 feat(v00): integrate GCC baseline with controlled resources and view fixes
    [cell_transform_host.c, check_v00_paint_pixels.py]
2026-09-27 fix(router): retain alert screen while unlocking background lock chain
    [iw_router.c]
2026-09-28 feat(notifications): stage revision-bound clear and stale-detail handling
2026-09-28 test(cmake): track configure-time extraction sources
2026-09-28 test(notifications): cover router locks and view failure recovery
    [test_product_controller.c]
2026-09-28 fix(touch): isolate invalid FT6146 samples until trusted release
    [iw_drv_touch.c, test_components.c, test_configure_dependencies.py, test_touch_dependencies.py, test_touch_input.c]
